marcostrullato/open_niryo_one/README.md

# Open Niryo One

This is the Open Niryo One project. 

The original Niryo One Project is covering very well the structure of the arm and the mechanicanics, but it has some gaps with the electonics. 

Here with ***Open Niryo One*** we are developing what's missing.

Special thanks to the original project team for the great work. 
[https://niryo.com](https://niryo.com/?utm_source=github)
