marcostrullato/open_niryo_one/Electronics/RPi_adapter/pinmap.txt

N	FUNCTION	SIGNAL		PIN@PLS40
1	FAN1		GPIO27		13
2	FAN2		GPIO23		16
3	FAN3		PWM		?
4	BUTTON		GPIO4		7
5	SWERVO1_TX	USART_TXD	8
6	SWERVO1_RX	USART_RXD	10
5	SWERVO2_TX	USART_TXD	?
6	SWERVO2_RX	USART_RXD	?
7	CAN_MOSI	MOSI		19
8	CAN_MISO	MISO		21
9	CAN_CLK		CLK		23
10	CAN_CE		CE		24
11	LED-R		GPIO18		12
12	LED-G		GPIO24		18
13	LED-B		GPIO22		15

14	1A		GPIO2		3
15	1B		GPIO3		5
16	1C		GPIO16		36
17	2A		GPIO26		37
18	2B		GPIO19		35
19	2C		GPIO6		31
20	SW1		GPIO12		32
20	SW2		GPIO13		33
