marcostrullato/open_niryo_one/Electronics/Stepper/ErrorList.txt

1. Change LED to 0603 chip
2. Resister (R3) for LED 330 Ohm
3. Change USB mounting slots
4. Mirror USB pins
5. PCB size: -2mm from each side
