marcostrullato/open_niryo_one/Electronics/RPi_adapter/PCB/RpiAdapterPCB.PcbDoc.htm

Reporting Options

# File in Newer Format

Date | : | 16.02.2020
Time | : | 21:35:11
Filename | : | D:\SOFTWARE\open_niryo_one\Electronics\RPi_adapter\PCB\RpiAdapterPCB.PcbDoc

Version | Warning
Release 14 | CAUTION - The Differential Pairs Routing rule added support for control of the width. Be aware that these widths must be manually entered as Width rules in this version.
Release 15 | CAUTION - Support of separate solder masks for top & bottom of pads added.
Release 15.1 | CAUTION - Support Multi-line PCB Text added.
Release 16.0 | CAUTION - Pad/Via hole size tolerance value added.

This file was generated by a later version of the software
