marcostrullato/open_niryo_one/Electronics/Niryo_rpi3_shield_and_panel_overview.pdf

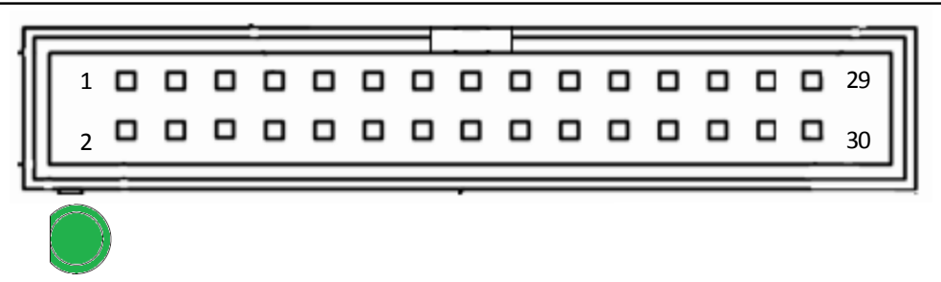
[picture p3: figure]
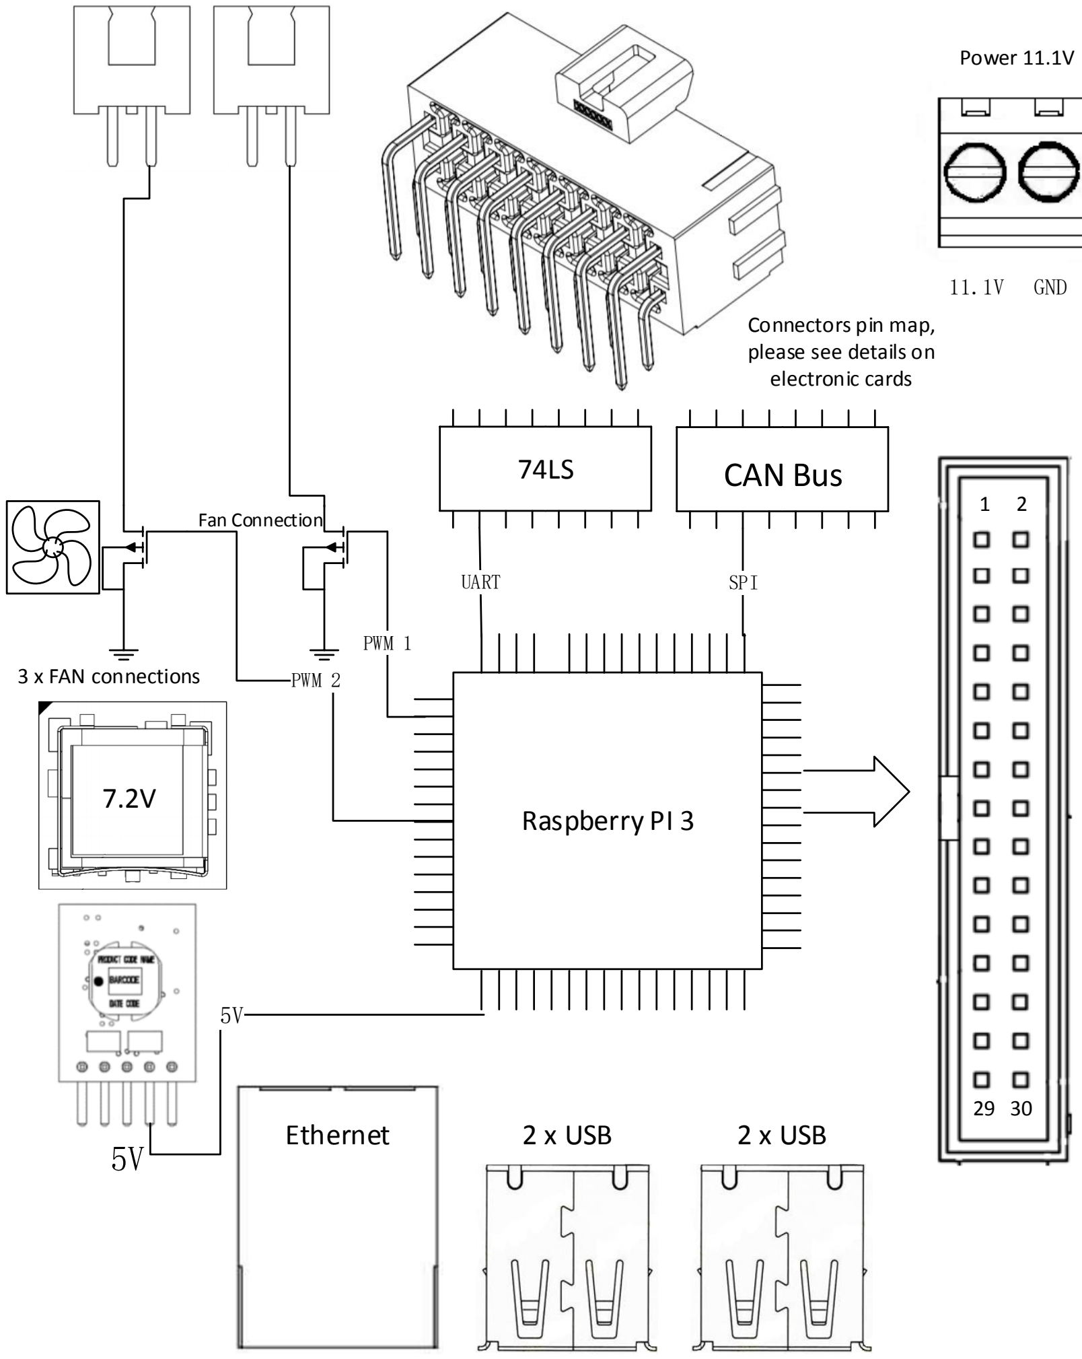
[picture p4: figure]
Raspberry PI 3; CAN Bus ⁷⁴LS; Power 11.1V; 3 x FAN connections; UART; SPI; PWM 2; PWM 1; GND; Fan Connection; Ethernet; 2 x USB; Connectors pin map, please see details on electronic cards

CANH CANL GND 11.1V | GND 7.2V DLX-Data1 | GND 11.1V
CANH CANL GND 11.1V | GND 11.1V

GND 5V 1A(IO2) 1B(IO3) 1C (IO16)

GND 5V 2A(IO26) 2B(IO19) 2C(IO6)
GND 7.2V DLX-Data2

NiryoShield Pin Map

Pin# | Name
01 | 7.2V DC Power
03 | DLX-Data
05 | 11.1V DC Power
07 | 11.1V DC Power
09 | 11.1V DC Power
11 | IO24
13 | GND
15 | GND
17 | GND
19 | GND
21 | 5V DC Power
23 | 5V DC Power
25 | IO2 SDA
27 | IO3 SCL
29 | IO16
Name | Pin#

7.2V DC Power 02

IO18 | 04
11.1V | 06
IO22 | 08
NC | 10
CANL | 12
CANH | 14
NC | 16
NC | 18
NC | 20
NC | 22
NC | 24
IO6 | 26
IO19 | 28
IO26 | 30

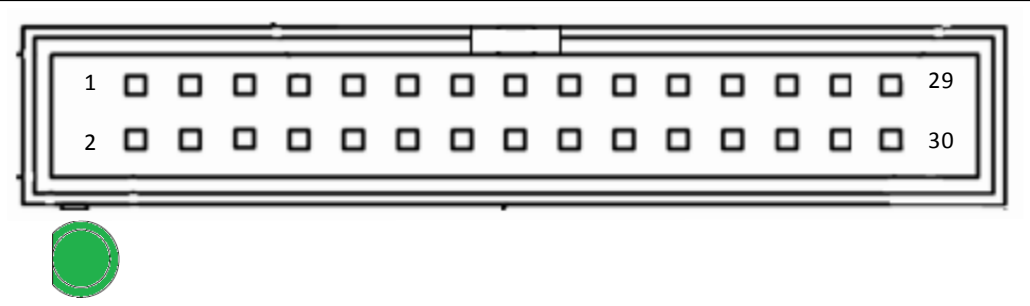
[picture p5: figure]

CANH CANL GND 11.1V GND 7.2V DLX-Data1 | GND 11.1V
CANH CANL GND 11.1V | GND 11.1V

GND 5V 1A(IO2) 1B(IO3) 1C (IO16)

GND 7.2V DLX-Data2 | GND 5V 2A(IO26) 2B(IO19) 2C(IO6)

Niryo Stepper 1

Niryo Stepper 2

XL-320

XL-430

SW1

SW2

GPIO1

GPIO2

## WARNING !

- Niryo Stepper 1 and Niryo Stepper 2 connectors are reserved. Don't use them.
- Only connect Dynamixel XL-320 motors to the XL-320 connector.
- Only connect Dynamixel XL-430 motors to the XL-430 connector.
- DO NOT short-circuit SW1 and SW2 pins.
- Absolute operating voltage of GPIO1 and GPIO2 connectors is 5V. External expander applications must operate at 5V. DO NOT short-circuit 5V and GND pins with any other pins.

! Wrong connection or wrong input voltage could permanently damage the robot or external micro-controller !
