marcostrullato/open_niryo_one/Electronics/Stepper/Components/mcp2515-can-bus-breakout-board-schematics.jpg

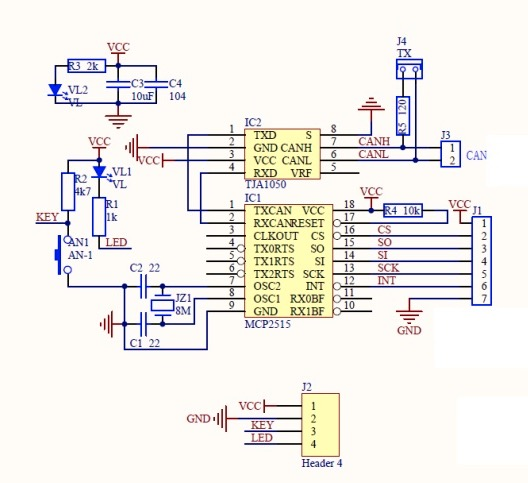
Electronics/Stepper/Components/mcp2515-can-bus-breakout-board-schematics.jpg
