marcostrullato/open_niryo_one/Electronics/Stepper/Render.png

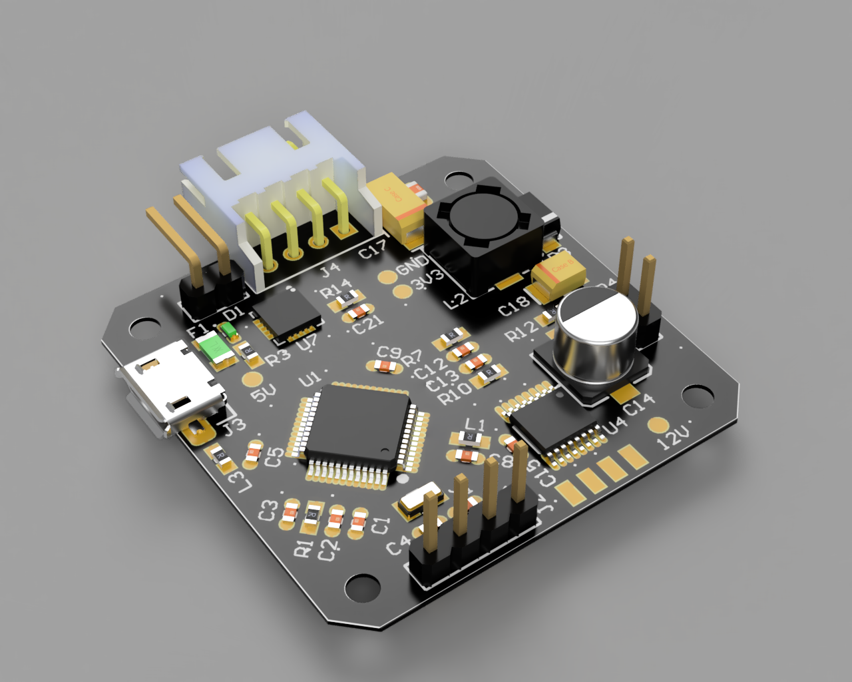
Electronics/Stepper/Render.png
