marcostrullato/open_niryo_one/BOM/Arm BOM.ods

Sheet: 3d_print_parts
What | Quantity
Base | 1
Belt Tensioner | 3
Base Bearing Support | 1
Shoulder | 1
Shoulder Gearing | 1
Belt Tensioner | 1
Round Tube | 4
Arm Bottom | 1
End Cap - Shoulder | 2
Arm Top | 1
Round Tube | 2
Belt Tensioner | 1
Elbow | 1
Foream Bottom | 1
Foream top | 1
Wrist | 1
Hand | 1
Drawer | 1
Air Routing | 3

Sheet: BOM_-_by_step
Step | What | Size | Quantity
Base | Motor | Orange NEMA 17 - 45 N.cm | 1
Base | Fan
Base | Button
Base | Bearing | 8x22x7 | 1
Base | Bearing | 3x10x4 | 3
Base | Brake nut | M3 | 2
Drawer | Screw | M2x5 | 4
Wrist | Screw | M2x5 | 4
Base | Gear | GT2 | 1
Shoulder | Motor | Yellow NEMA 17 - 65 N.cm | 1
Shoulder | Bearing | 3x10x4 | 2
Shoulder | Bearing | 8x22x7 | 2
Shoulder | Thrust Bearing | 8x19x7 | 1
Shoulder | Half Bearing | 90x120 | 1
Shoulder | Brake nut | M3 | 1
Elbow | Brake nut | M3 | 1
Drawer | Brake nut | M3 | 1
Drawer | Screw | M3x10 | 5
Base | Screw | M3x10 | 11
Shoulder | Screw | M3x10 | 10
Elbow | Screw | M3x10 | 10
Drawer | Screw | M3x16 | 2
Shoulder | Aluminium Tube |  | 1
Shoulder | Gear | GT2 | 1
Shoulder | Belt | GT2 | 1
Shoulder | Belt with red tape | GT2 | 1
Shoulder | Torsion spring |  | 1
Elbow | Motor | pink NEMA 17 - 65 N.cm | 1
Elbow | Motor | XL430 | 1
Elbow | Bearing | 3x10x4 | 2
Elbow | Bearing | 8x22x7 | 2
Elbow | Thrust Bearing | 8x19x7 | 1
Elbow | Thrust Bearing | 20x40x14 | 1
Elbow | Aluminium Tube |  | 1
Elbow | Coupling Shaft - Red motor |  | 1
Elbow | Gear | GT2 | 1
Elbow | Belt with green tape | GT2 | 1
Shoulder | Brake nut | M4 | 1
Elbow | Brake nut | M4 | 1
Drawer | Brake nut | M4 | 1
Elbow | Washer | M8 | 1
Base | Screw | M3x16 | 8
Shoulder | Screw | M3x16 | 6
Elbow | Screw | M3x16 | 2
Drawer | Screw | M3x5 | 2
Wrist | Screw | M3x5 | 2
Wrist | Motor | XL-430 | 1
Wrist | Motor | XL-320 | 1
Wrist | Bearing | 5x14x5 | 1
Wrist | Bearing | 6x19x6 | 1
Wrist | Coupling Shaft - Blue motor |  | 1
Wrist | Coupling Shaft - Green motor |  | 1
Wrist | Brake nut | M5 | 2
Wrist | Brake nut | M6 | 2
Wrist | Washer | M5 | 1
Drawer | Screw | M4x40 | 1
Shoulder | Screw | M4x40 | 1
Elbow | Screw | M4x40 | 1
Wrist | Screw | M5x40 | 1
Drawer | Ribbon cable |  | 1
Drawer | Raspi 3 |  | 1
Drawer | Panel |  | 1
Drawer | Shield |  | 1
Drawer | Label |  | 1
Drawer | DC Collector + cable |  | 1
Drawer | Power Switch |  | 1
Shoulder | Brake nut | M8 | 1
Elbow | Brake nut | M8 | 1
Wrist | Screw | M6x50 | 1
Elbow | Screw | M8x40 | 1
Shoulder | Screw | M8x55 | 1
Shoulder | Screw | M8x90 | 1
Elbow | Screw | M8x90 | 1

Sheet: BOM_-_overall
What | Size | Quantity
Bearing | 3x10x4 | 7
Bearing | 5x14x5 | 2
Bearing | 6x19x6 | 1
Bearing | 8x22x7 | 5
Aluminium Tube | 10 cm x 3.5 cm diameter | 2
Belt | GT2
Brake nut | M3 | 5
Brake nut | M4 | 3
Brake nut | M5 | 2
Brake nut | M6 | 2
Brake nut | M8 | 2
Fan | 12V 35x35 mm | 1
Button |  | 1
Gear | GT2, 16 teeth, 5mm hole | 3
Coupling Shaft - Red motor |  | 1
Coupling Shaft - Blue motor |  | 1
Coupling Shaft - Green motor |  | 1
DC Collector + cable | DC-022B | 1
Half Bearing | 90x120 | 1
Power Switch | KCD1 | 1
Screw | M2x5 | 8
Screw | DIN912 M3x10 | 36
Screw | DIN912 M3x16 | 18
Screw | DIN912 M3x5 | 4
Screw | DIN912 M4x40 | 3
Screw | DIN912 M5x40 | 1
Screw | DIN912 M6x50 | 1
Screw | DIN912M8x40 | 1
Screw | DIN912 M8x55 | 1
Screw | DIN912 M8x90 | 2
Washer | DIN9021 M5 | 1
Washer | DIN9021 M8 | 1
Thurst Bearing | 8x19x7 mm | 2
Thurst Bearing | 20x40x14 mm | 1
Belt | GT2 397 mm 6 mm | 1
Belt | GT2 345 mm 6 mm | 1
Belt | GT2 close 110 teeth 220 mm 6 mm
Torsion Spring |  | 1
Motor 45 N.cm | 17HS16-2004D | 1
Motor 65 N.cm | 17HS4218 | 2
Ribbon connector | IDC30 | 2
Ribbon 30 wires | 250 mm | 1
CAN bus connector | CHU-4 | 4

Sheet: BOM_-_Stepper_Shield
Type | Comment | Designator | Footprint | Quantity | Price, $ | Сost,$ | Analog | Comment2 | Availability
C | 0.1uF | C1, C3, C5, C7, C8, C9, C17, C18, C19, C20 | 0603 | 10 | 0,00405 | 0,0405 |  |  | +
C | 1uF | C2 | 0603 | 1 | 0,0045 | 0,0045 |  |  | +
C | 22pF | C4, C6, C21, C22 | 0603 | 4 | 0,0036 | 0,0144 |  |  | +
C | 10uF | C10 | 0603 | 1 | 0,0054 | 0,0054 |  |  | +
CE | 100uF x 35V | C11 | ALUM_CAP_D | 1 | 0,2346 | 0,2346 |  | electrolytic cap | +
C | 0.22uF | C12 | 0603 | 1 | 0,01495 | 0,01495 |  |  | +
C | 1uF*50V | C13 | 0805 | 1 | 0,01495 | 0,01495 |  |  | +
CT | 68uF x 16V | C14 | Tantal - C | 1 | 0,112 | 0,112 |  | Tantal cap | -
CT | 100uF x 10V | C15 | Tantal - B | 1 | 0,148 | 0,148 |  | Tantal cap | -
C | 4.7nF | C16 | 0603 | 1 | 0,0036 | 0,0036 |  |  | +
LED | KP-3216 | D1 | 1632 | 1 | 0 | 0 | not necessary | System LED | +
D | 1N4148WC | D2, D7 | SOD323 | 2 | 0,0088 | 0,0176 | 1N4148 | Reverse voltage protection | +
D | 10MQ040 | D3 | DO214-AC | 1 | 0,292 | 0,292 | 10MQ060 | Voltage Regulator diod | +
D | CG0603MLC-05E | D4, D5 | CG0603MLC-05E | 2 | 0,05 | 0,1 | SM6T27CA | USB ESD protection | -
D | US-1G | D6 | DO-214AB | 1 | 0,398 | 0,398 |  | Reverse voltage protection | +
F | 1206L050 | F1 | 1206 | 1 | 0,0636 | 0,0636 | MF-NSMF050-2 | Fuse 0,5 A | -
F | 1206L200 | F2 | 1206 | 1 | 0,035 | 0,035 | MF-NSMF200-2 | Fuse 2A | -
J | PLS-2 | JP1 | PLS-2 | 1 | 0,08 | 0,08 | not necessary | Fan connector | +
J | PLS-5 | J2 | PLS-5 | 1 | 0,09 | 0,09 |  | Boot connector | +
J | CUI UJ2-MIBH2-4-SMT-TR | J3 | UJ2-MIBH2-4-SMT | 1 | 0,1 | 0,1 |  | USB | -
J | CWF-4R | J4 | CWF-4R | 1 | 0,09 | 0,09 |  | power+CAN | +
J | PLS-2R | JP2 | PLS-2R | 1 | 0,08 | 0,08 |  | Terminator | +
L | BLM18PG601SH1 | L1, L3 | 0603 | 2 | 0,08 | 0,16 |  |  | +
L | CDRH74NP-101MC-B | L2 | CDRH74 | 1 | 0,1185 | 0,1185 |  | Voltage Regulator | +
Q | IRLML6402 | Q1 | SOT23 | 1 | 0,0415 | 0,0415 |  | Fan transistor coil | +
R | 10K | R1, R2, R11 | 0603 | 3 | 0,0062 | 0,0186 |  |  | +
R | 62R | R3 | 0603 | 1 | 0,0062 | 0,0062 | not necessary | LED resistor
R | 0R | R4 | 0R 0603 | 1 | 0,0062 | 0,0062 |  | CW/CCW selector | +
R | 4K7 | R5, R6 | 0603 | 2 | 0,0062 | 0,0124 |  |  | +
R | 0.15RF | R7, R8 | 1206 | 2 | 0,00995 | 0,0199 |  | Stepper LESS | -
R | 5K6F | R9 | 0603 | 1 | 0,0062 | 0,0062 |  | 1% tolerance | +
R | 3K32F | R10 | 0603 | 1 | 0,0062 | 0,0062 |  | 1% tolerance | +
R | 120R | R12 | 1206 | 1 | 0,004466667 | 0,004466667 |  | Terminator | +
U | ATSAMD21G18A-AUT | U1 | LQFP48 | 1 | 6 | 6 |  | Atmel processor
U | TC1047 | U2 | SOT23 | 1 | 0,18 | 0,18 |  | Temperature Sensor | -
U | AS5600 | U3 | SOIC8 | 1 | 1,84 | 1,84 |  | program magnetic rotary position sensor | -
U | A4954 | U4 | TSSOP-16 | 1 | 0,958 | 0,958 |  | DMOS PWM Motor Driver | -
U | LM2594M-ADJ | U5 | SOIC8 | 1 | 0,346 | 0,346 |  | Step-Down Voltage Regulator | +
U | SN65HVD230D | U6 | SOIC8 | 1 | 0,386 | 0,386 |  | CAN Bus Transceivers | -
U | MCP2515 | U7 | QFN20 | 1 | 0,89 | 0,89 |  | Stand-Alone CAN Controller With SPI | -
Y | NX3215SA-32.768K-STD-MUA-8 | Y1 | NX3215SA | 1 | 0,458 | 0,458 |  | Frequency resonator | -
Y | KX-K 16 MHZ | Y2 | 5032 | 1 | 0,095 | 0,095 |  | Frequency resonator | -
 | PCB |  |  | 1 | 1 | 1 |  |  | -
 |  |  |  |  |  | 14,49226667 |  |  | 12,1255
