marcostrullato/open_niryo_one/Electronics/RPi_adapter/OUT/R1/RPI_Hat_BOM.xlsx

Comment | Description | Designator | Footprint | Quantity
22pF |  | C1, C2 | 0603 | 2
0.1uF |  | C3, C4, C5, C6, C7 | 0603 | 5
25ZLQ470MEFC8X16 | 470uF x 25V | C8, C11, C14 | 8x16 | 3
3.3nF |  | C9, C15 | 0603 | 2
TANT 220uF 10V |  | C10, C16 | Tantal - D | 2
1nF |  | C12 | 0603 | 1
TANT 100uF 16V B3528 |  | C13 | Tantal - B | 1
SM6T30CA | ESD protection | D1 | DO-214AA | 1
10MQ040NTRPBF | Rectifier diode | D2, D3, D4, D5 | DO214-AC | 4
FH-100 | Fuse holder 5x20 mm | F1 | KLS5-266 | 2
5-146280-2 | Connector | J1 | PLS-2 | 1
XH2.54MM 4pins |  | J2 | CWF-4 | 1
XH2MM 3pins | Conector | J3 | DS1066-03 | 1
XH2.54MM 3pins | Conector | J4 | CWF-3 | 1
M20-7832046 |  | J5 | PBD40 | 1
70246-3001 |  | J6 | BH-30 | 1
5-146280-4 | PLS-4 | J7 | PLS-4 | 1
XH2.54MM 2pins | Connector | J8, J9, J10, J11 | CWF-2 | 4
MCV 1,5/ 2-G-3,81 |  | J12 | CON_2_5.08 | 1
CDRH74NP-680MC-B |  | L1, L2, L3 | CDRH74 | 3
IRLML2402TRPBF | n-chanal MOSFET | Q1, Q2, Q3, Q4, Q5, Q9 | SOT23 | 6
IRLML6402TRPBF | p-chanal MOSFET | Q6, Q7, Q8 | SOT23 | 3
10K |  | R1, R3, R4, R5, R6, R7, R8, R9, R10, R11, R12, R13, R14, R15, R16, R17, R18, R19 | 0603 | 18
120R |  | R2 | 1206 | 1
1K 1% |  | R20 | 0603 | 1
3K 1% |  | R21 | 0603 | 1
1.5K 1% |  | R22 | 0603 | 1
12K 1% |  | R23 | 0603 | 1
6.8K 1% |  | R24 | 0603 | 1
33K 1% |  | R25 | 0603 | 1
MCP2515T-I/ML |  | U1 | QFN20 | 1
SN65HVD230D |  | U2 | SOIC8 | 1
CD74HC126M96 |  | U3 | SOIC14 | 1
CD74HC04M |  | U4 | SOIC14 | 1
LM2596T-ADJ/NOPB |  | U5, U6, U7 | TO-220-5 | 3
NX5032GA-16.000M-STD-CSU-2 | 16 MHz cristal | Y1 | 5032 | 1
