marcostrullato/open_niryo_one/Electronics/RPi_adapter/OUT/R2/BOM.xlsx

Comment | Description | Designator | Footprint | Quantity
22pF |  | C1, C2 | CHIP_C_0603 | 2
0.1uF |  | C3, C4, C5, C6, C7 | CHIP_C_0603 | 5
470uF x 25V |  | C8, C11, C14 | ALCAP_8x16 | 3
3.3nF |  | C9, C15 | CHIP_C_0603 | 2
220uF x 10V |  | C10, C16 | Tantal - D | 2
1nF |  | C12 | CHIP_C_0603 | 1
100uF x 16V |  | C13 | Tantal - B | 1
SM6T30CA | ESD protection | D1 | DO-214AA | 1
10MQ040 | Rectifier diode | D2 | DO214-AC | 1
10MQ040(60) | Rectifier diode | D3, D4, D5 | DO214-AC | 3
FH-100 |  | F1 | FH-100 | 1
PLS-2 | Connector | J1 | PLS-2 | 1
CWF-4 |  | J2 | CWF-4 | 1
CWF-3(R) | Conector | J3 | DS1066-03 | 1
CWF-3(R) | Conector | J4 | CWF-3 | 1
PBD40 |  | J5 | PBD40 | 1
BH-30 |  | J6 | BH-30 | 1
PLS-4 | PLS-4 | J7 | PLS-4 | 1
CWF-2 | Connector | J8, J9, J10, J11 | CWF-2 | 4
MCV 1,5/ 2-G-3,81 |  | J12 | CON_2_5.08 | 1
CDRH74NP-680MC-B |  | L1, L2, L3 | CDRH74 | 3
IRLML6402 | p-chanal MOSFET | Q1, Q2, Q3, Q4, Q5, Q6 | SOT23 | 6
IRLML2402 | n-chanal MOSFET | Q7, Q8, Q9 | SOT23 | 3
10K |  | R1, R3, R4, R5, R6, R7, R8, R9, R10, R11, R12, R13, R14, R15, R16, R17, R18, R19 | CHIP_R_0603 | 18
120R |  | R2 | CHIP_R_1206 | 1
1K |  | R20 | CHIP_R_0603 | 1
3K |  | R21 | CHIP_R_0603 | 1
1K5 |  | R22 | CHIP_R_0603 | 1
12K |  | R23 | CHIP_R_0603 | 1
6K8 |  | R24 | CHIP_R_0603 | 1
33K |  | R25 | CHIP_R_0603 | 1
MCP2515 |  | U1 | QFN20 | 1
SN65HVD230D |  | U2 | SOIC8 | 1
74HC126 |  | U3 | SOIC14 | 1
74HC04 |  | U4 | SOIC14 | 1
LM2596-ADJ |  | U5, U6, U7 | TO-220-5 | 3
KX-K 16 MHZ |  | Y1 | CHIP_CRYSTAL_5032 | 1
