marcostrullato/open_niryo_one/Electronics/Stepper/OUT/R2/BOM.xlsx

Comment | Description | Designator | Footprint | Quantity
0.1uF |  | C1, C3, C5, C8, C9, C10, C12, C13, C20, C21, C22, C23 | 0603 | 12
1uF |  | C2 | 0603 | 1
22pF |  | C4, C6, C24, C25 | 0603 | 4
10uF x 6V3 |  | C11 | 0603 | 1
100uF x 35V | EEV107M035A9HAA | C14 | ALUM_CAP_D | 1
0.22uF |  | C15 | 0603 | 1
1uF |  | C16 | CHIP_C_0805 | 1
68uF x 16V | C6032 | C17 | TANTAL - C | 1
100uF x 10V | B3528 | C18 | Tantal - B | 1
4.7nF |  | C19 | 0603 | 1
APT1608QBC/D |  | D1, D4 | 0603 | 2
1N4148WC-7-F |  | D2 | SOD323 | 1
10MQ040NTRPBF | Rectifier diode | D3 | DO214-AC | 1
US-1G |  | D5 | DO214-AC | 1
1206L050YR | Fuse | F1 | 1206Lxxx | 1
1206L200PR | Fuse | F2 | 1206Lxxx | 1
5-146280-2 | PLS-2 | J1 | PLS-2 | 1
5-146280-4 | PLS-4 | J2 | PLS-4 | 1
TE 1981584-1 | Micro USB connector | J3 | MicroUSB-mc-258 | 1
XH2.54MM 4pins right | CWF-4 | J4 | CWF-4R | 1
L-KLS1-207-1-02-R | PLS-2R | JP1 | PLS-2R | 1
BLM18PG471SN1D |  | L1, L3 | 0603 | 2
CDRH74NP-101MC | Ferrite drum core construction | L2 | CDRH74 | 1
IRLML2402 | n-chanal MOSFET | Q1 | SOT23 | 1
10K |  | R1, R2, R14 | 0603 | 3
1K |  | R3, R12 | 0603 | 2
0R |  | R4 | 0603 | 1
4K7 |  | R5, R6 | 0603 | 2
0R |  | R7, R10 | 0603 | 2
0.15R 1% | Resistor | R8, R9 | 1206 | 2
5.6K 1% |  | R11 | 0603 | 1
3.32K 1% |  | R13 | 0603 | 1
120R |  | R15 | 1206 | 1
ATSAMD21G18-AUT |  | U1 | LQFP48 | 1
TC1047AVNBTR | Temperature Sensor | U2 | SOT23 | 1
AS5600-ASOM | program magnetic rotary position sensor | U3 | SOIC8 | 1
A4954ELPTR-T | DMOS PWM Motor Driver | U4 | TSSOP-16P | 1
LM2594M-ADJ/TR |  | U5 | SOIC8 | 1
SN65HVD230D |  | U6 | SOIC8 | 1
MCP2515T-I |  | U7 | QFN20 | 1
NX3215SA-32.768K-STD-MUA-8 | 32,768 KHz cristal | Y1 | NX3215SA | 1
NX5032GA-16.000M-STD-CSU-2 | 16 MHz cristal | Y2 | 5032 | 1
