marcostrullato/open_niryo_one/Electronics/RPi_adapter/Components/Nyrio_Adapter.png

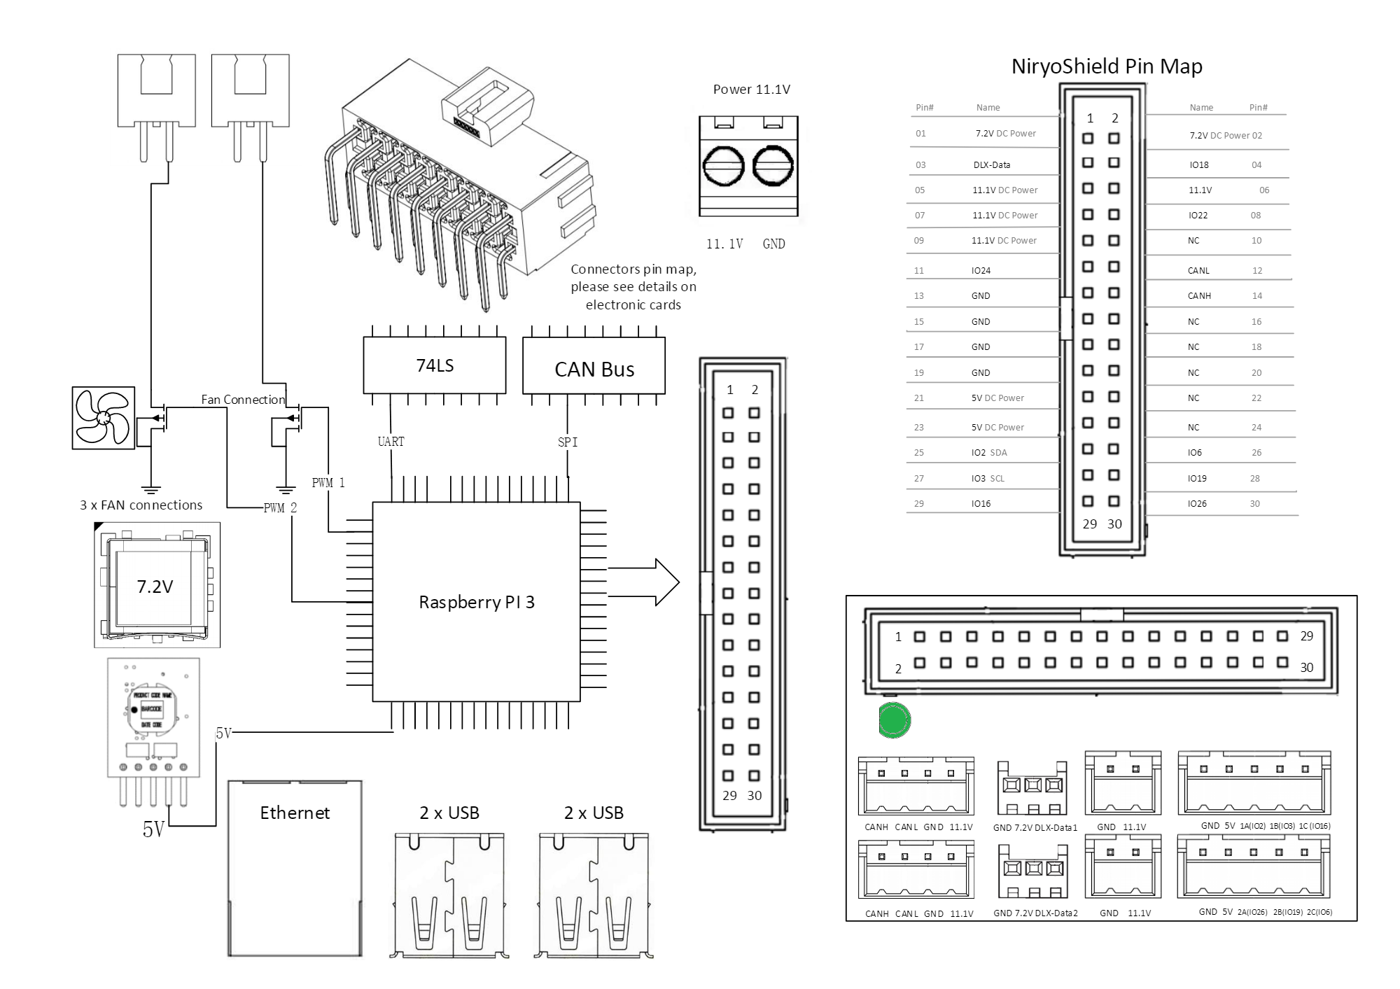
Electronics/RPi_adapter/Components/Nyrio_Adapter.png
