marcostrullato/open_niryo_one/STL/7-Tools/Gripper2/G2_MainSupport.STL

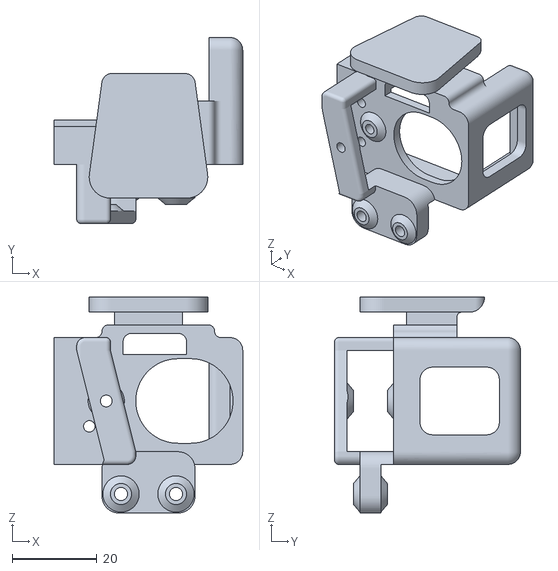
[picture p9: CAD file, 2019-08-29]
STL/7-Tools/Gripper2/G2_MainSupport.STL
44.6 x 44.0 x 51.1
