marcostrullato/open_niryo_one/STL/8-Other/AssemblyTool2.STL

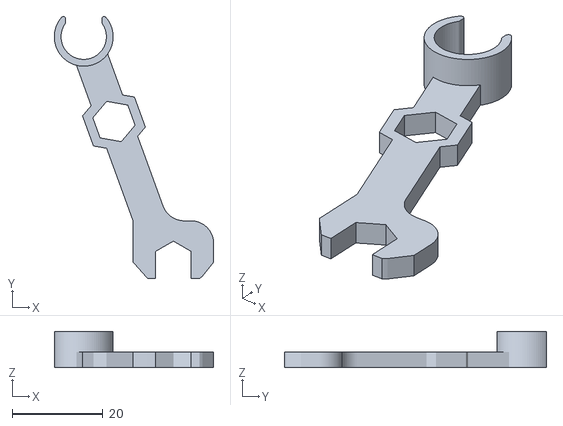
[picture p10: CAD file, 2019-08-29]
STL/8-Other/AssemblyTool2.STL
35.2 x 57.8 x 8.00
