marcostrullato/open_niryo_one/STL/8-Other/AssemblyTool1.STL

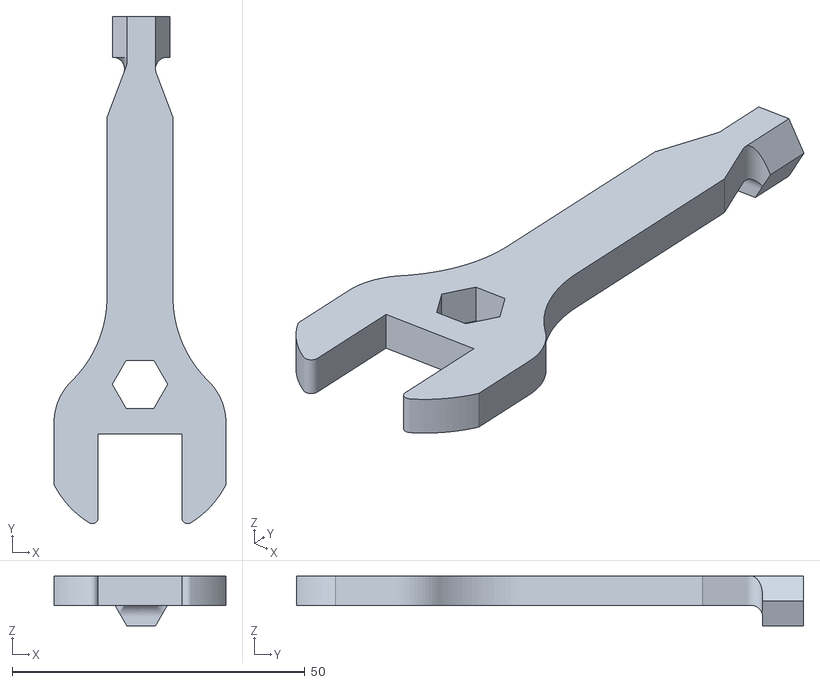
[picture p12: CAD file, 2019-08-29]
STL/8-Other/AssemblyTool1.STL
29.4 x 86.7 x 8.50
