marcostrullato/open_niryo_one/STL/7-Tools/Gripper1/G1_MainSupport.STL

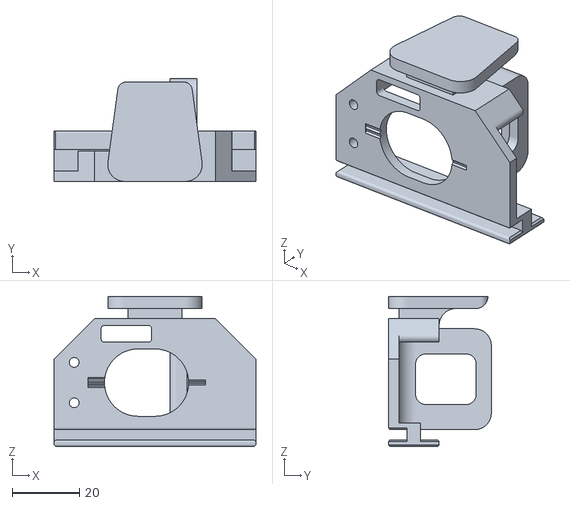
[picture p13: CAD file, 2019-08-29]
STL/7-Tools/Gripper1/G1_MainSupport.STL
60.0 x 30.5 x 44.6
