marcostrullato/open_niryo_one/Electronics/Panel/3D/PCB_shape.stp

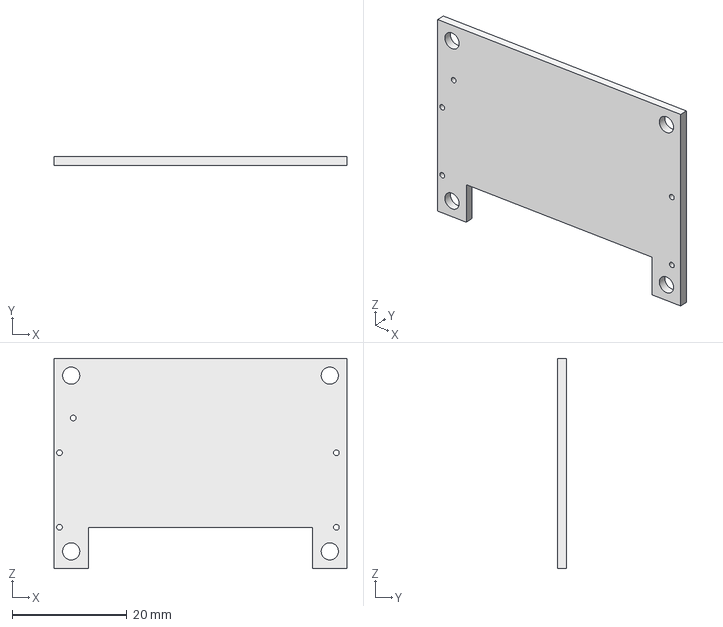
[picture p14: CAD file, 2022-10-08]
Electronics/Panel/3D/PCB_shape.stp
51.1 x 1.50 x 36.7 mm
