marcostrullato/open_niryo_one/Electronics/RPi_adapter/3D/INPUT_SIZE/PCB_shape.stp

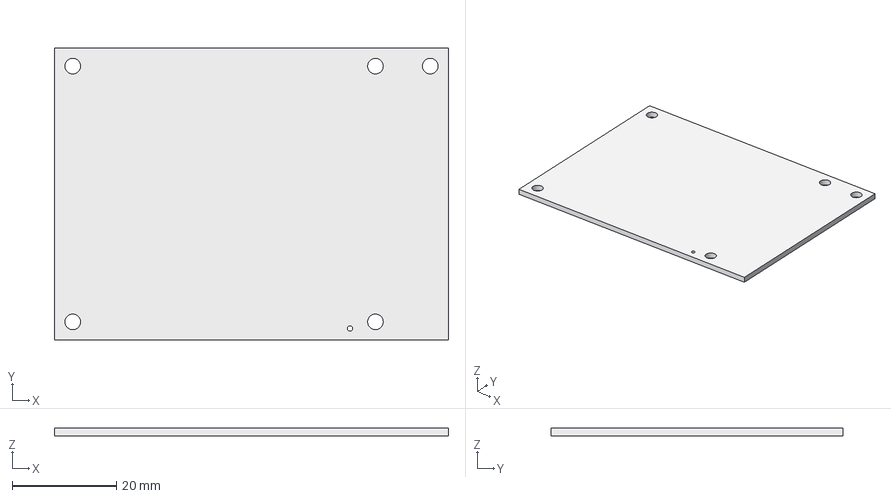
[picture p15: CAD file, 2022-10-08]
Electronics/RPi_adapter/3D/INPUT_SIZE/PCB_shape.stp
75.5 x 56.0 x 1.50 mm
