marcostrullato/open_niryo_one/Electronics/Stepper/3D/FAN/30mm Fan.step

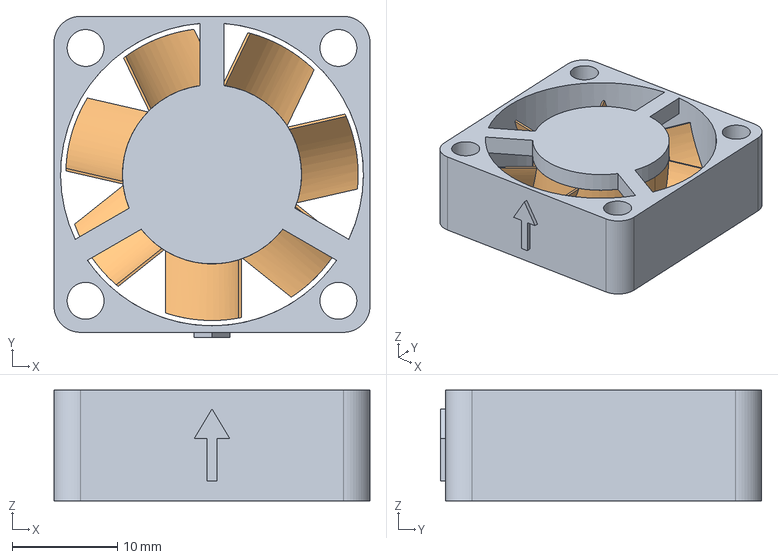
[picture p16: CAD file, 2022-10-08]
Electronics/Stepper/3D/FAN/30mm Fan.step
30.0 x 30.5 x 10.5 mm
