marcostrullato/open_niryo_one/Electronics/Stepper/3D/NEMA17/NEMA17 - Motor de passo.stp

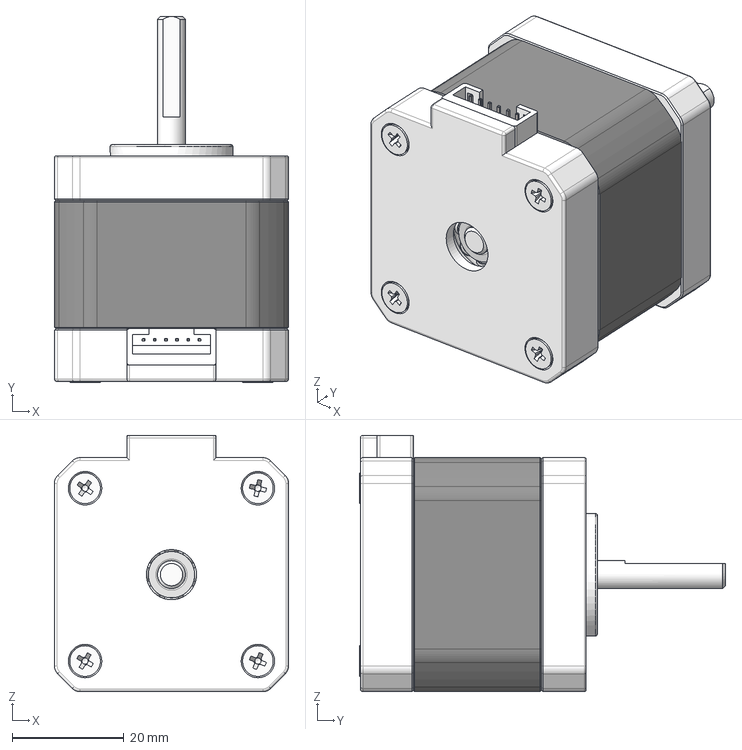
[picture p17: CAD file, 2022-10-08]
Electronics/Stepper/3D/NEMA17/NEMA17 - Motor de passo.stp
42.0 x 65.7 x 46.0 mm
