marcostrullato/open_niryo_one/Electronics/Stepper/3D/PCBmaket.stp

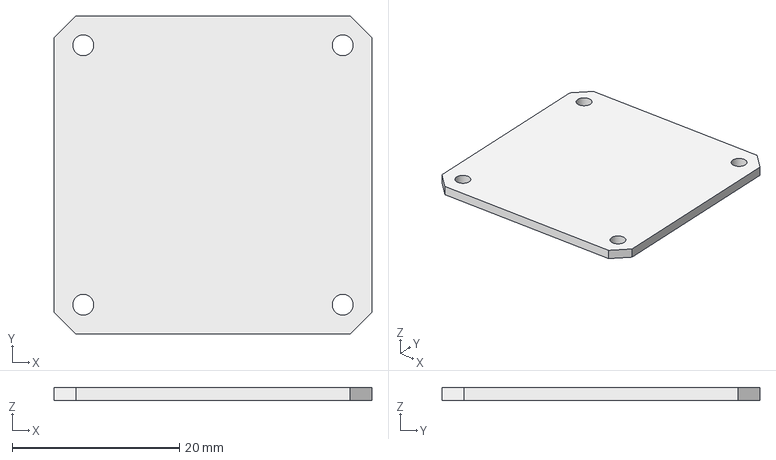
[picture p18: CAD file, 2022-10-08]
Electronics/Stepper/3D/PCBmaket.stp
38.0 x 38.0 x 1.50 mm
