marcostrullato/open_niryo_one/Electronics/Wiring/3D/CHU3.step

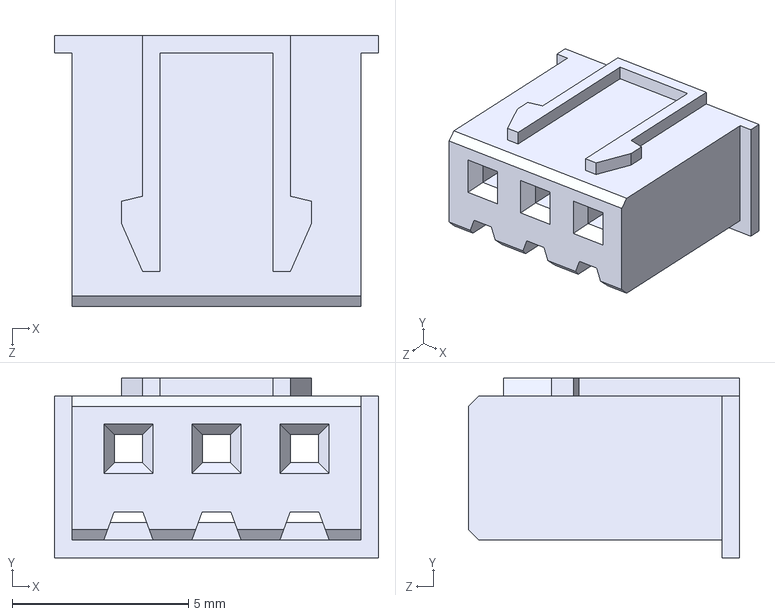
[picture p19: CAD file, 2022-10-08]
Electronics/Wiring/3D/CHU3.step
9.20 x 5.10 x 7.70 mm
