marcostrullato/open_niryo_one/Mechanic parts/STEP/Spring for Open Niryo One.stp

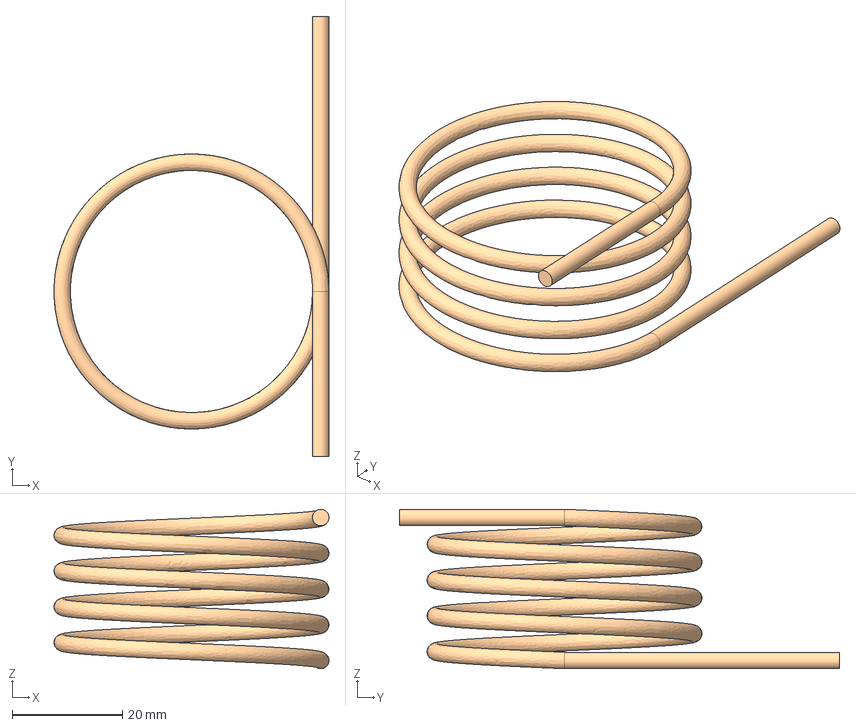
[picture p20: CAD file, 2022-10-08]
Mechanic parts/STEP/Spring for Open Niryo One.stp
50.0 x 80.0 x 29.0 mm
