marcostrullato/open_niryo_one/Mechanic parts/STL/Stepper spacer.stl

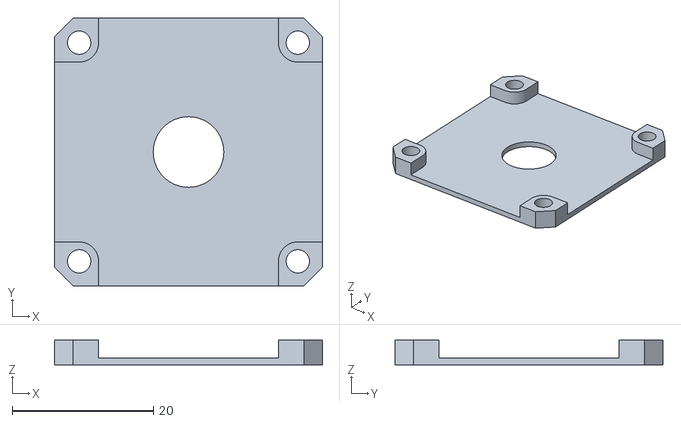
[picture p21: CAD file, 2022-10-08]
Mechanic parts/STL/Stepper spacer.stl
38.0 x 38.0 x 3.50
