marcostrullato/open_niryo_one/STL/0-Base/AirRouting.STL

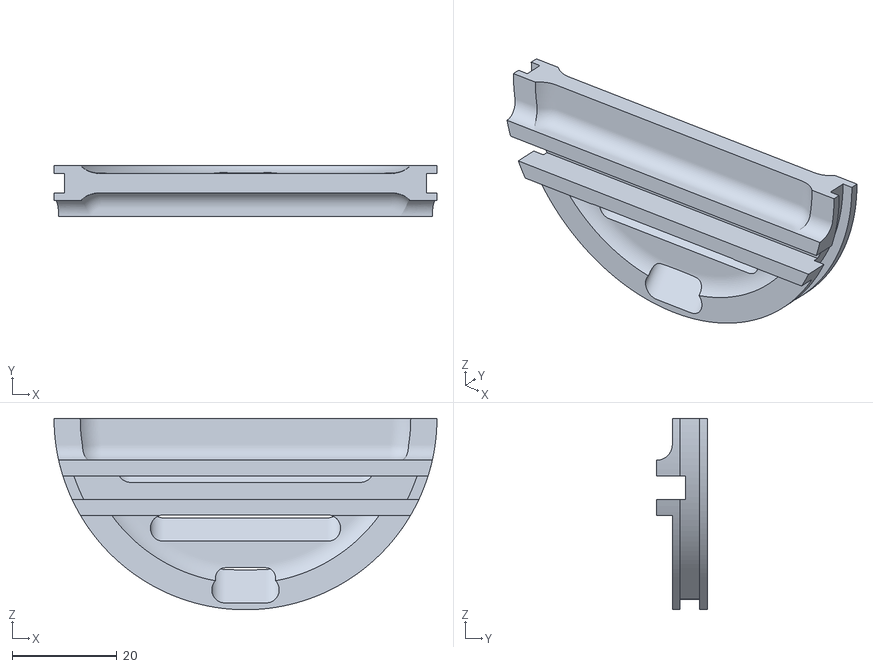
[picture p22: CAD file, 2019-08-29]
STL/0-Base/AirRouting.STL
73.0 x 9.70 x 36.5
