marcostrullato/open_niryo_one/STL/1-Shoulder/RoundTube.STL

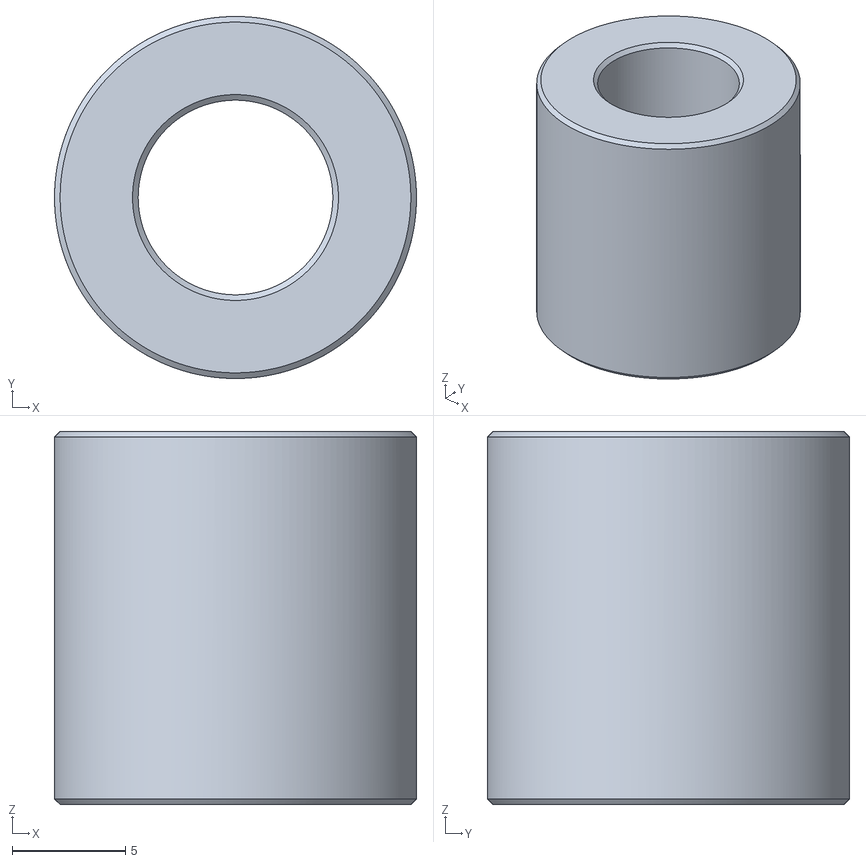
[picture p23: CAD file, 2019-08-29]
STL/1-Shoulder/RoundTube.STL
16.0 x 16.0 x 16.5
