marcostrullato/open_niryo_one/STL/2-Arm/EndCapArm.STL

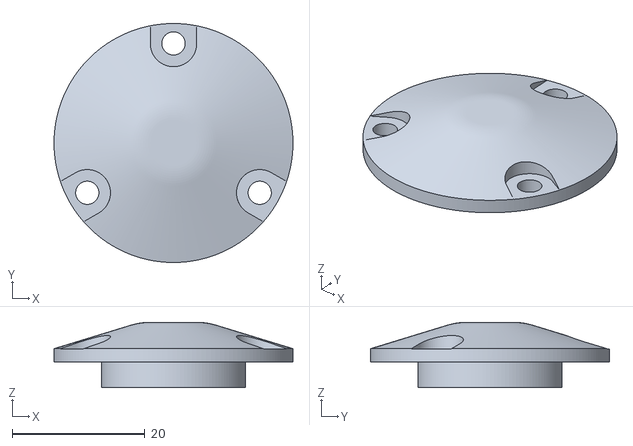
[picture p24: CAD file, 2019-08-29]
STL/2-Arm/EndCapArm.STL
36.0 x 36.0 x 9.85
