marcostrullato/open_niryo_one/STL/4-ForeArm/ForeArmBottom.STL

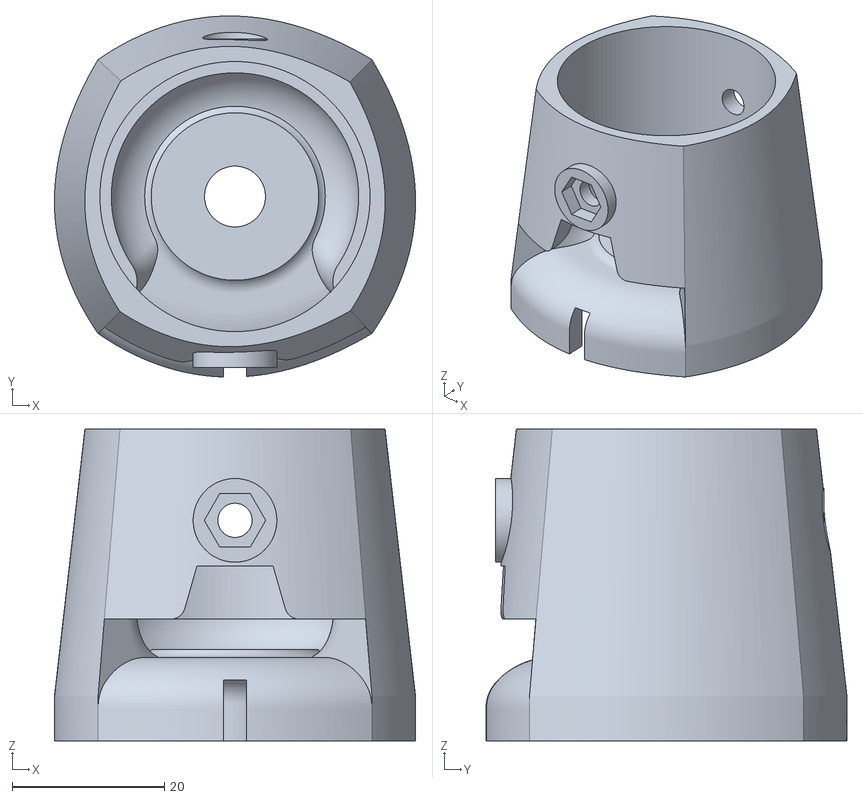
[picture p25: CAD file, 2019-08-29]
STL/4-ForeArm/ForeArmBottom.STL
47.5 x 47.4 x 41.0
