marcostrullato/open_niryo_one/STL/5-Wrist/Wrist.STL

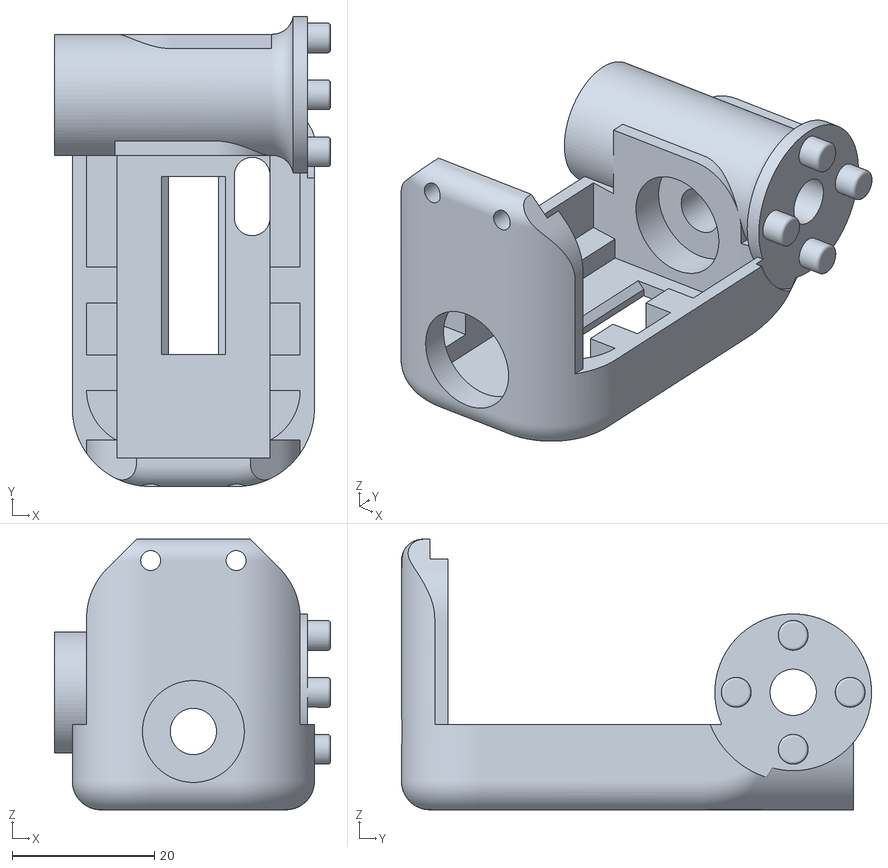
[picture p26: CAD file, 2019-08-29]
STL/5-Wrist/Wrist.STL
38.8 x 66.0 x 38.0
