marcostrullato/open_niryo_one/STL/6-Hand/Hand.STL

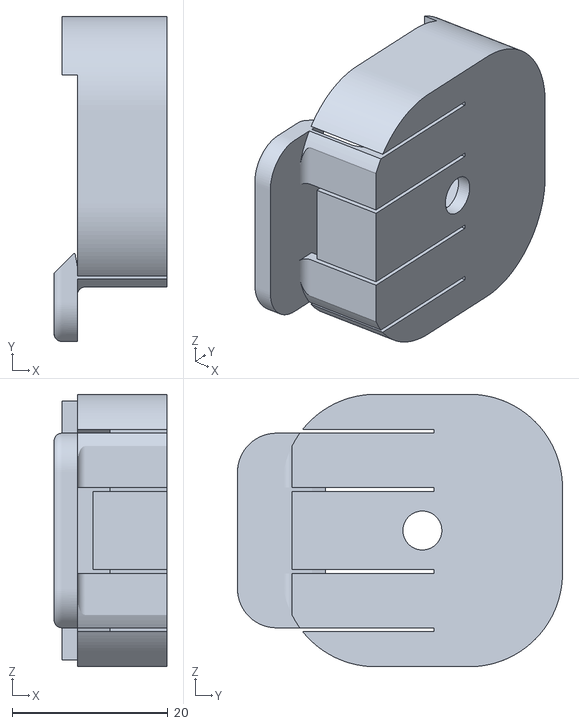
[picture p27: CAD file, 2019-08-29]
STL/6-Hand/Hand.STL
14.5 x 41.8 x 35.0
