marcostrullato/open_niryo_one/STL/7-Tools/Gripper1/G1_ClampRight.STL

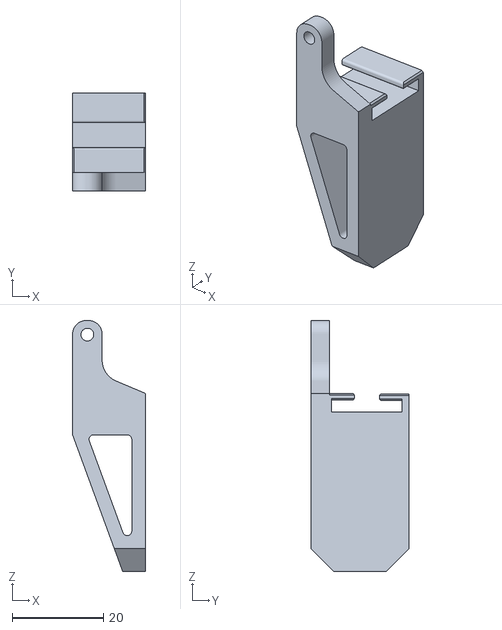
[picture p28: CAD file, 2019-08-29]
STL/7-Tools/Gripper1/G1_ClampRight.STL
16.0 x 21.5 x 55.1
