marcostrullato/open_niryo_one/STL/7-Tools/Gripper3/G3_Rod.STL

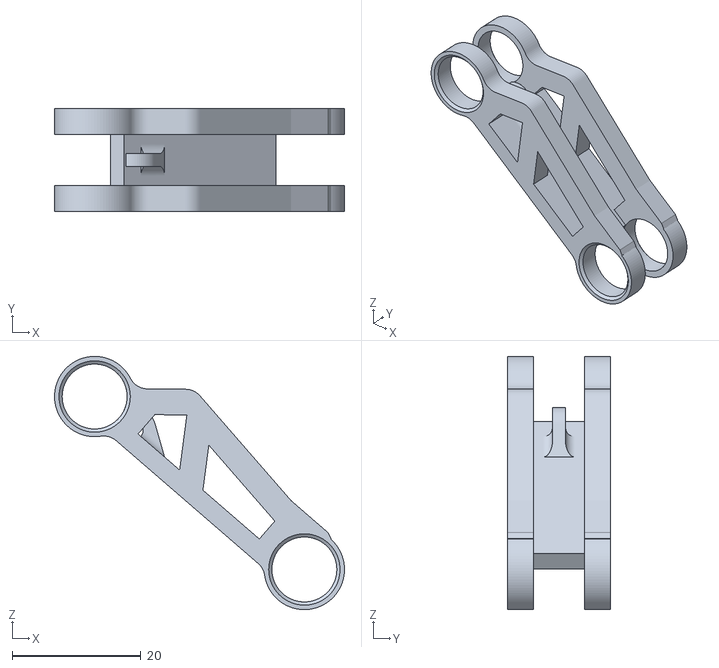
[picture p29: CAD file, 2019-08-29]
STL/7-Tools/Gripper3/G3_Rod.STL
45.1 x 16.0 x 39.4
