marcostrullato/open_niryo_one/STL/Tube/Niryo_One_Aluminum_Tube.stl

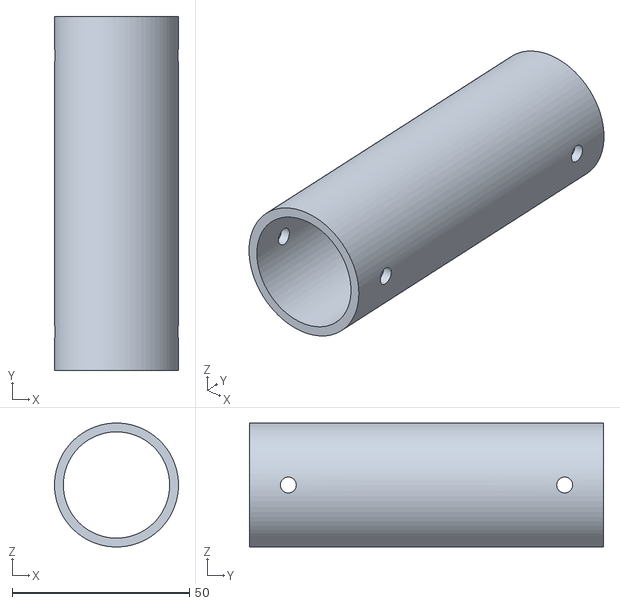
[picture p30: CAD file, 2022-10-08]
STL/Tube/Niryo_One_Aluminum_Tube.stl
35.0 x 100.0 x 35.0
