marcostrullato/open_niryo_one/Electronics/Wiring/3D/CHU2.step

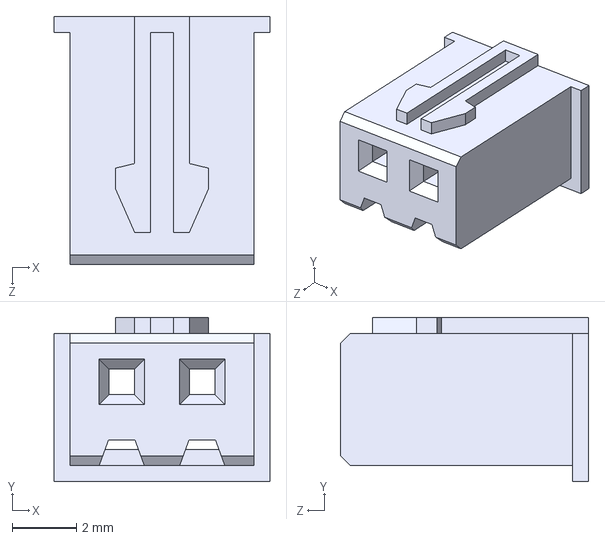
[picture p31: CAD file, 2022-10-08]
Electronics/Wiring/3D/CHU2.step
6.70 x 5.10 x 7.70 mm
