marcostrullato/open_niryo_one/Mechanic parts/STEP/Coupling Shaft Green Motor.stp

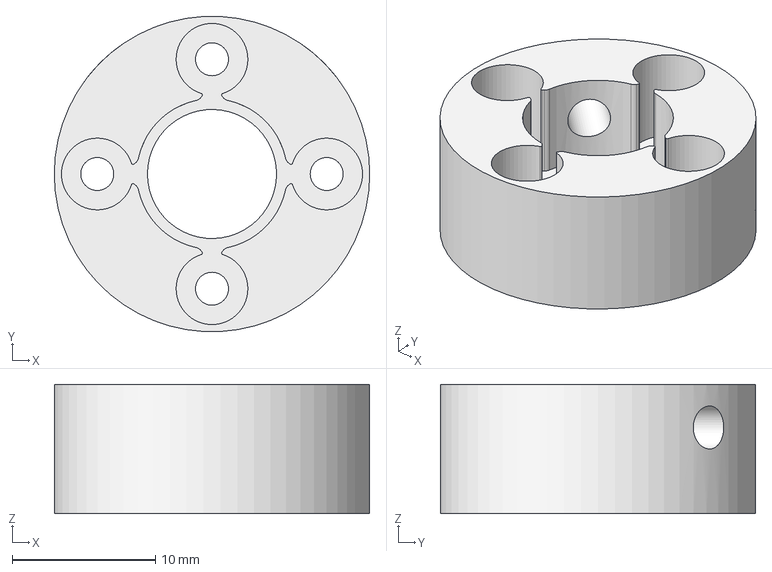
[picture p32: CAD file, 2022-10-08]
Mechanic parts/STEP/Coupling Shaft Green Motor.stp
22.0 x 22.0 x 9.00 mm
