marcostrullato/open_niryo_one/STL/0-Base/BaseBearingSupport.STL

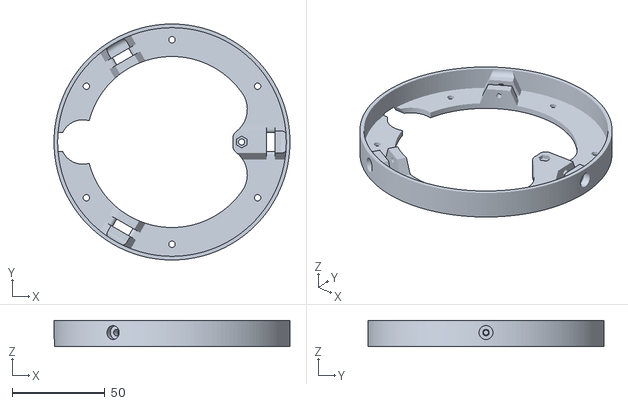
[picture p33: CAD file, 2019-08-29]
STL/0-Base/BaseBearingSupport.STL
127.0 x 127.0 x 14.0
