marcostrullato/open_niryo_one/STL/1-Shoulder/EndCapShoulder.STL

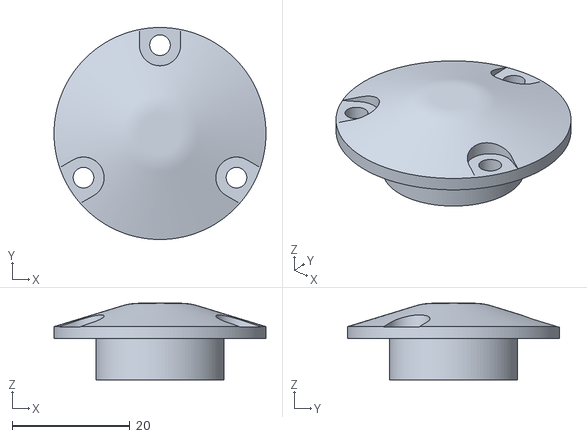
[picture p34: CAD file, 2019-08-29]
STL/1-Shoulder/EndCapShoulder.STL
36.0 x 36.0 x 13.0
