marcostrullato/open_niryo_one/STL/4-ForeArm/ForeArmTop.STL

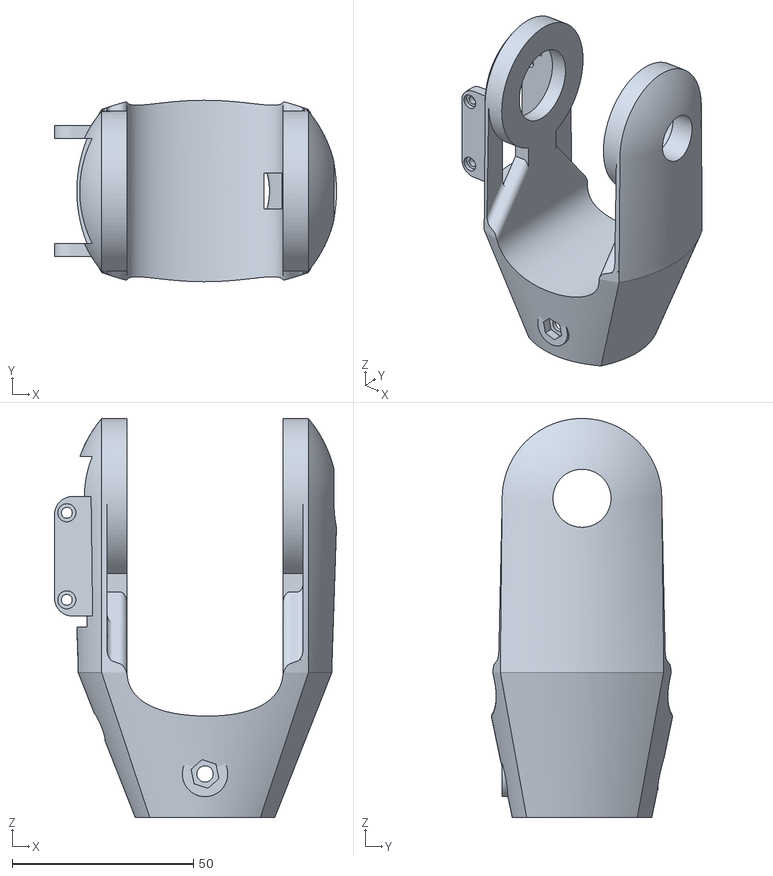
[picture p35: CAD file, 2019-08-29]
STL/4-ForeArm/ForeArmTop.STL
77.7 x 50.0 x 110.0
