marcostrullato/open_niryo_one/STL/7-Tools/Gripper1/G1_ServoHead.STL

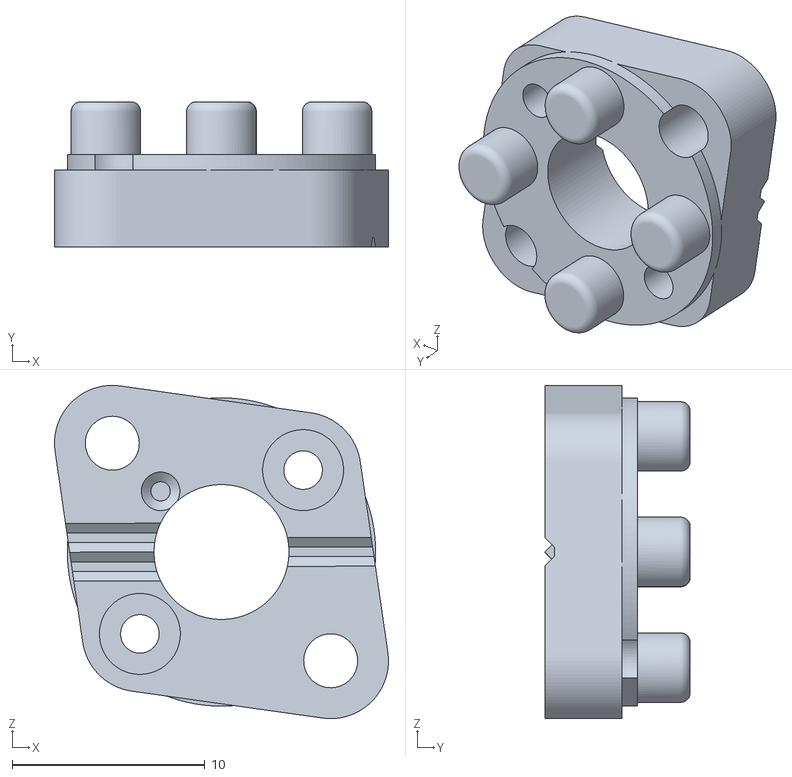
[picture p36: CAD file, 2019-08-29]
STL/7-Tools/Gripper1/G1_ServoHead.STL
17.3 x 7.55 x 17.3
