marcostrullato/open_niryo_one/STL/7-Tools/Gripper2/G2_GearRight.STL

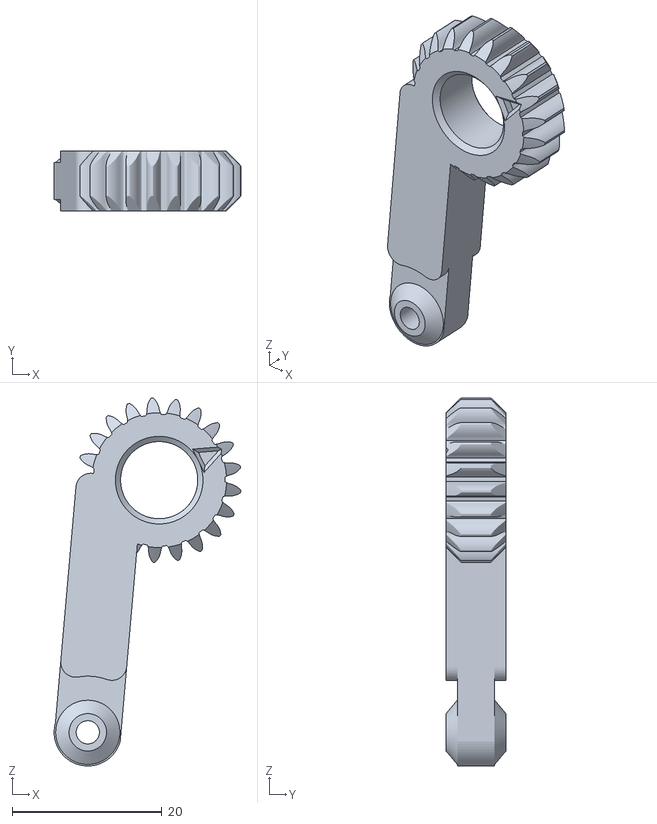
[picture p37: CAD file, 2019-08-29]
STL/7-Tools/Gripper2/G2_GearRight.STL
24.9 x 8.00 x 49.1
