marcostrullato/open_niryo_one/Electronics/Wiring/3D/CHU4.step

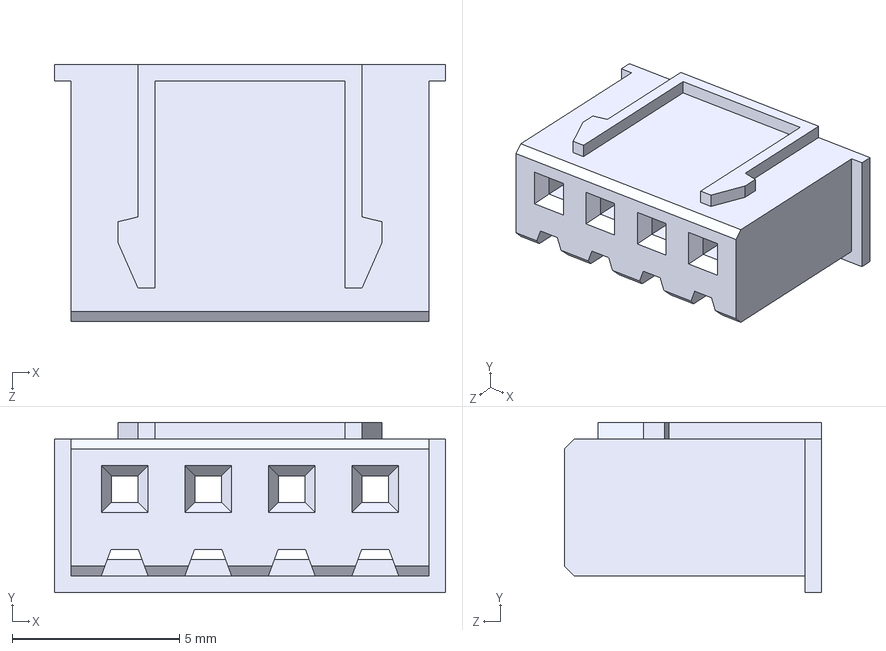
[picture p38: CAD file, 2022-10-08]
Electronics/Wiring/3D/CHU4.step
11.7 x 5.10 x 7.70 mm
