marcostrullato/open_niryo_one/Mechanic parts/STEP/Steal for Gripper1.stp

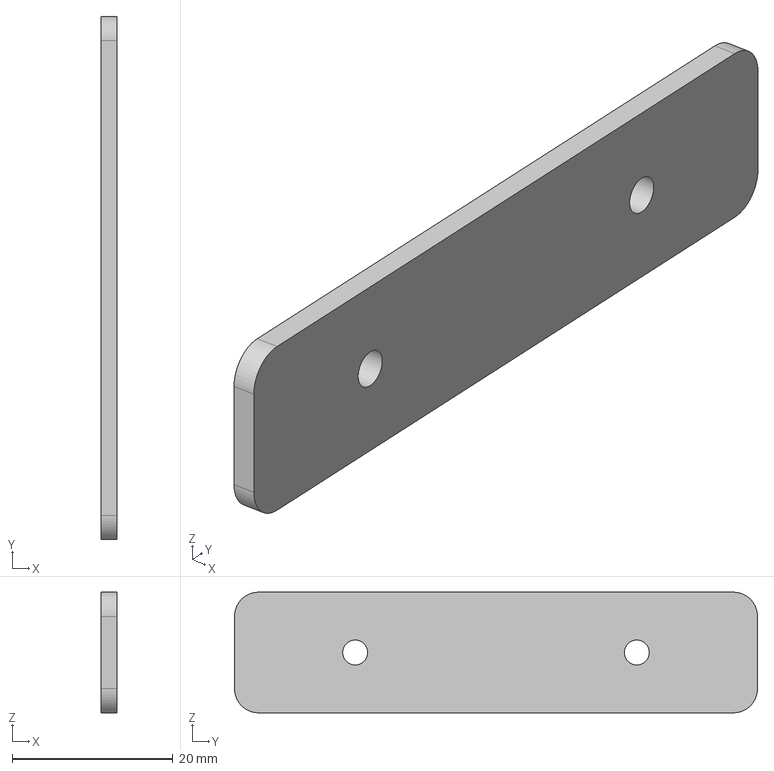
[picture p39: CAD file, 2022-10-08]
Mechanic parts/STEP/Steal for Gripper1.stp
2.00 x 65.0 x 15.0 mm
