marcostrullato/open_niryo_one/STL/0-Base/Base.STL

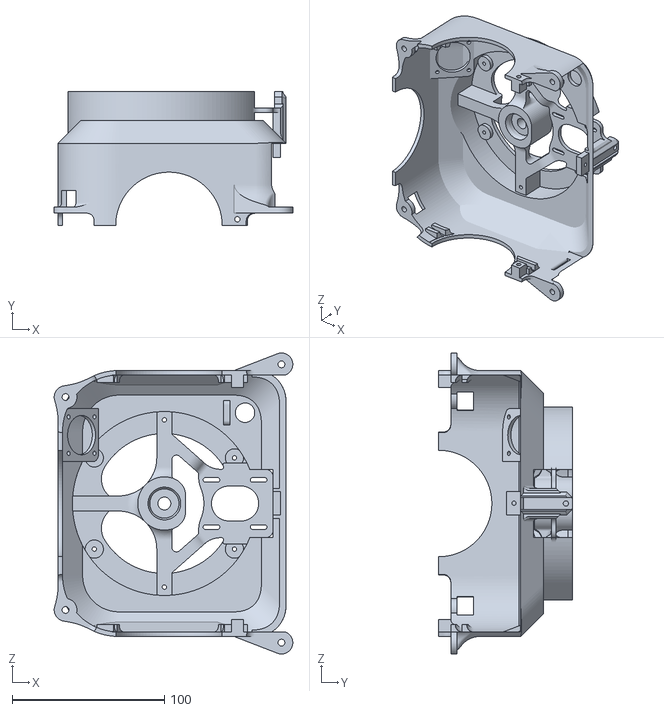
[picture p40: CAD file, 2019-08-29]
STL/0-Base/Base.STL
157.0 x 88.0 x 198.0
