marcostrullato/open_niryo_one/STL/7-Tools/Gripper1/G1_Rod.STL

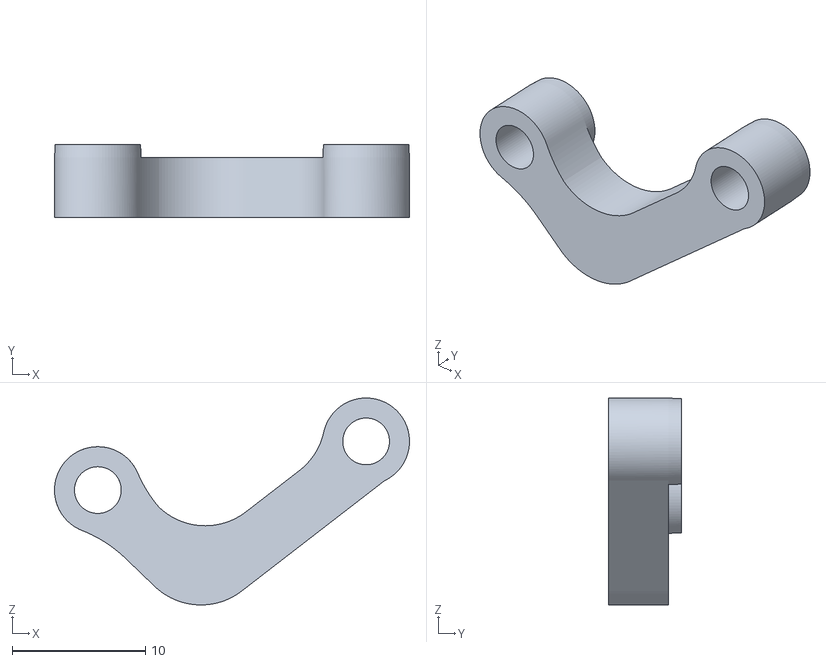
[picture p41: CAD file, 2019-08-29]
STL/7-Tools/Gripper1/G1_Rod.STL
26.6 x 5.50 x 15.5
