marcostrullato/open_niryo_one/STL/7-Tools/Gripper2/G2_Clamp.STL

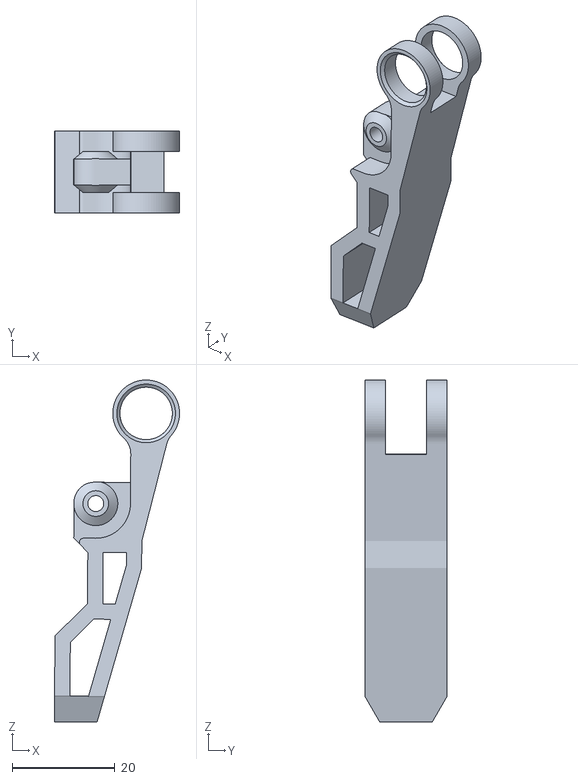
[picture p42: CAD file, 2019-08-29]
STL/7-Tools/Gripper2/G2_Clamp.STL
24.3 x 16.0 x 66.5
