marcostrullato/open_niryo_one/STL/7-Tools/Gripper3/G3_Link1.STL

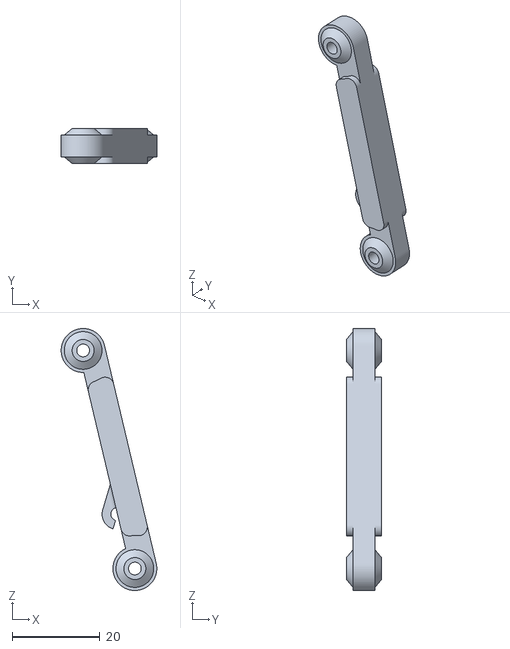
[picture p43: CAD file, 2019-08-29]
STL/7-Tools/Gripper3/G3_Link1.STL
21.8 x 8.00 x 59.6
