marcostrullato/open_niryo_one/STL/8-Other/Foot.STL

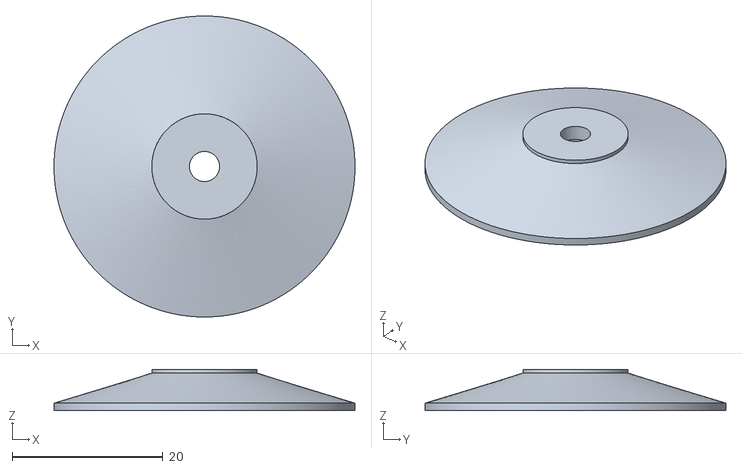
[picture p44: CAD file, 2019-08-29]
STL/8-Other/Foot.STL
40.0 x 40.0 x 5.50
