marcostrullato/open_niryo_one/Mechanic parts/STEP/Coupling Shaft Blue Motor.stp

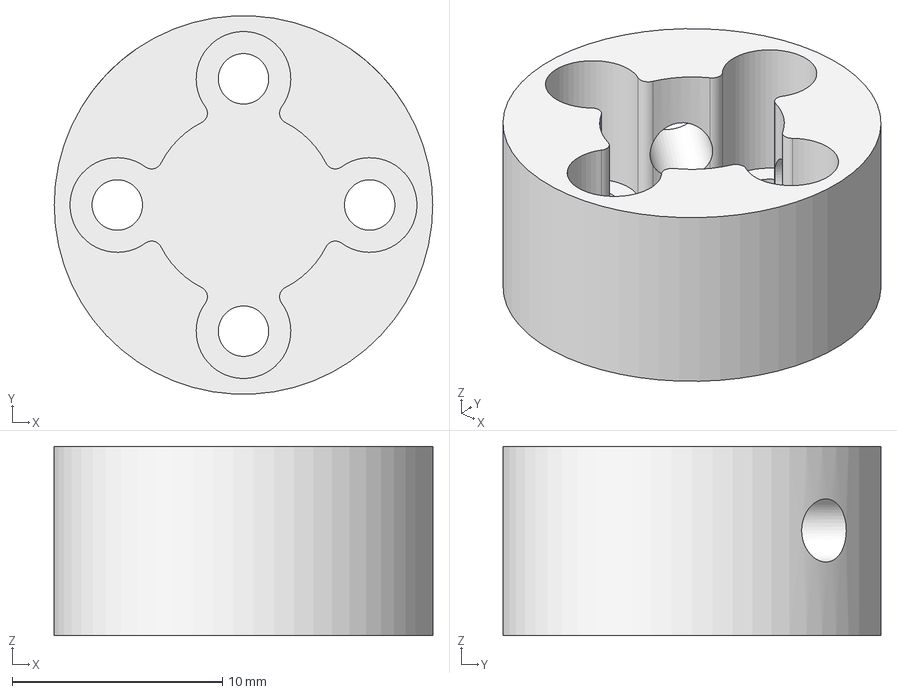
[picture p45: CAD file, 2022-10-08]
Mechanic parts/STEP/Coupling Shaft Blue Motor.stp
18.0 x 18.0 x 9.00 mm
