marcostrullato/open_niryo_one/STL/7-Tools/Gripper2/G2_Rod.STL

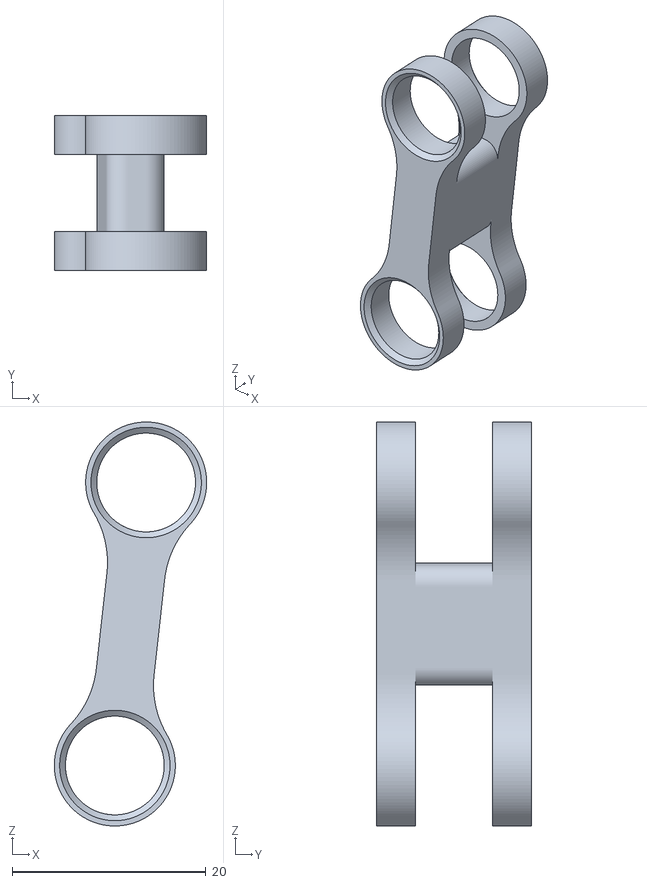
[picture p46: CAD file, 2019-08-29]
STL/7-Tools/Gripper2/G2_Rod.STL
15.7 x 16.0 x 41.7
