marcostrullato/open_niryo_one/STL/7-Tools/Gripper3/G3_GearLeft.STL

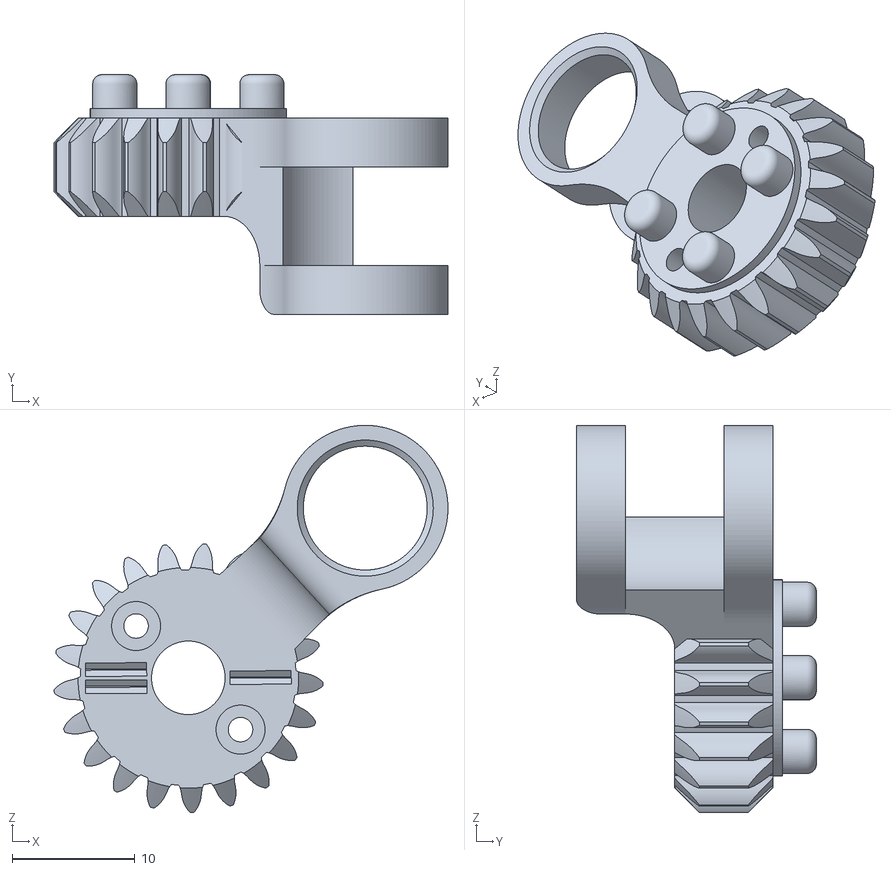
[picture p47: CAD file, 2019-08-29]
STL/7-Tools/Gripper3/G3_GearLeft.STL
32.1 x 19.6 x 31.6
