marcostrullato/open_niryo_one/Mechanic parts/STEP/Coupling Shaft Red Motor.stp

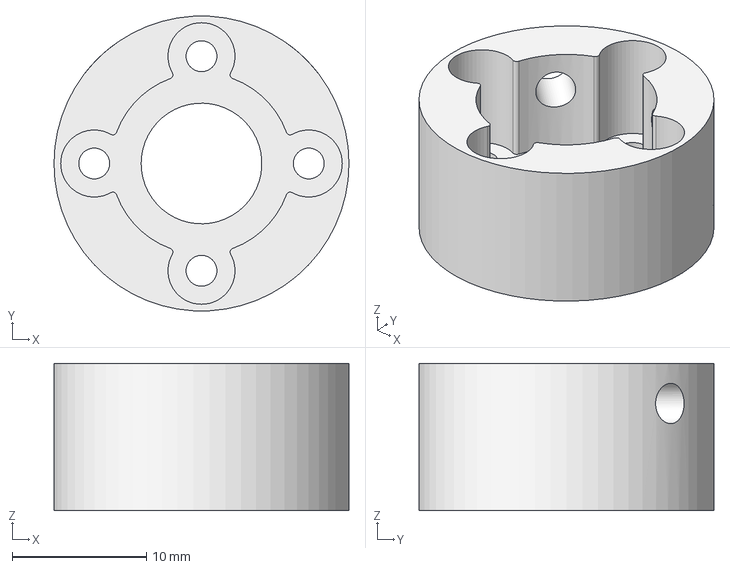
[picture p48: CAD file, 2022-10-08]
Mechanic parts/STEP/Coupling Shaft Red Motor.stp
22.0 x 22.0 x 11.0 mm
