marcostrullato/open_niryo_one/STL/7-Tools/Gripper2/G2_GearLeft.STL

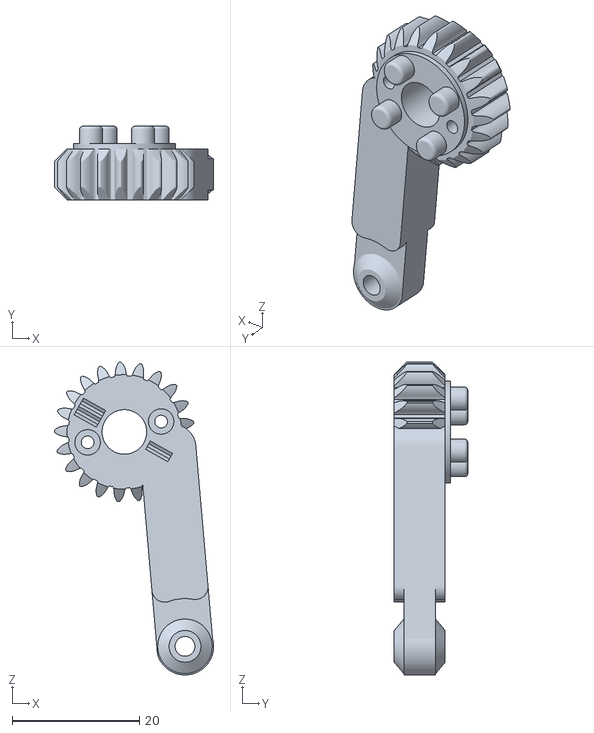
[picture p49: CAD file, 2019-08-29]
STL/7-Tools/Gripper2/G2_GearLeft.STL
25.0 x 11.5 x 49.2
