marcostrullato/open_niryo_one/STL/7-Tools/Gripper3/G3_GearRight.STL

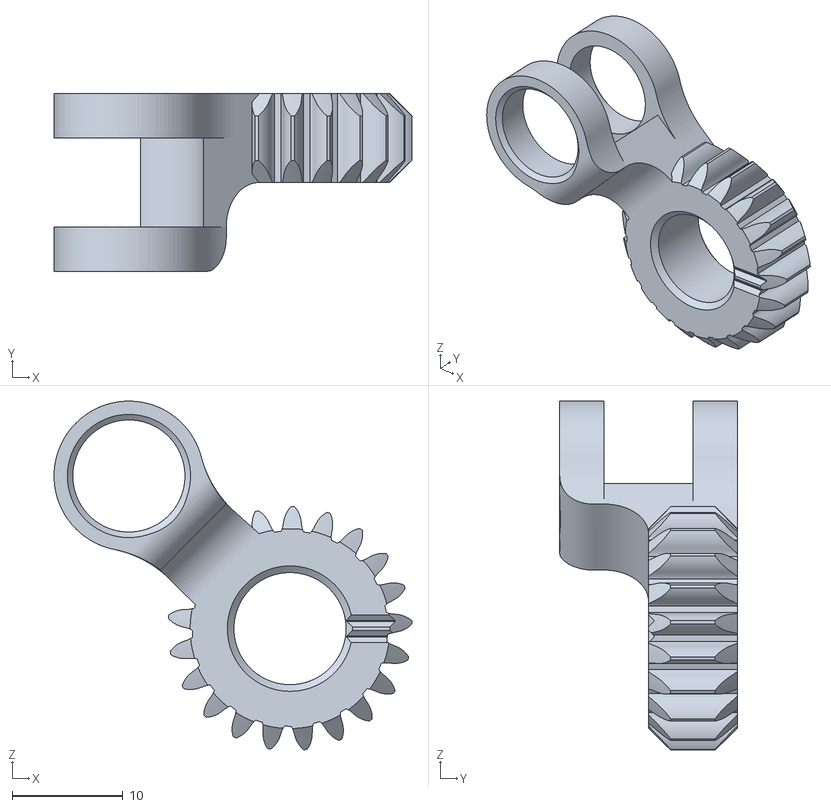
[picture p50: CAD file, 2019-08-29]
STL/7-Tools/Gripper3/G3_GearRight.STL
32.3 x 16.0 x 31.4
