marcostrullato/open_niryo_one/Mechanic parts/STEP/Aluminium Tube.stp

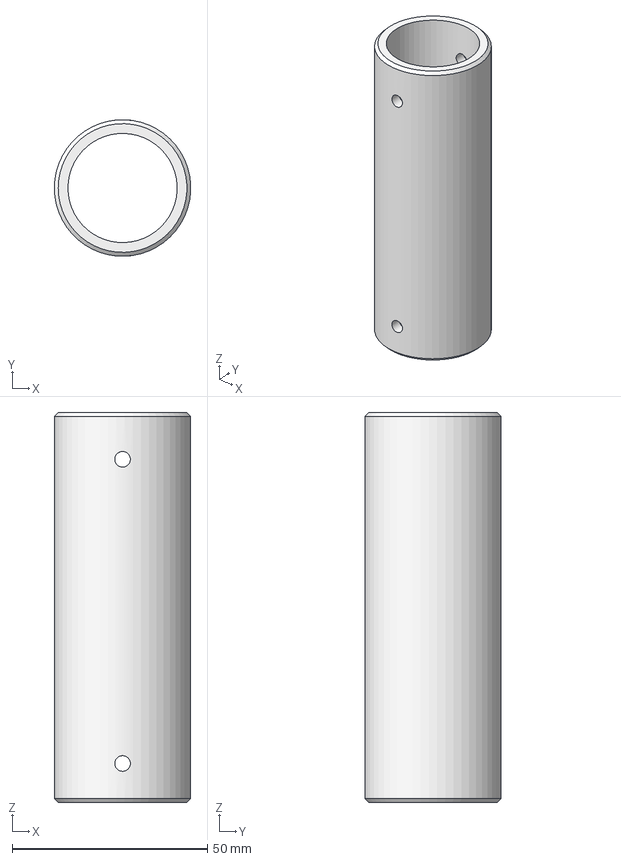
[picture p51: CAD file, 2022-10-08]
Mechanic parts/STEP/Aluminium Tube.stp
35.0 x 35.0 x 100.0 mm
