marcostrullato/open_niryo_one/STL/7-Tools/Gripper3/G3_Link2.STL

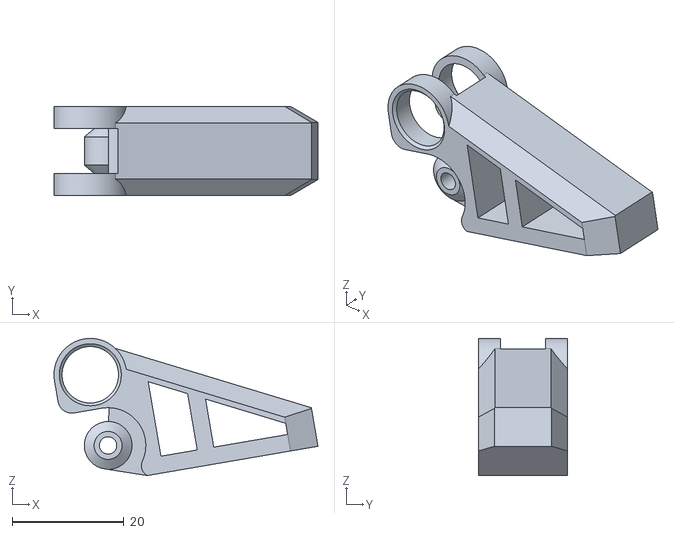
[picture p52: CAD file, 2019-08-29]
STL/7-Tools/Gripper3/G3_Link2.STL
47.2 x 16.0 x 24.5
