marcostrullato/open_niryo_one/Mechanic parts/STEP/Stepper fan cover.stp

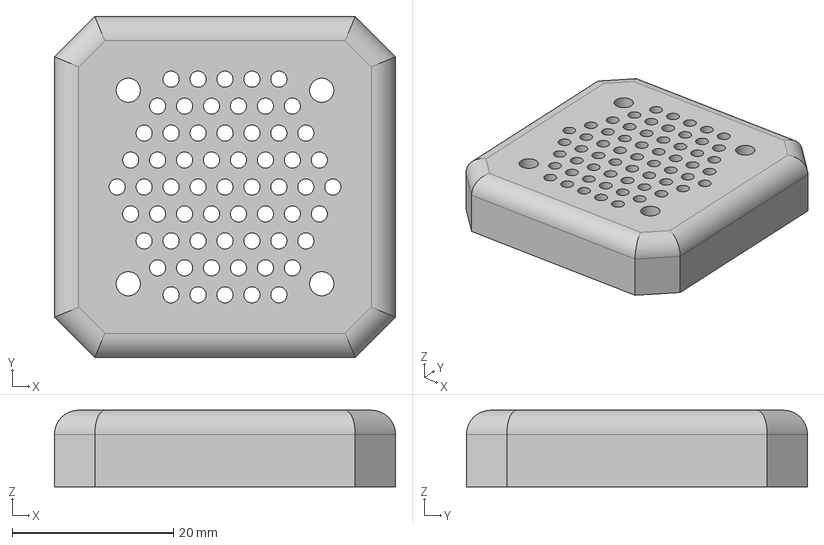
[picture p53: CAD file, 2022-10-08]
Mechanic parts/STEP/Stepper fan cover.stp
42.3 x 42.3 x 9.50 mm
