marcostrullato/open_niryo_one/Mechanic parts/STEP/Stepper cover.stp

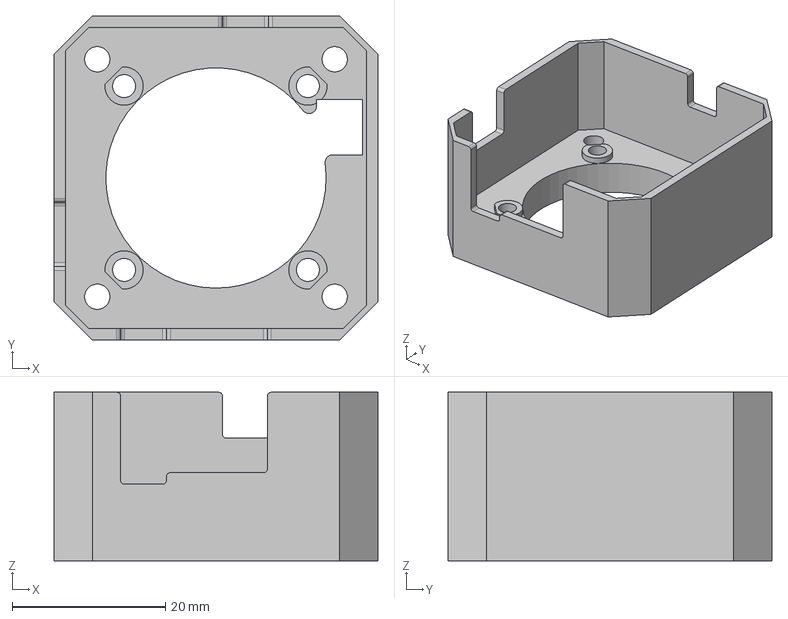
[picture p54: CAD file, 2022-10-08]
Mechanic parts/STEP/Stepper cover.stp
42.3 x 42.3 x 22.0 mm
