marcostrullato/open_niryo_one/(list of files, cad)

Other CAD files:
STL/7-Tools/Gripper1/G1_ClampLeft.STL
Electronics/Engines/Wrist/XL-320.dwg
Electronics/Engines/Wrist/XL-320.igs
Mechanic parts/STL/Coupling Shaft Blue Motor.stl
Mechanic parts/STL/Coupling Shaft Green Motor.stl
Mechanic parts/STL/Coupling Shaft Red Motor.stl
Mechanic parts/STL/Stepper cover.stl
