marcostrullato/open_niryo_one/(threads)

Thread 1 (2019-07-23):

Develop the new stepper shield

marcostrullato, 2019-07-23:
As a Open Niryo One user I would like to be able to control stepper motors with a stepper shield, so that I can control the arm movements.

MikeMihailov, 2019-07-26:
There is some ledPin in config.h. But I have never seen any uses of it. Will we place a some led on PCB?

marcostrullato, 2019-07-26:
Hi Mike, I would say so, just to stay aligned to the main project and to
avoid changes on the code.

Il giorno ven 26 lug 2019 alle ore 13:16 Mike Mihailov <
notifications@github.com> ha scritto:

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

--
Marco Strullato
cell: +393288462393
skype: marco.strullato

Thread 2 (2019-07-23):

Develop the new Raspberry PI shield

marcostrullato, 2019-07-23:
As a Open Niryo One user I would like to be able to control all stepper motors with a raspberry pi shield, so that I can control the arm movements.

Thread 3 (2019-07-26):

Bill of Materials check

MikeMihailov, 2019-07-26:
You need to check BOM_niryoStepperController. Is all components ok to buy?

marcostrullato, 2019-08-26:
Hi Mike, I merged the BOM into one. Please check it out, it's under the folder BOM. Thanks!

marcostrullato, 2019-08-26:
Closed

Closed 2019-08-26.

Thread 8 (2019-09-16):

Shoulder - Add spring details

marcostrullato, 2019-09-16:
Spring details are completely missing. Please add them.

marcostrullato, 2019-12-04:
spring details added

marcostrullato, 2019-12-04:
spring details added

Closed 2019-12-04.

Thread 9 (2019-09-16):

Shafts

marcostrullato, 2019-09-16:
Coupling shafts info are missing. Add them.

Thread 10 (2019-11-03):

Power mangment

MikeMihailov, 2019-11-03:
<h2>Introduction:</h2>

There are 3 servo motors in Niryo one: 2 [XL430 ](http://emanual.robotis.com/docs/en/dxl/x/xl430-w250/)and 1 [XL320](http://emanual.robotis.com/docs/en/dxl/x/xl320/) by DYNAMIXEL. XL430 needs 6.5V to 12V as source voltage (11.1V is recommended - it is the voltage of 3S LiPo battery). XL320 needs 6V to 8.4V as source voltage (7.4V is recommended - it is the voltage of 2S LiPo battery). And it is necessary to have the source of 5v power for Raspberry pi. The main input source of power is 12v.

Of course 11.1V and 7.4V aren’t very common voltage in schematechnic. There may be temptation to use 12V instead 11.1V. But it is the border voltage and it can cause servo damage. Niryo One declares 11.1V for XL430. [Team of ZHAW School of Engineering](https://blog.zhaw.ch/icclab/niryo-arm-motor-troubleshooting/) have got the information that it isn’t true.

<h2>Power calculation:</h2>

- XL430: 11.1V * 1.3A * 2 = 28.86W (30W) => 2.5A@12V
- XL320: 7.4V * 1.1A = 8.14W(9W) => 0.75A@12V
- Raspberry: 5V * 2.5A =12.5W(13W) => 1A@12V

Full current of 12V power supply = 4.25A (without steppers).

<h2>Voltage source selection:</h2>

In my opinion it is necessary to use step-down voltage regulators in order to have good efficiency. The scheme is more difficult than LDO, but the temperature of components will be lower. The most popular regulator with 3A output current is LM2596-ADJ (IMHO, of course). This component is in TO220-5 case. Besides, it is necessary to have big input capacitor and coil. 470uF x 50V capacitor is recommended (see [datasheet](http://www.ti.com/lit/ds/symlink/lm2596.pdf)). This type of capacitor is not popular in SMD case. 50V may be too much. In my opinion, Х2 reserve is enough (about 24V). I think we can use 3 LM2596 for all kinds of voltage. For 7.4v we can use some other component, but universalization is more important. </br>
The problem of this idea is size. I have made a sketch and the result is bad. I think to change from SMD to THT case of LM2596.

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
