marcostrullato/open_niryo_one/Electronics/Engines/Elbow/dc11_a01_xl430_ref.pdf

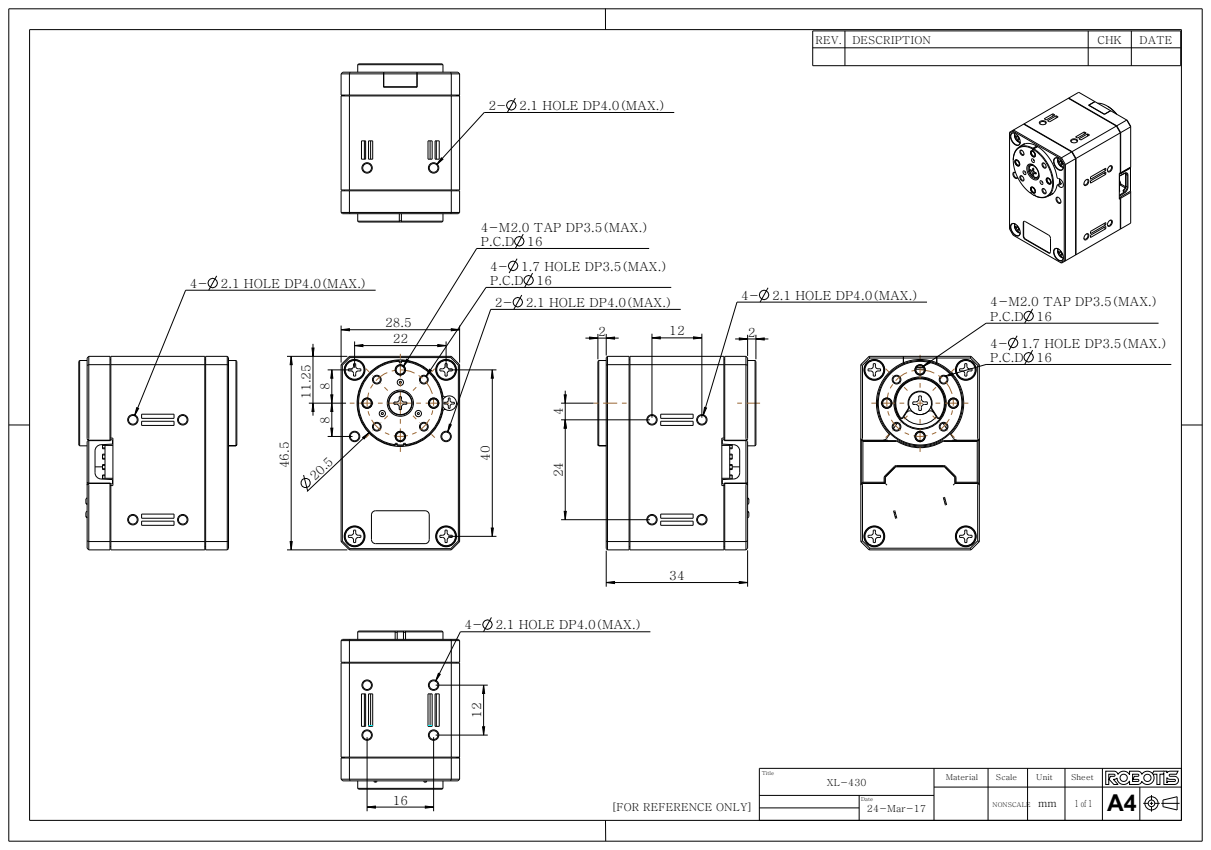
[picture p55: page 1]
Title; Scale; Date; Unit; Sheet; NONSCALE; Material; 2- 2.1 HOLE DP4.0(MAX.); 4- 2.1 HOLE DP4.0(MAX.); 1 of 1 24-Mar-17; REV.; DESCRIPTION; CHK; DATE; 4-M2.0 TAP DP3.5(MAX.) P.C.D 16; 4- 1.7 HOLE DP3.5(MAX.) P.C.D 16

[FOR REFERENCE ONLY]
