marcostrullato/open_niryo_one/Electronics/Engines/Wrist/XL-320.pdf

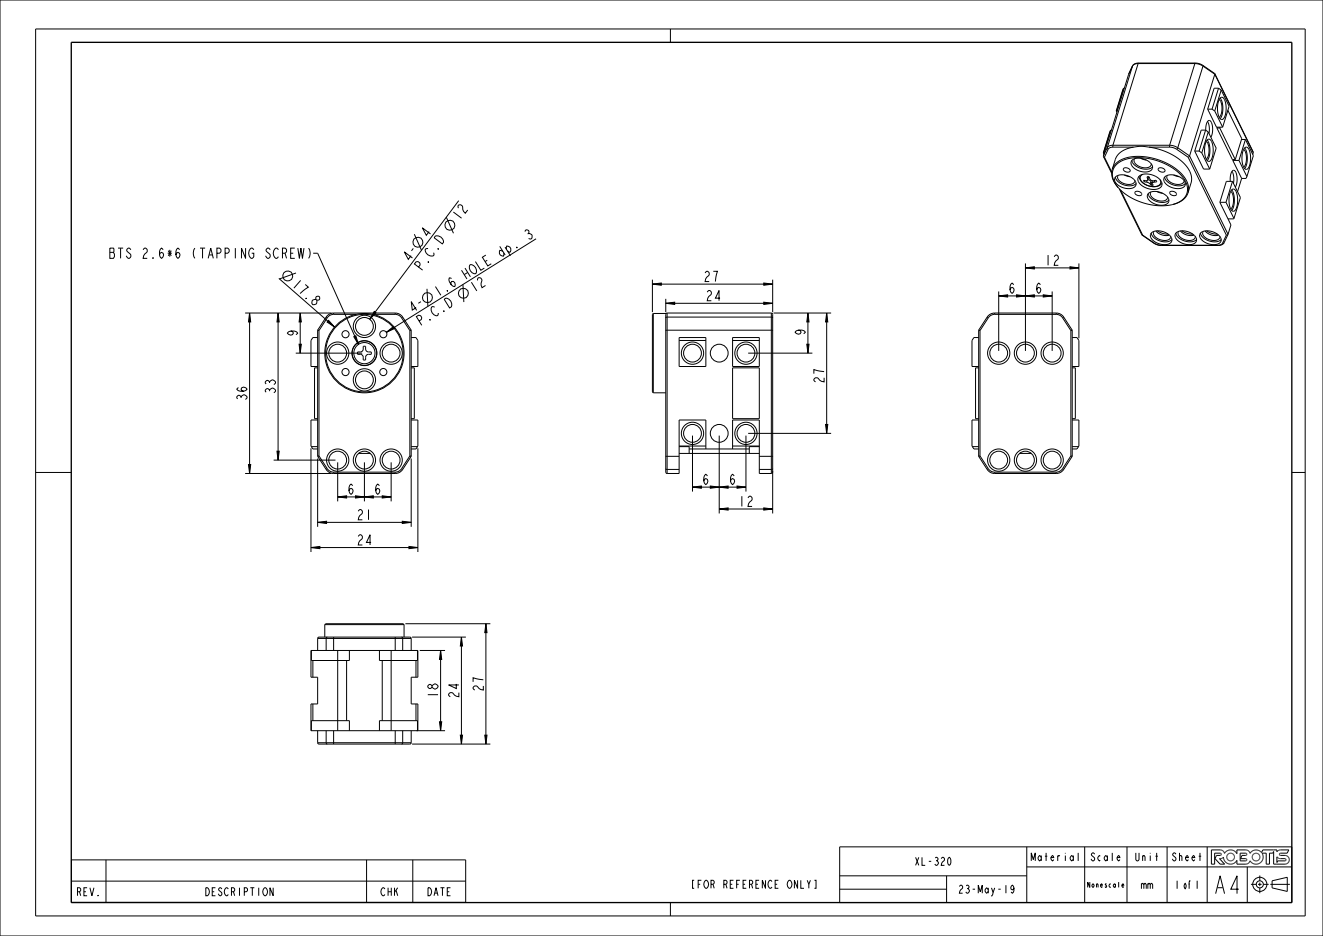
[picture p56: page 1]
4- 1.6 HOLE dp. 3; 23-May-19; Nonescale; Material; Scale; Unit; Sheet; REV.; DESCRIPTION; CHK; DATE

BTS 2.6*6 (TAPPING SCREW)

[FOR REFERENCE ONLY]
