marcostrullato/open_niryo_one/Electronics/Stepper/OUT/R2/Stepper PCB shematic.pdf

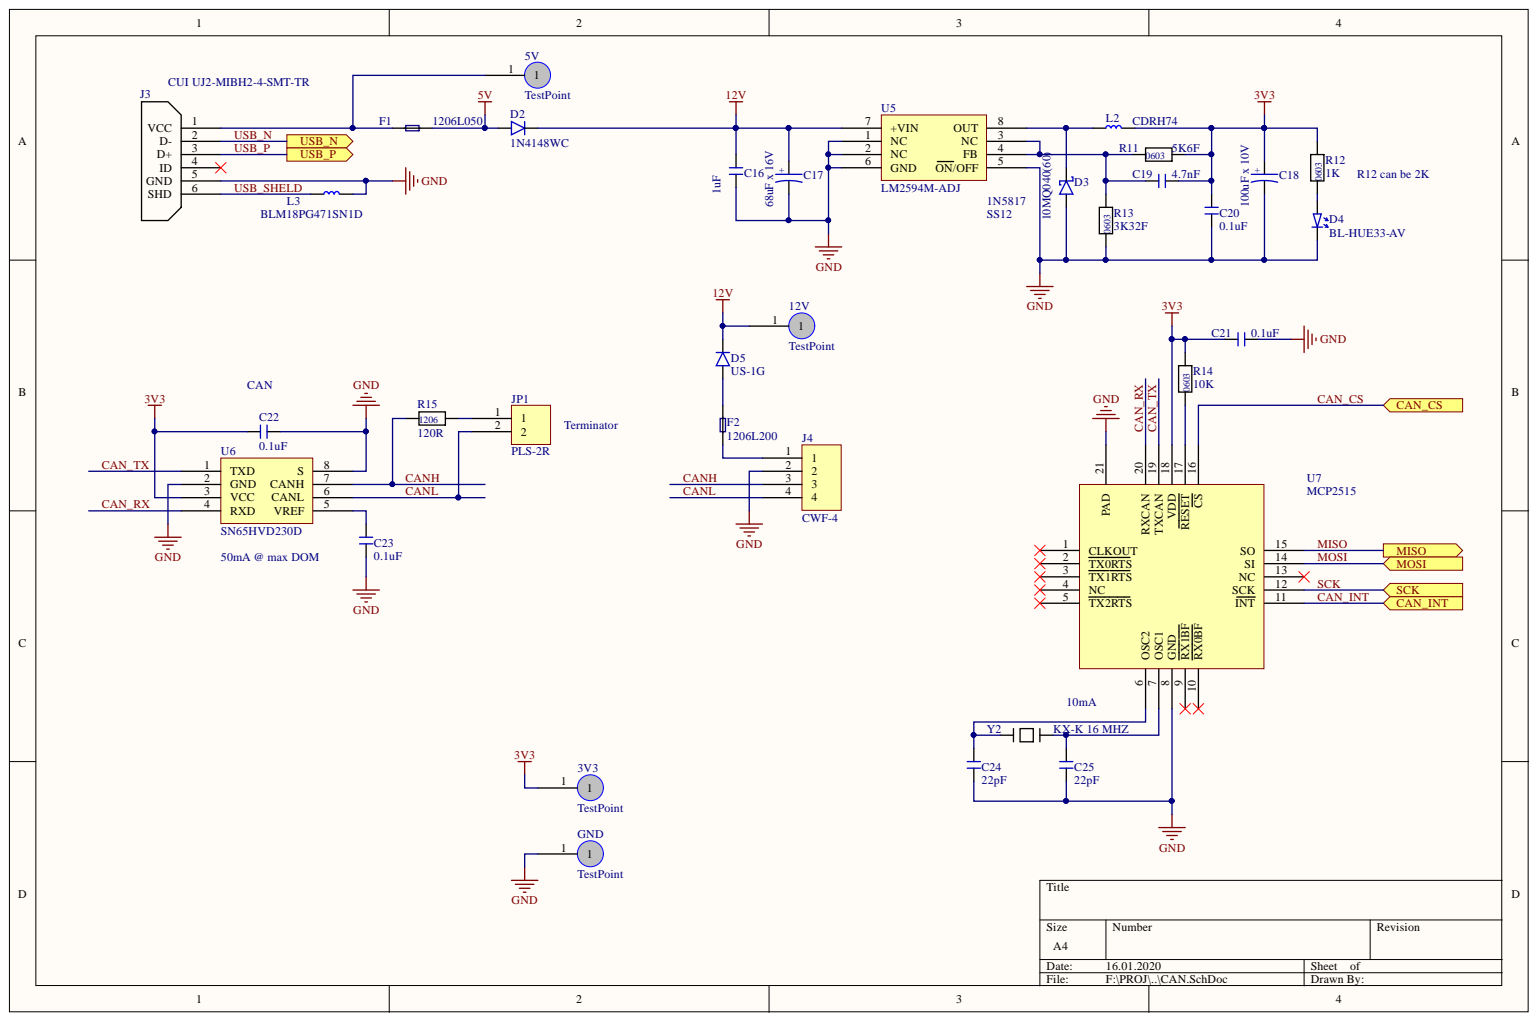
[picture p61: page 1]

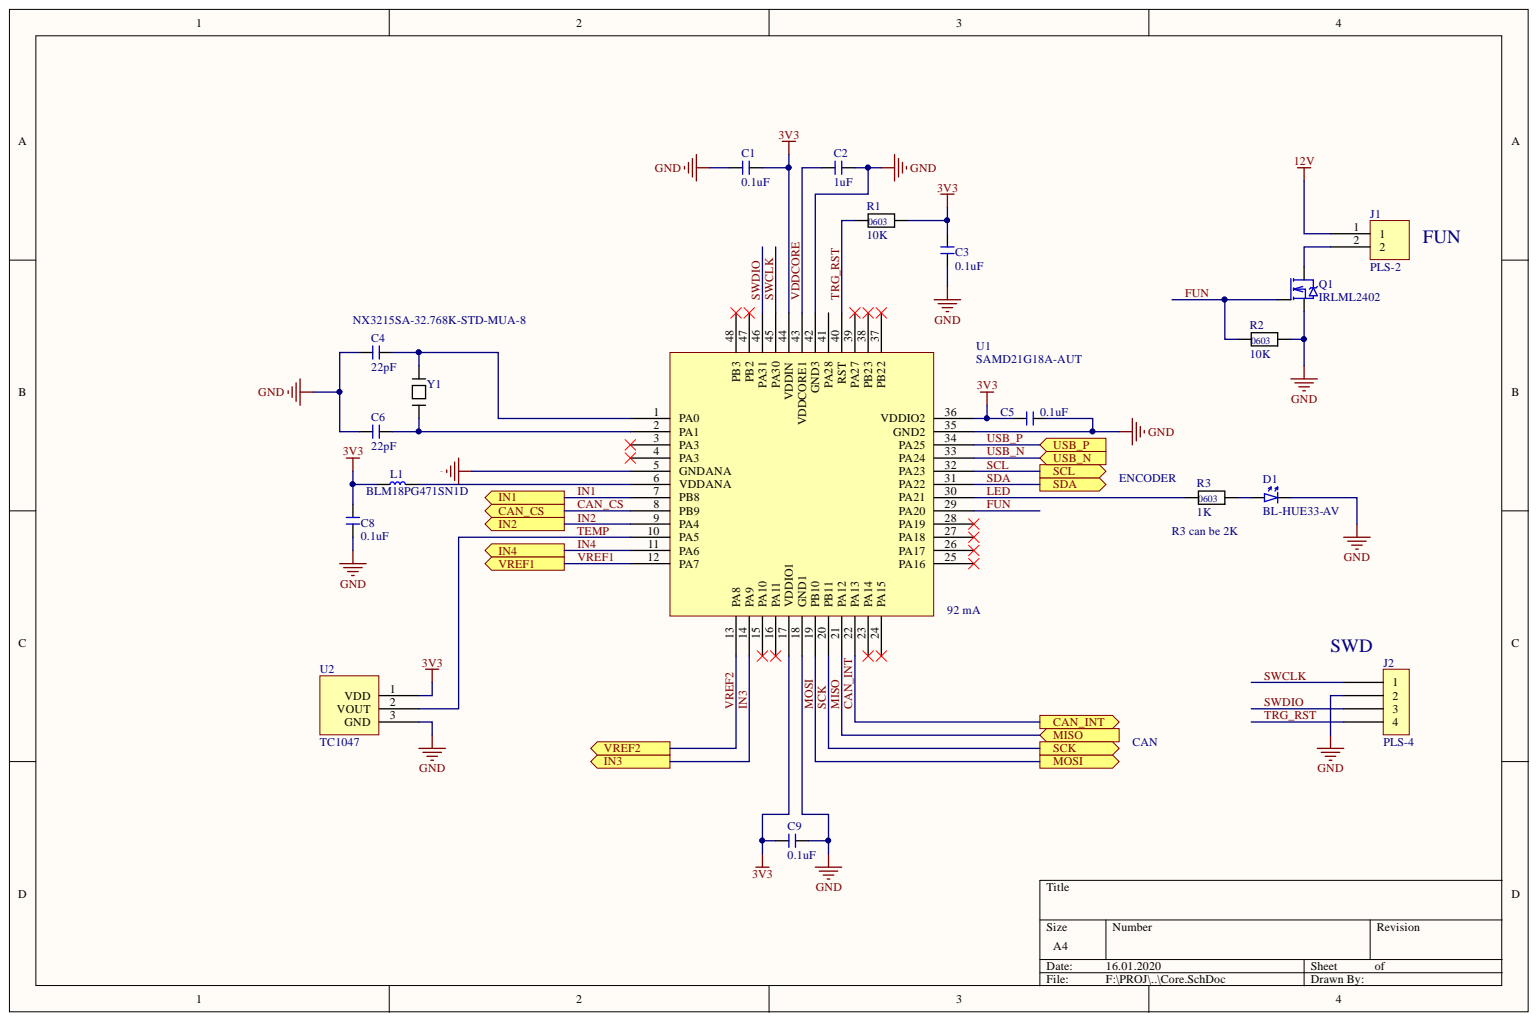
[picture p62: page 2]

IN4 IN4 VREF1 VREF1 3V3 | PA6 11 PA7 12

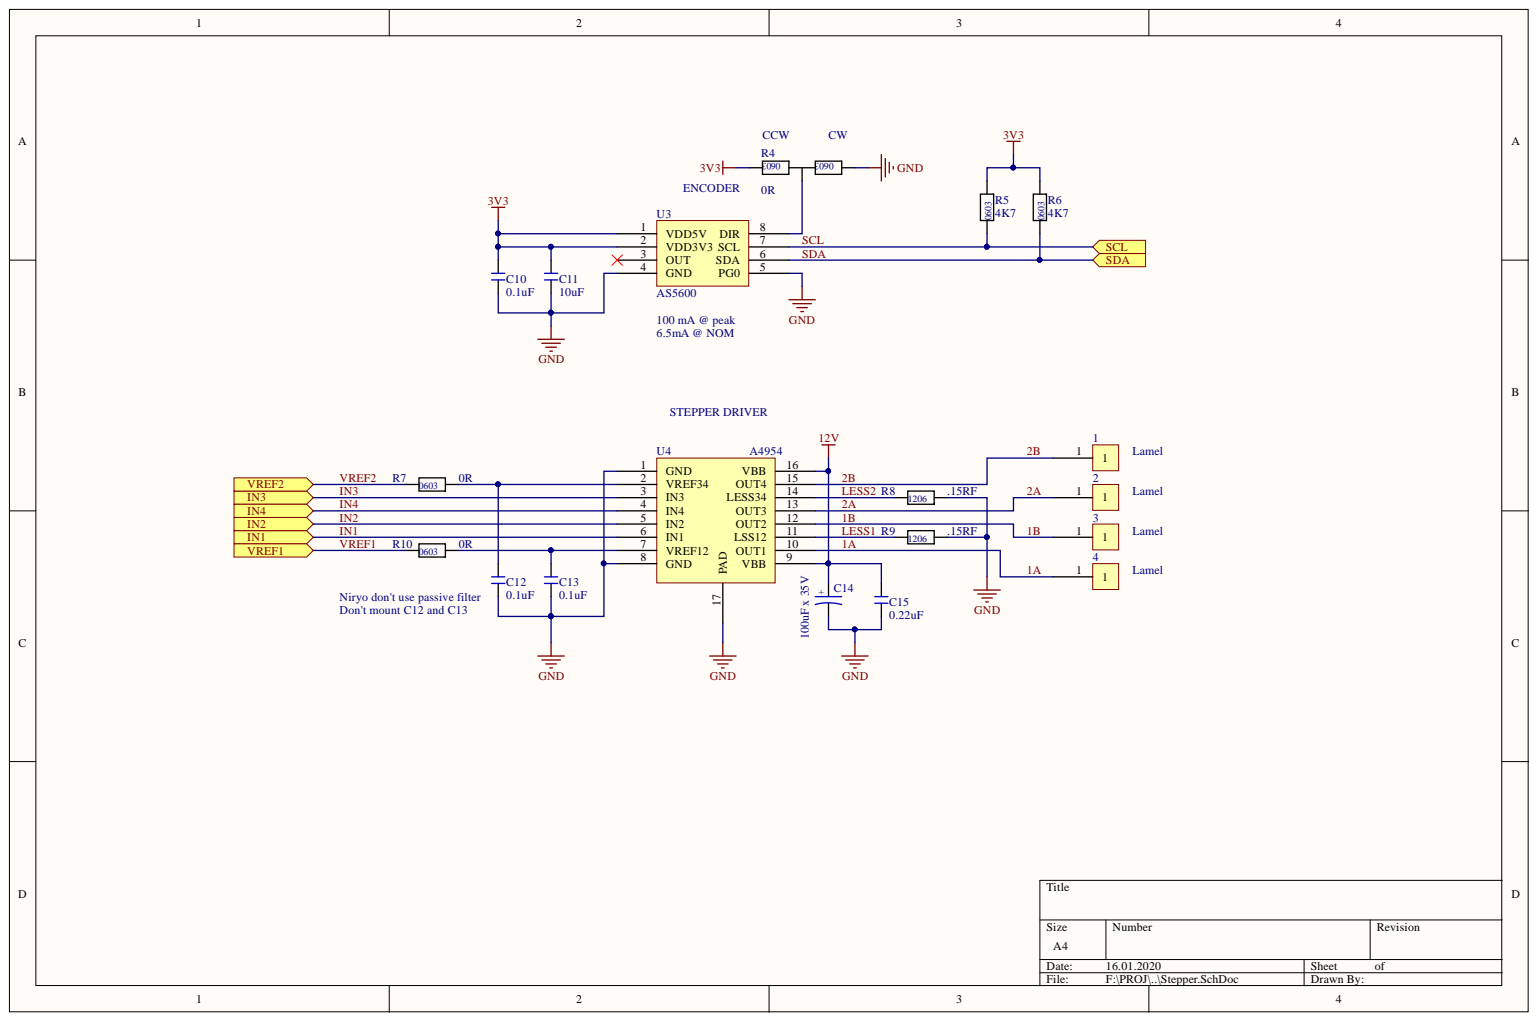
[picture p63: page 3]

VDD3V3 2 | | SCL
OUT 3 | | SDA

VREF34 2

Niryo don't use passive filter
Don't mount C12 and C13
