marcostrullato/open_niryo_one/Mechanic parts/BLUEPRINT/Steal for Gripper1.pdf

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

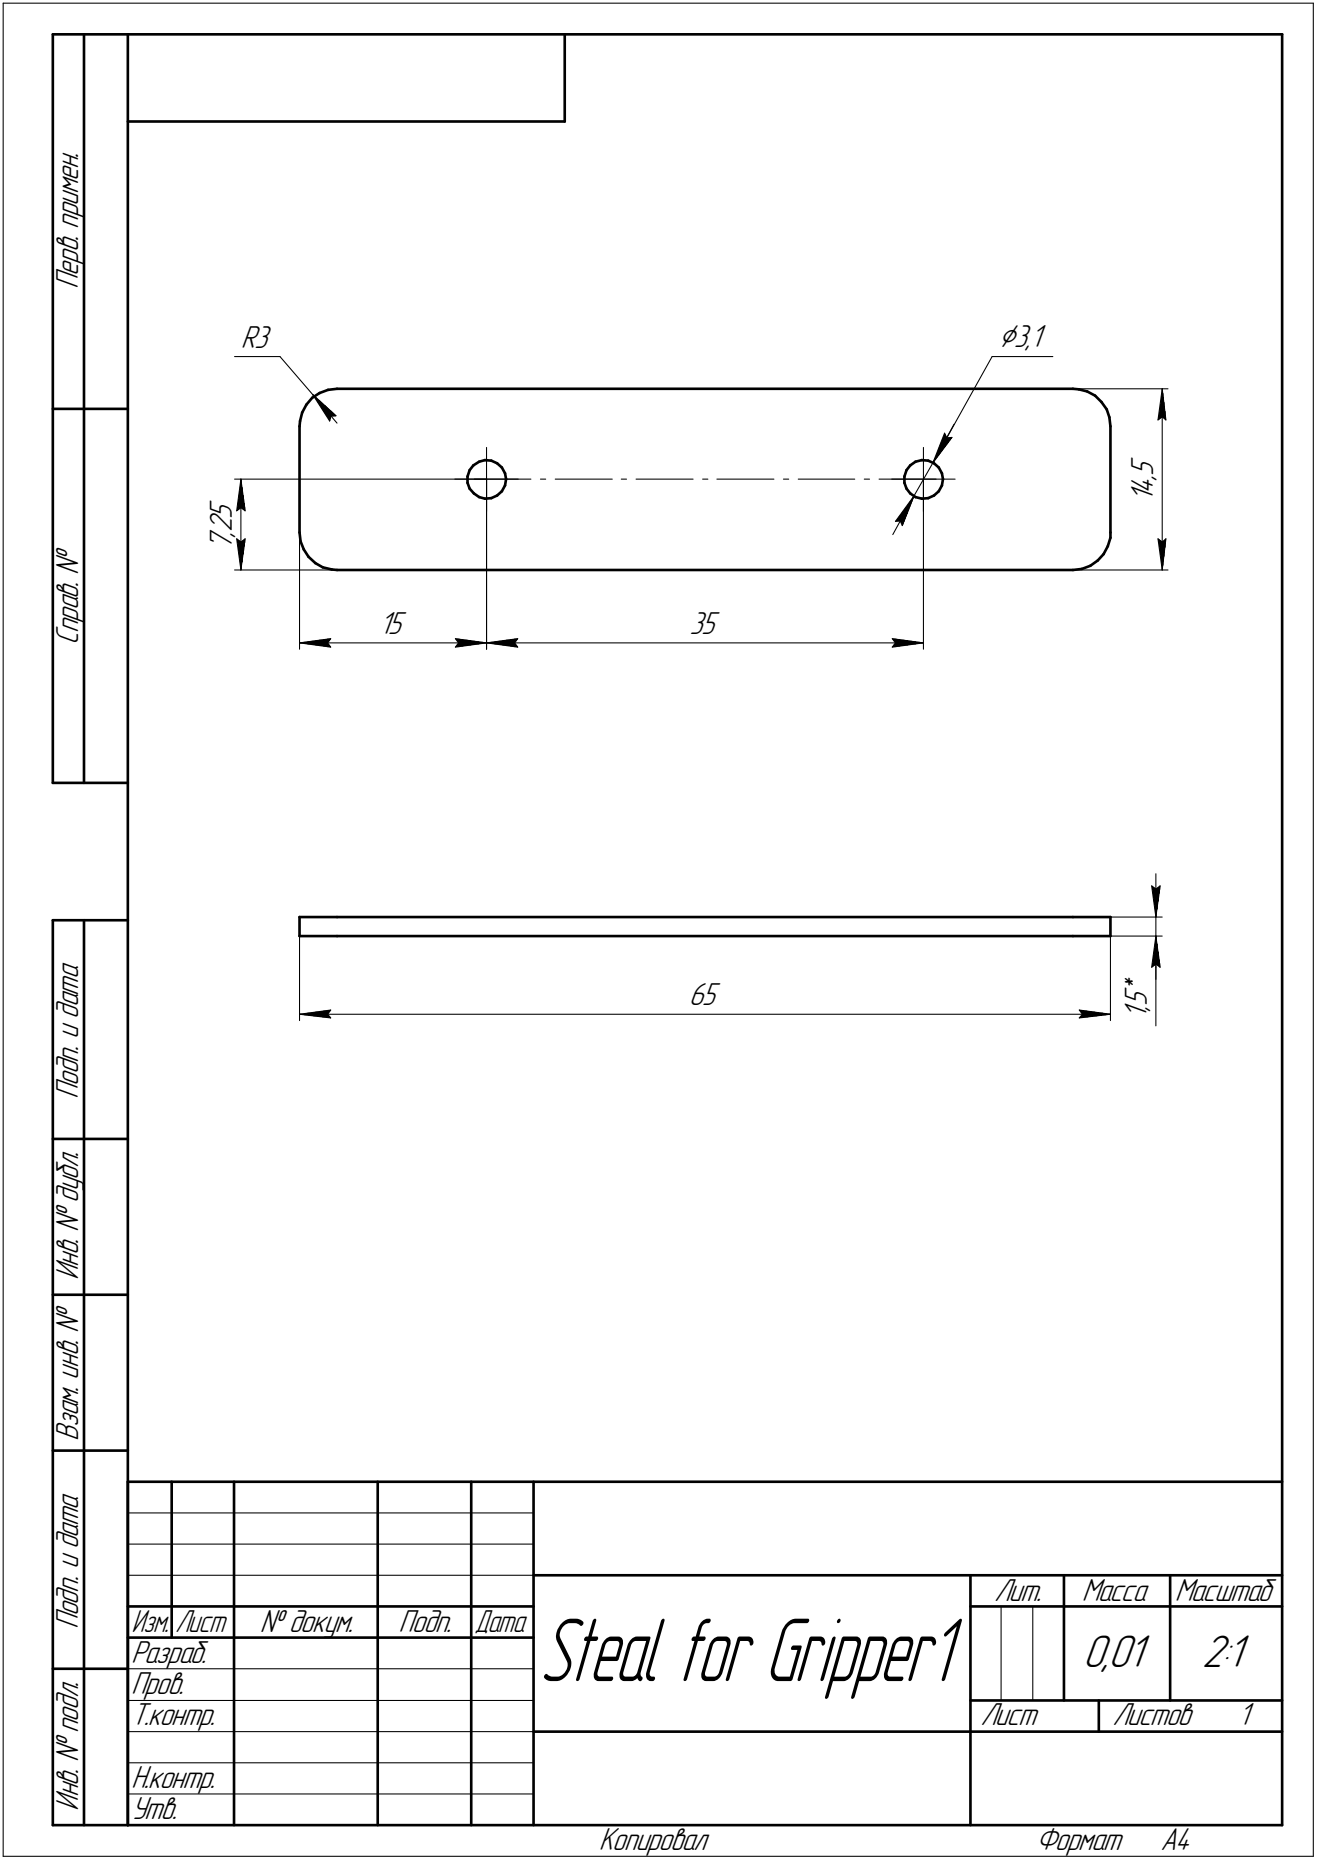
[picture p66: page 1]
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
