marcostrullato/open_niryo_one/Electronics/Stepper/PCB/niryoStepperController.pdf

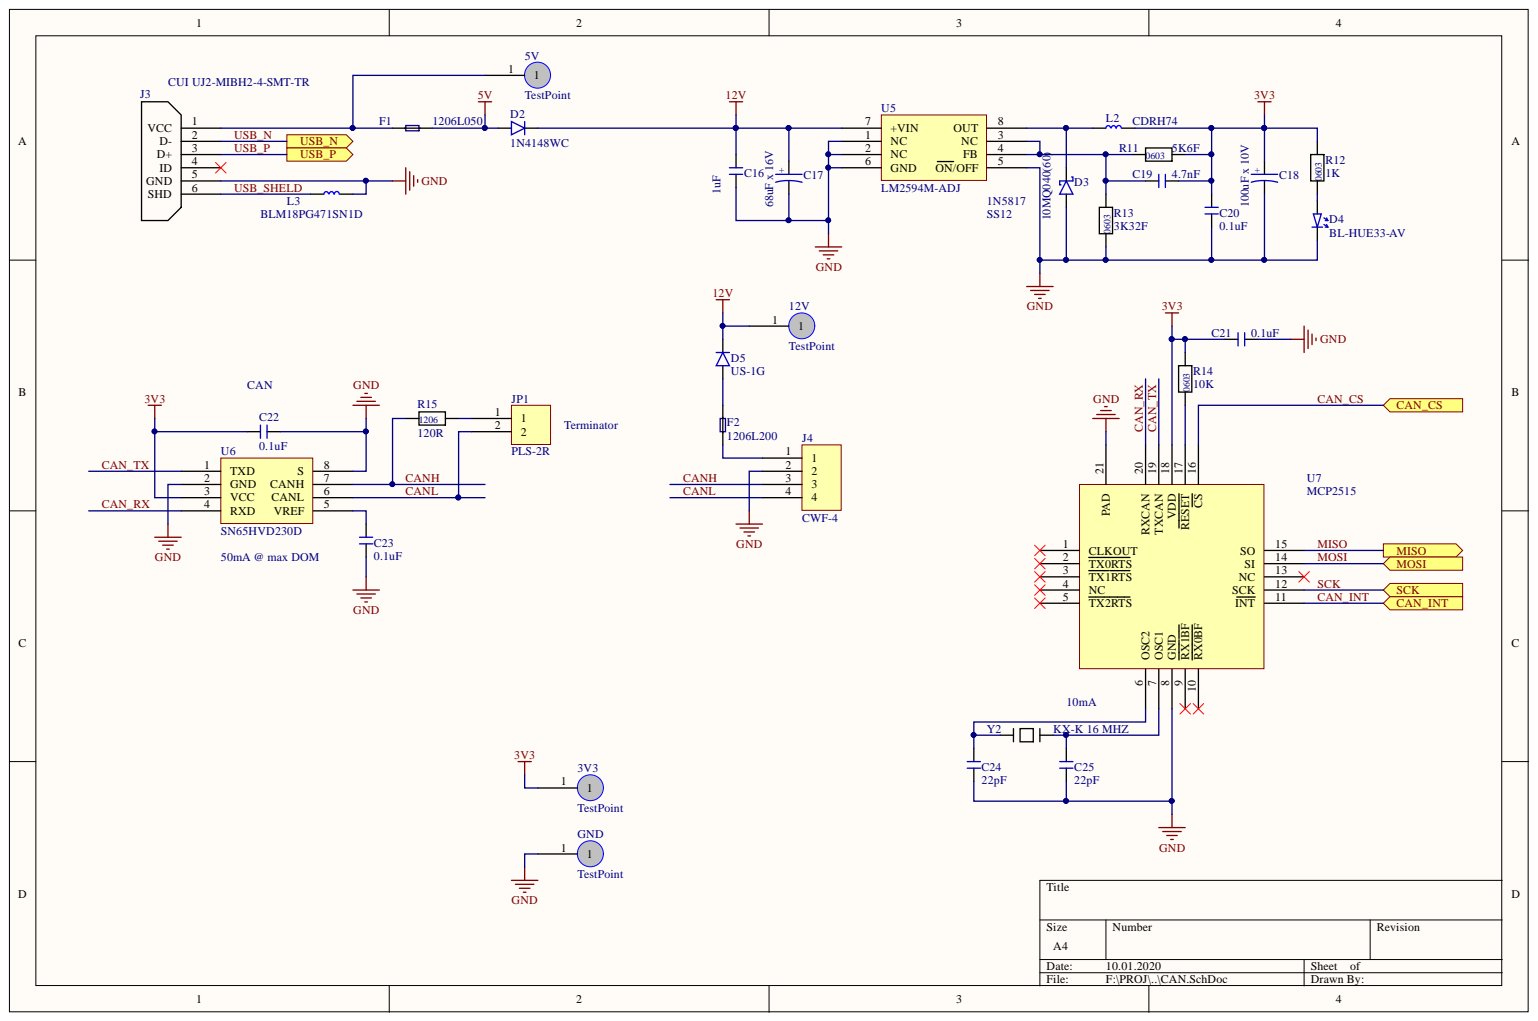
[picture p67: page 1]

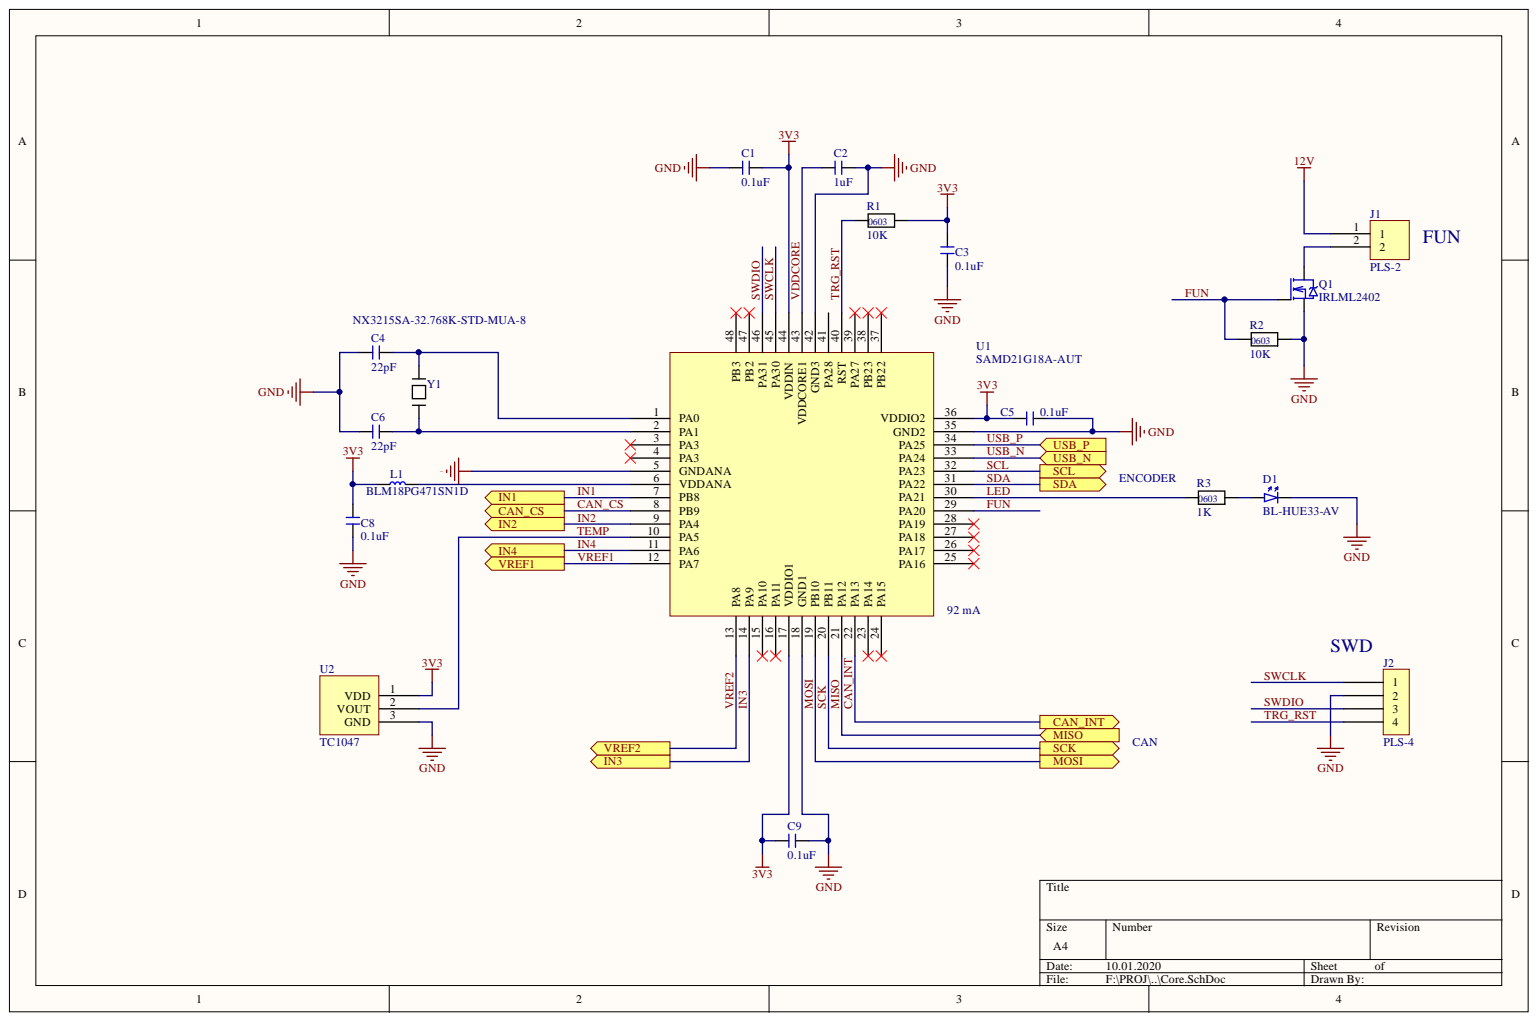
[picture p68: page 2]

IN4 IN4 VREF1 VREF1 3V3 | PA6 11 PA7 12

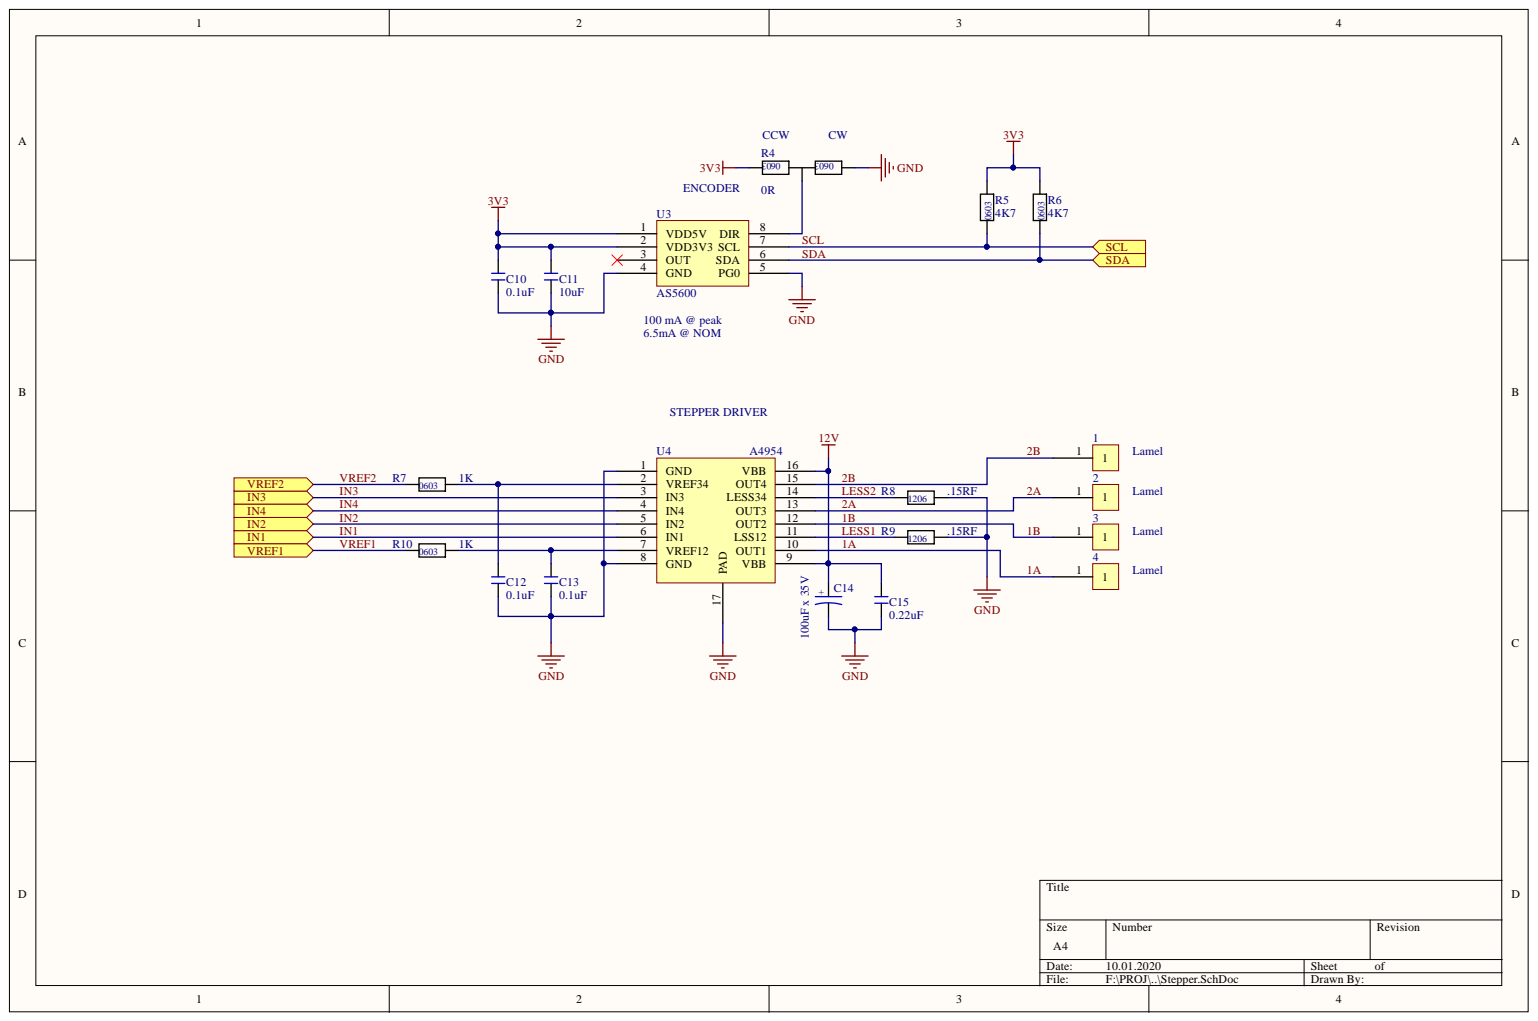
[picture p69: page 3]

VDD3V3 2 | | SCL
OUT 3 | | SDA

VREF34 2
