marcostrullato/open_niryo_one/Electronics/Wiring/DRAW/Wiring harness.pdf

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

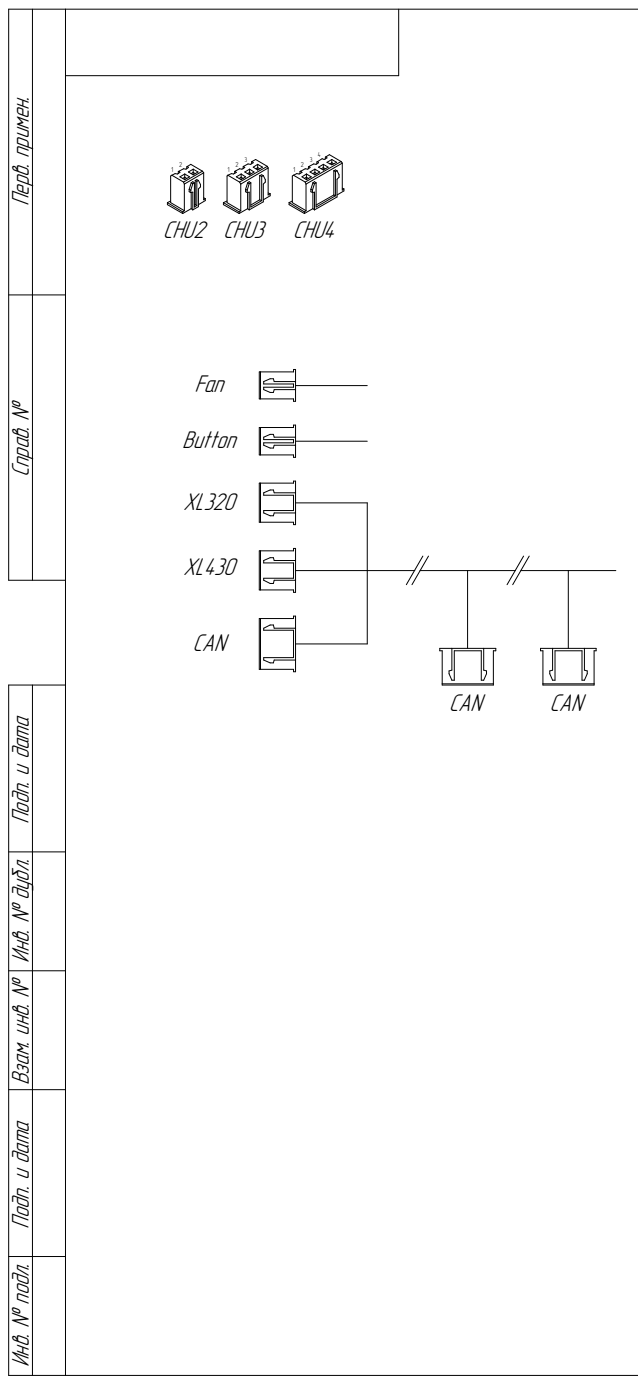
[picture p70: page 1]
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
