marcostrullato/open_niryo_one/Electronics/Panel/OUT/R1/schematic.pdf

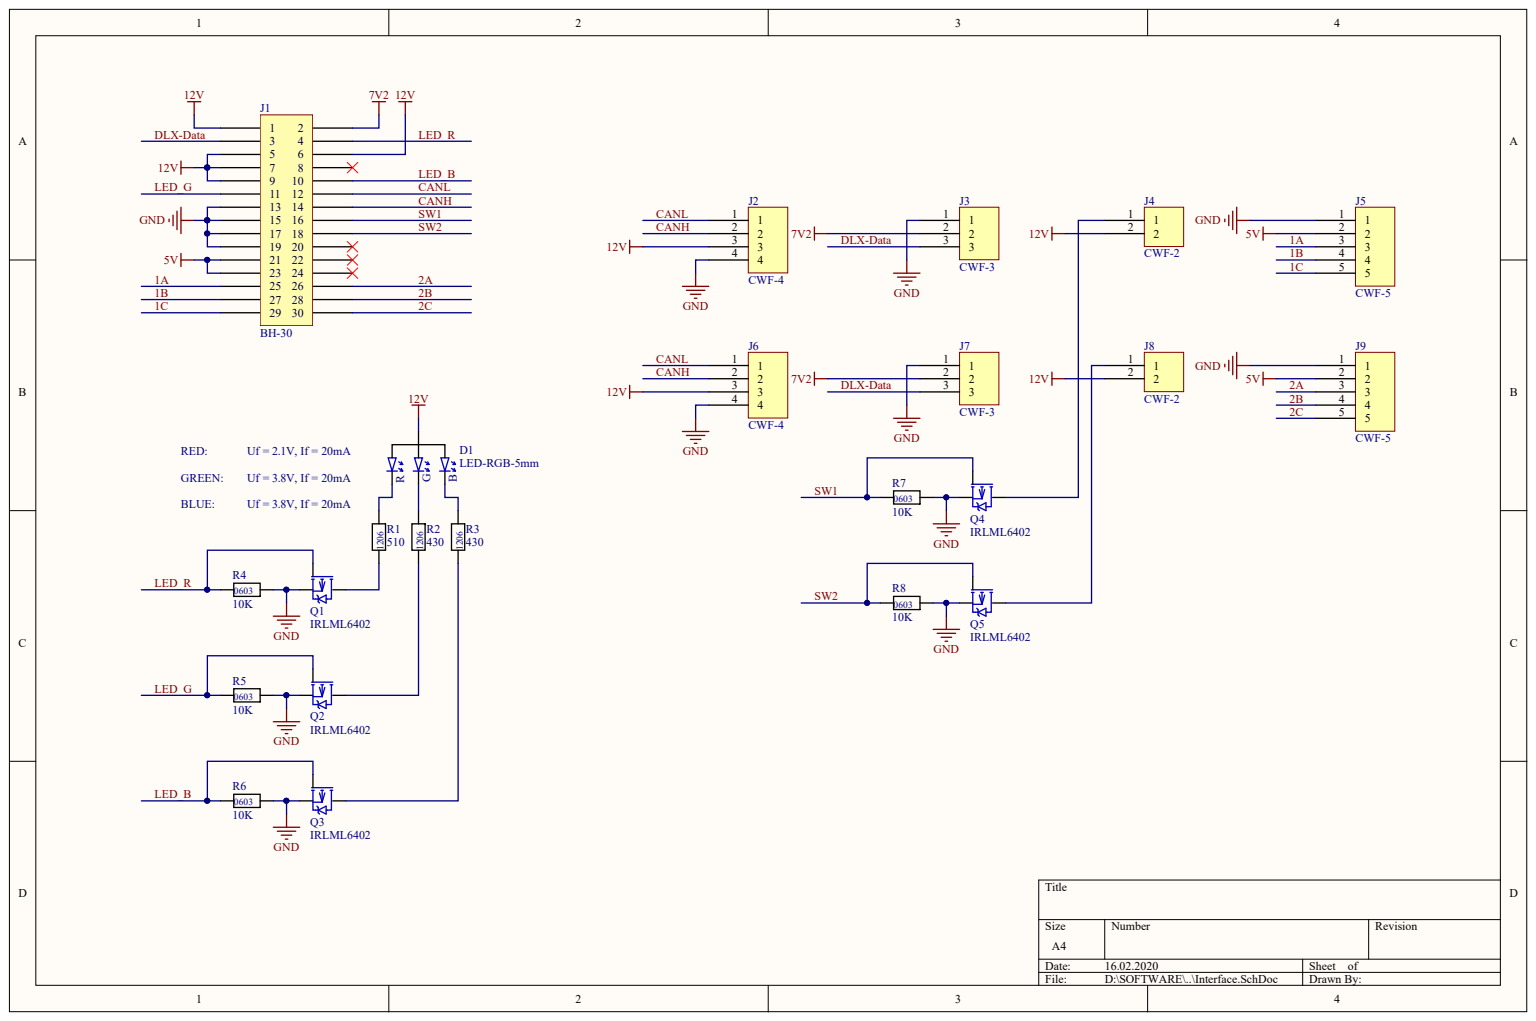
[picture p71: page 1]
