marcostrullato/open_niryo_one/Electronics/RPi_adapter/OUT/R1/schematic.pdf

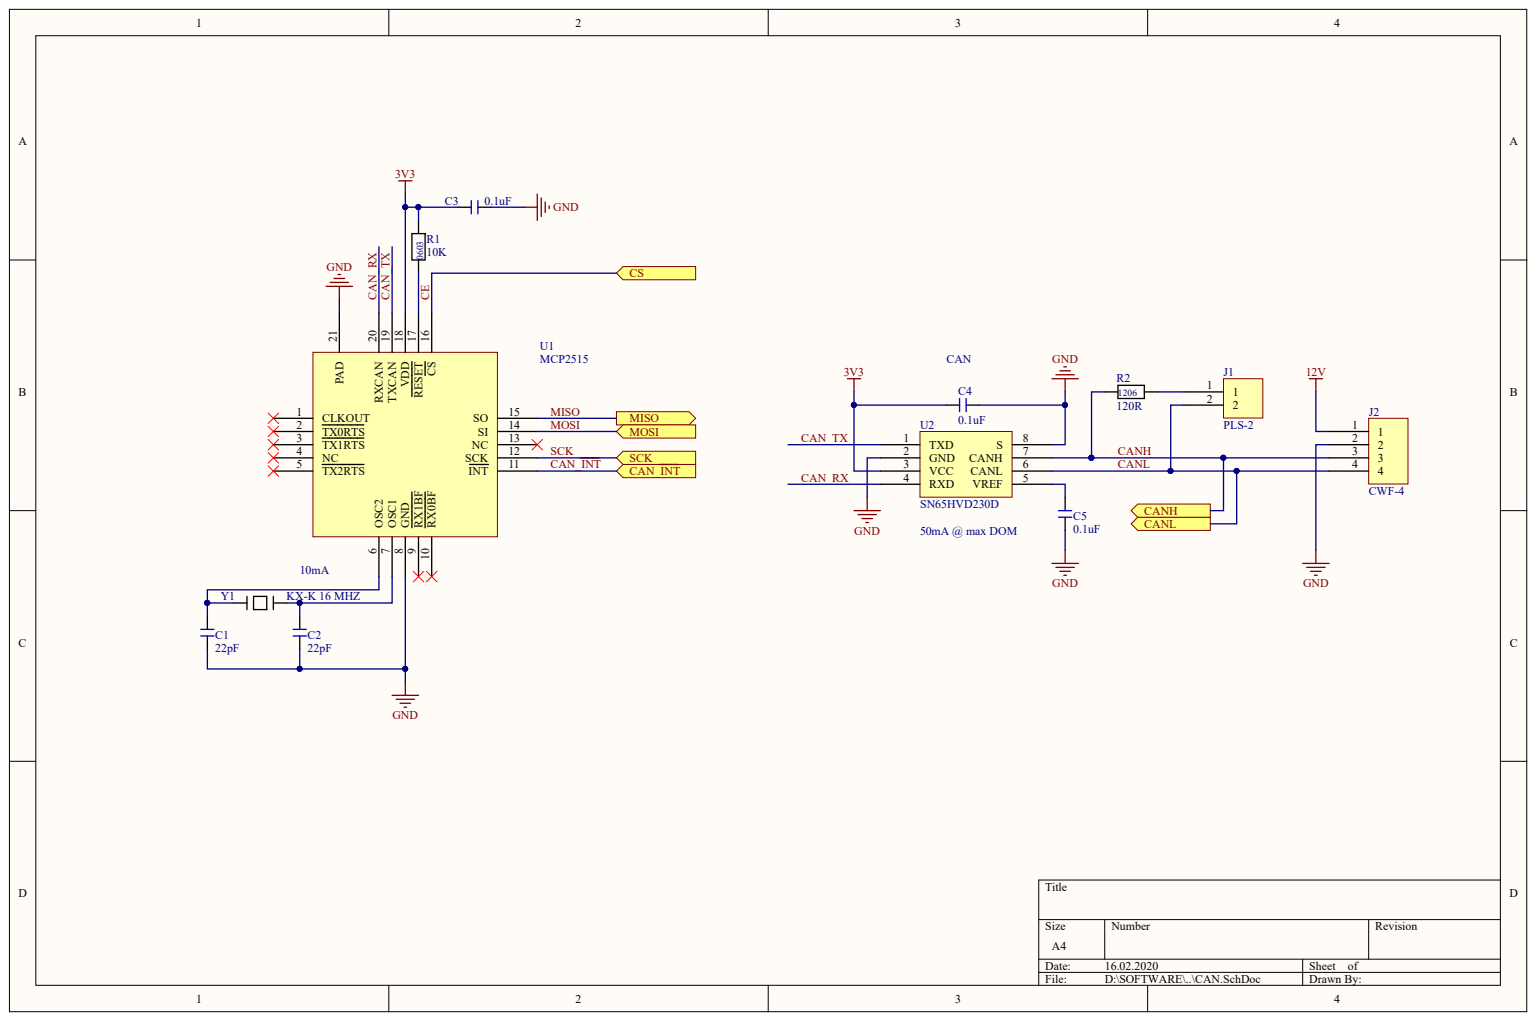
[picture p72: page 1]

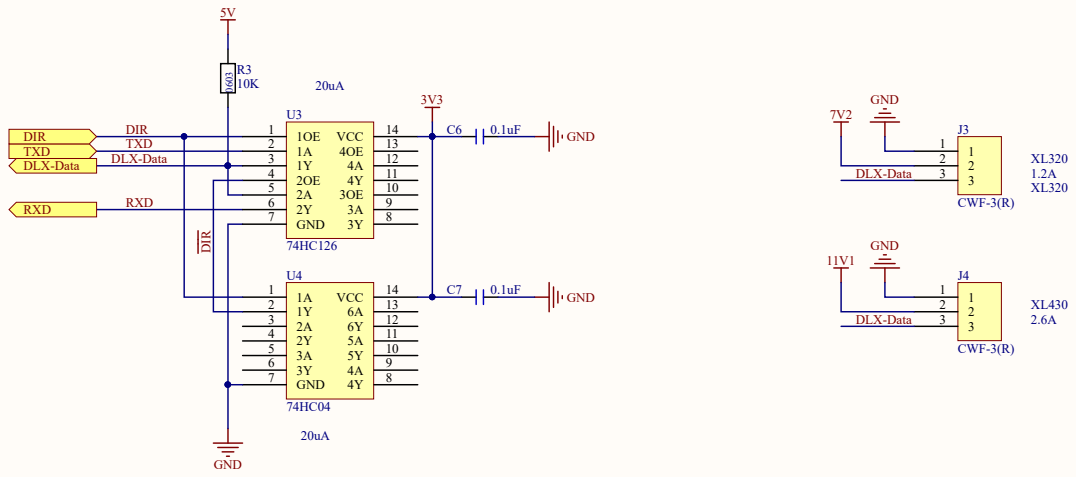
[picture p73: page 2]

DIR
TXD
DLX-Data

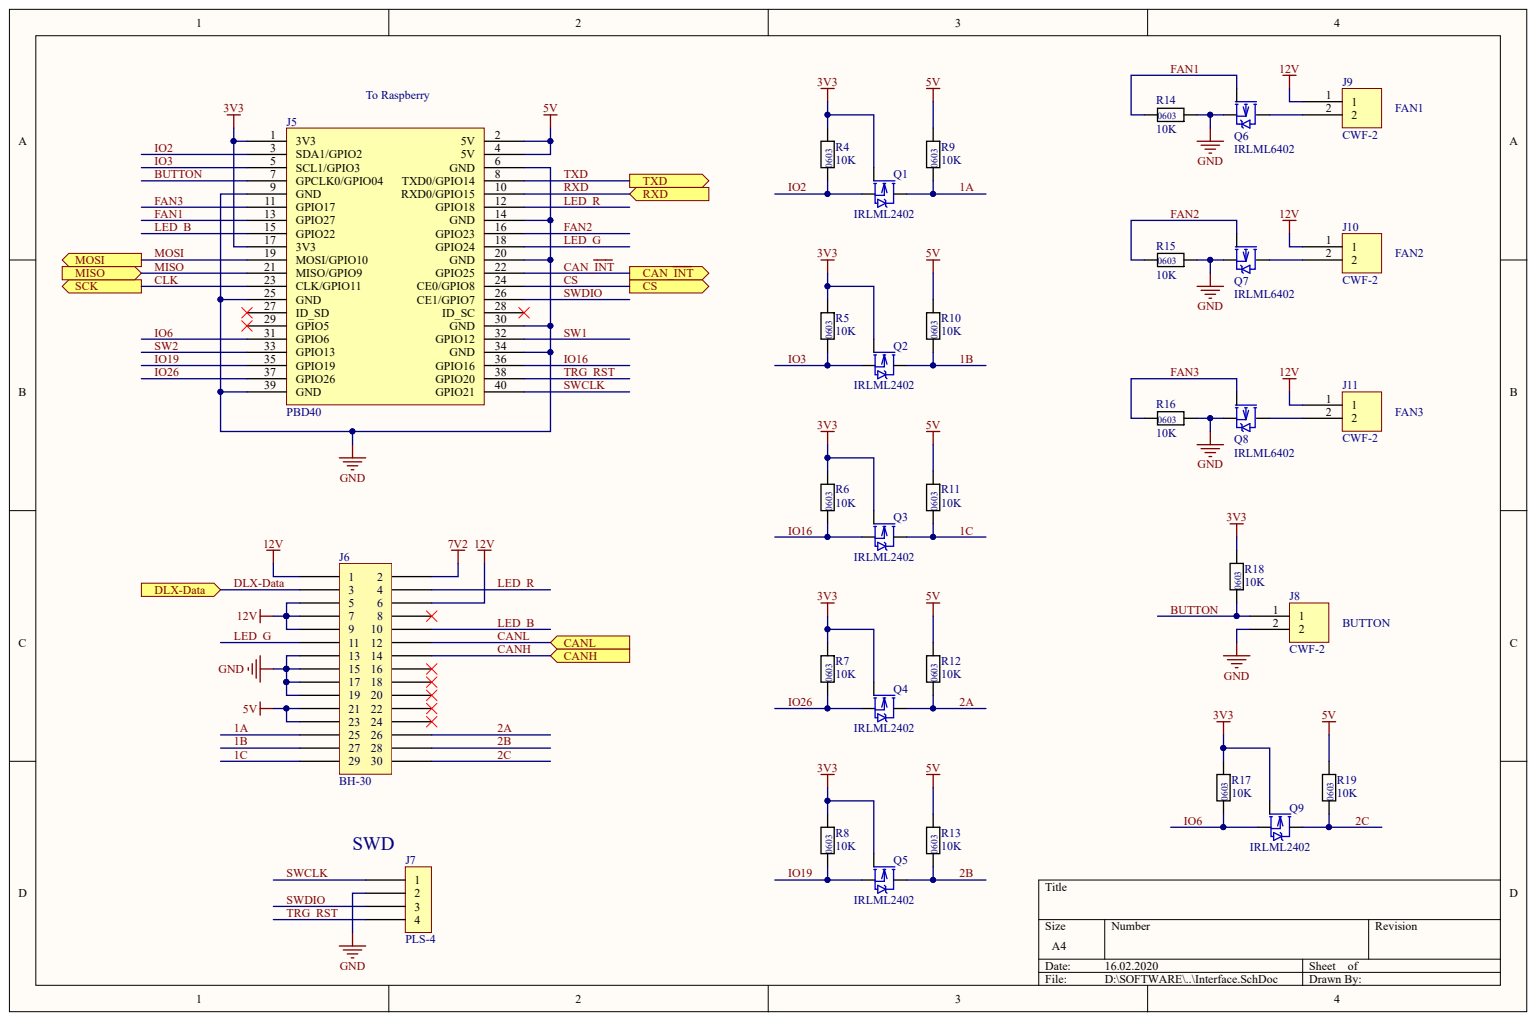
[picture p74: page 3]

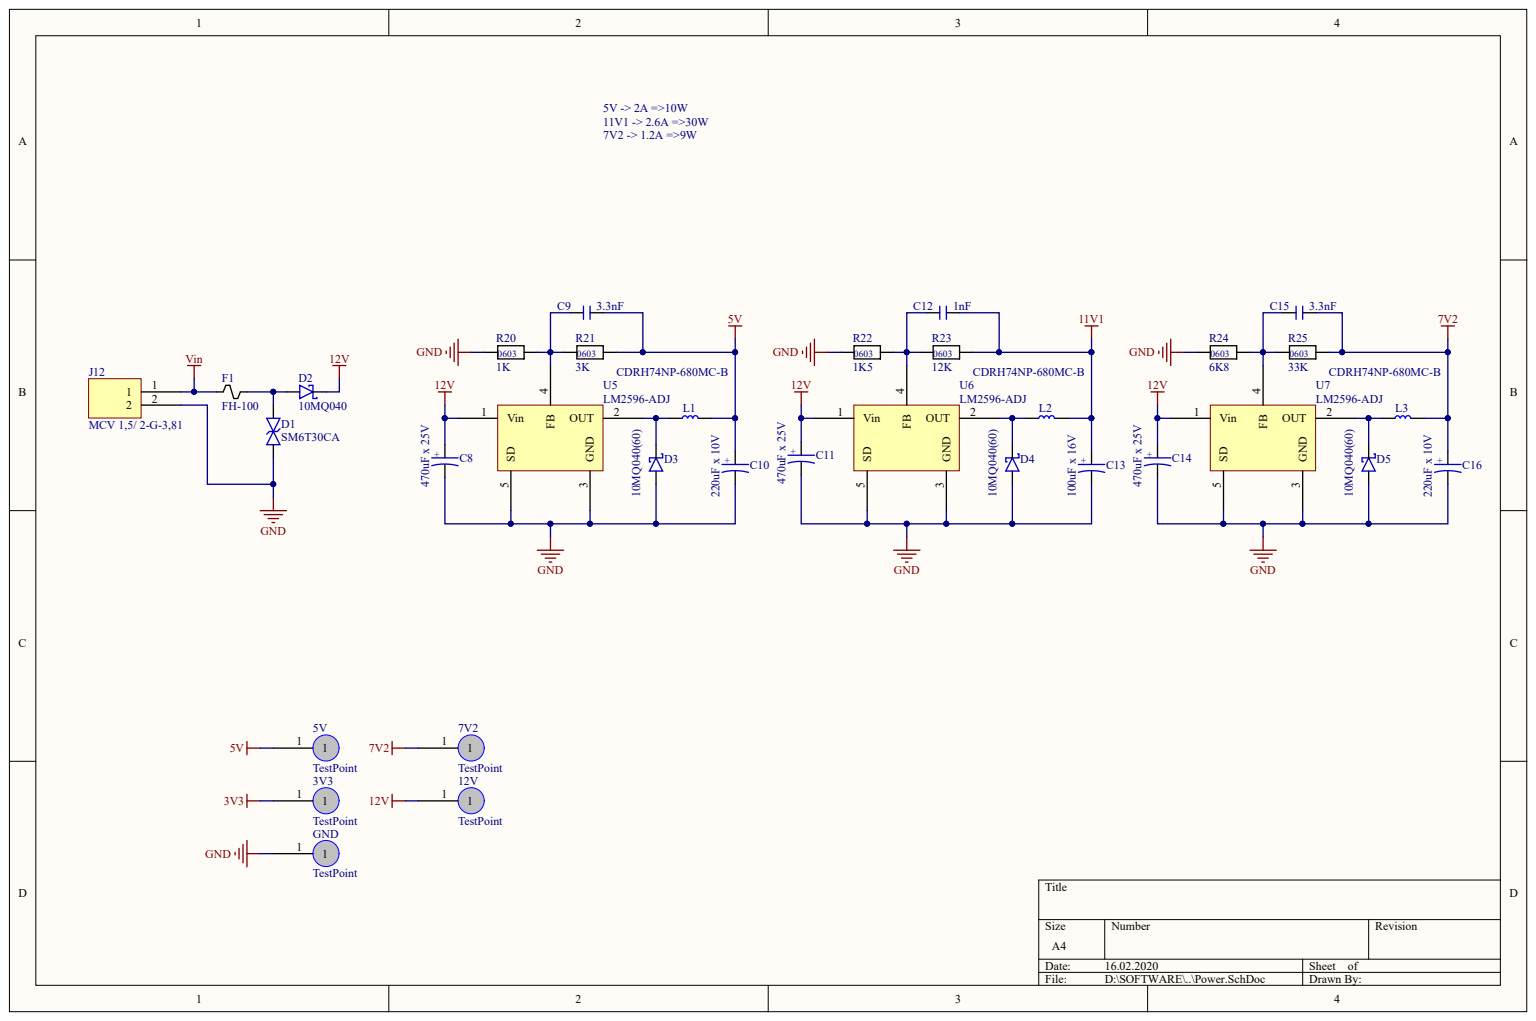
[picture p75: page 4]
