marcostrullato/open_niryo_one/Electronics/RPi_adapter/OUT/R2/schematic.pdf

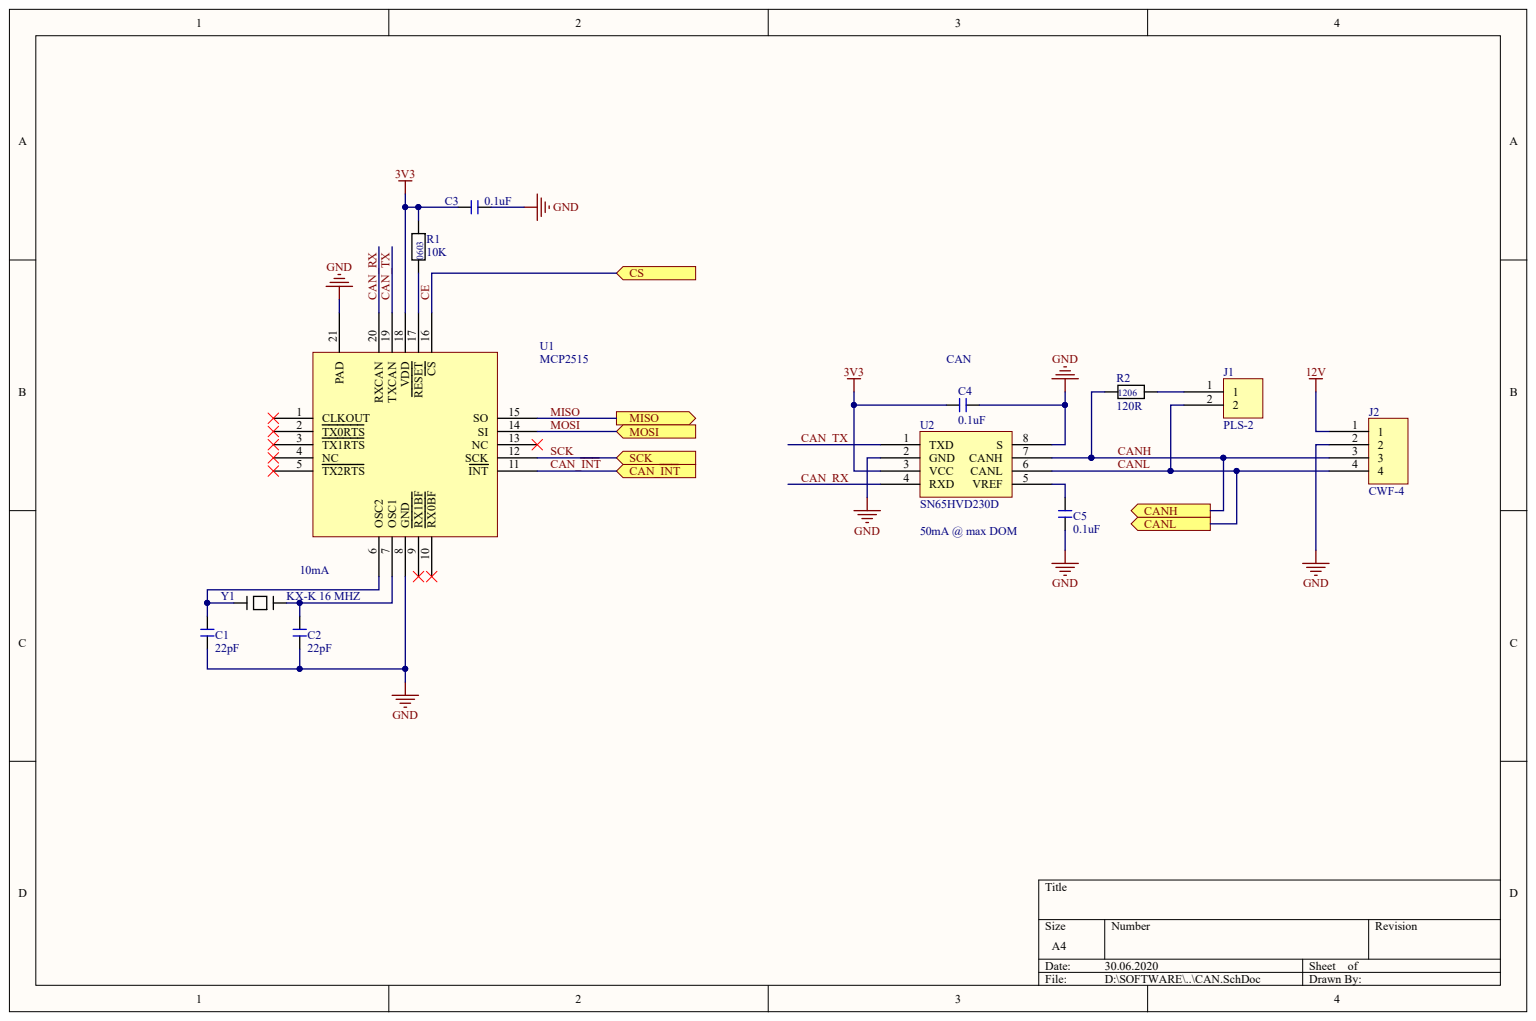
[picture p76: page 1]


DIR
TXD
DLX-Data

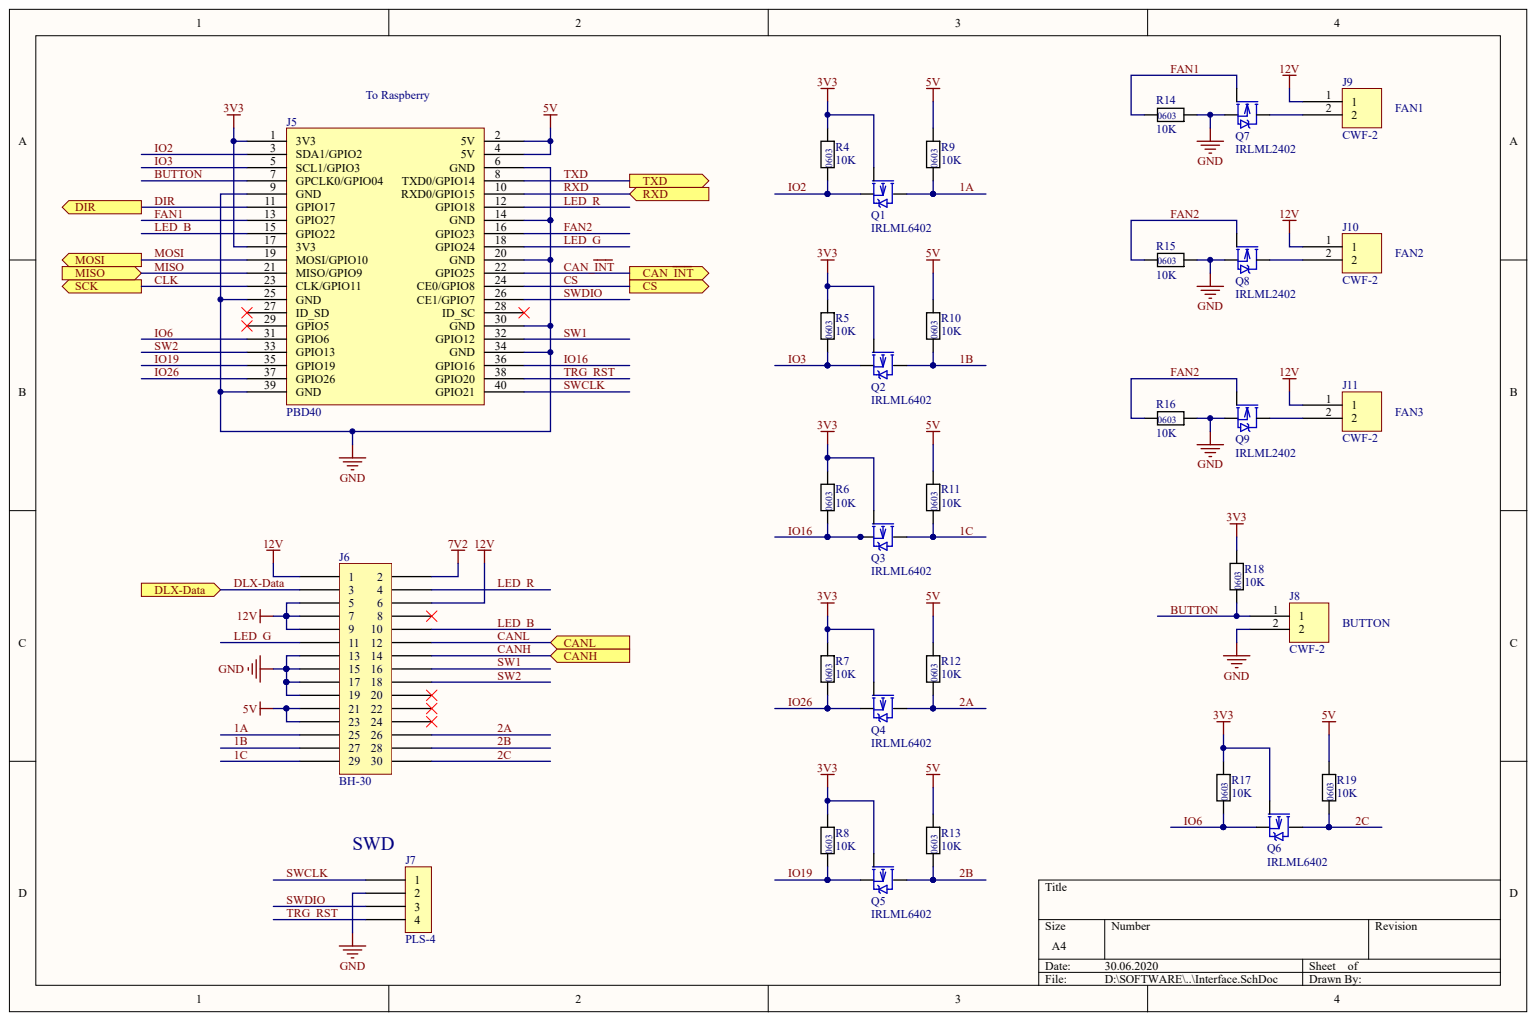
[picture p77: page 3]

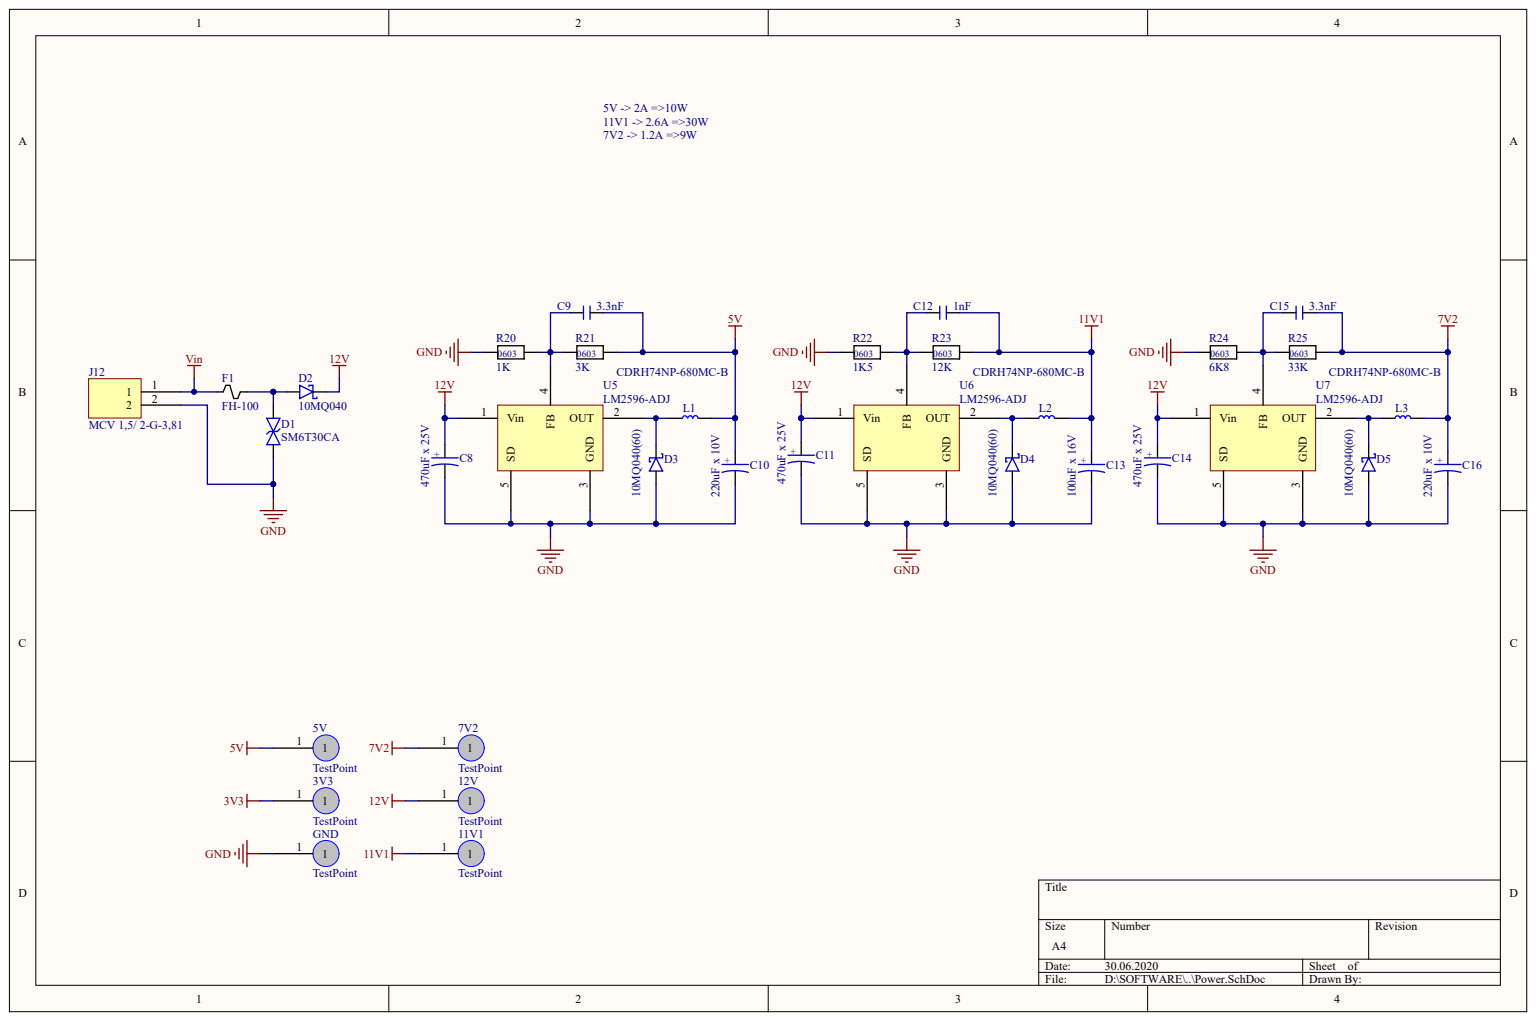
[picture p78: page 4]
