marcostrullato/open_niryo_one/Electronics/Stepper/OUT/R1/Stepper PCB shematic.pdf

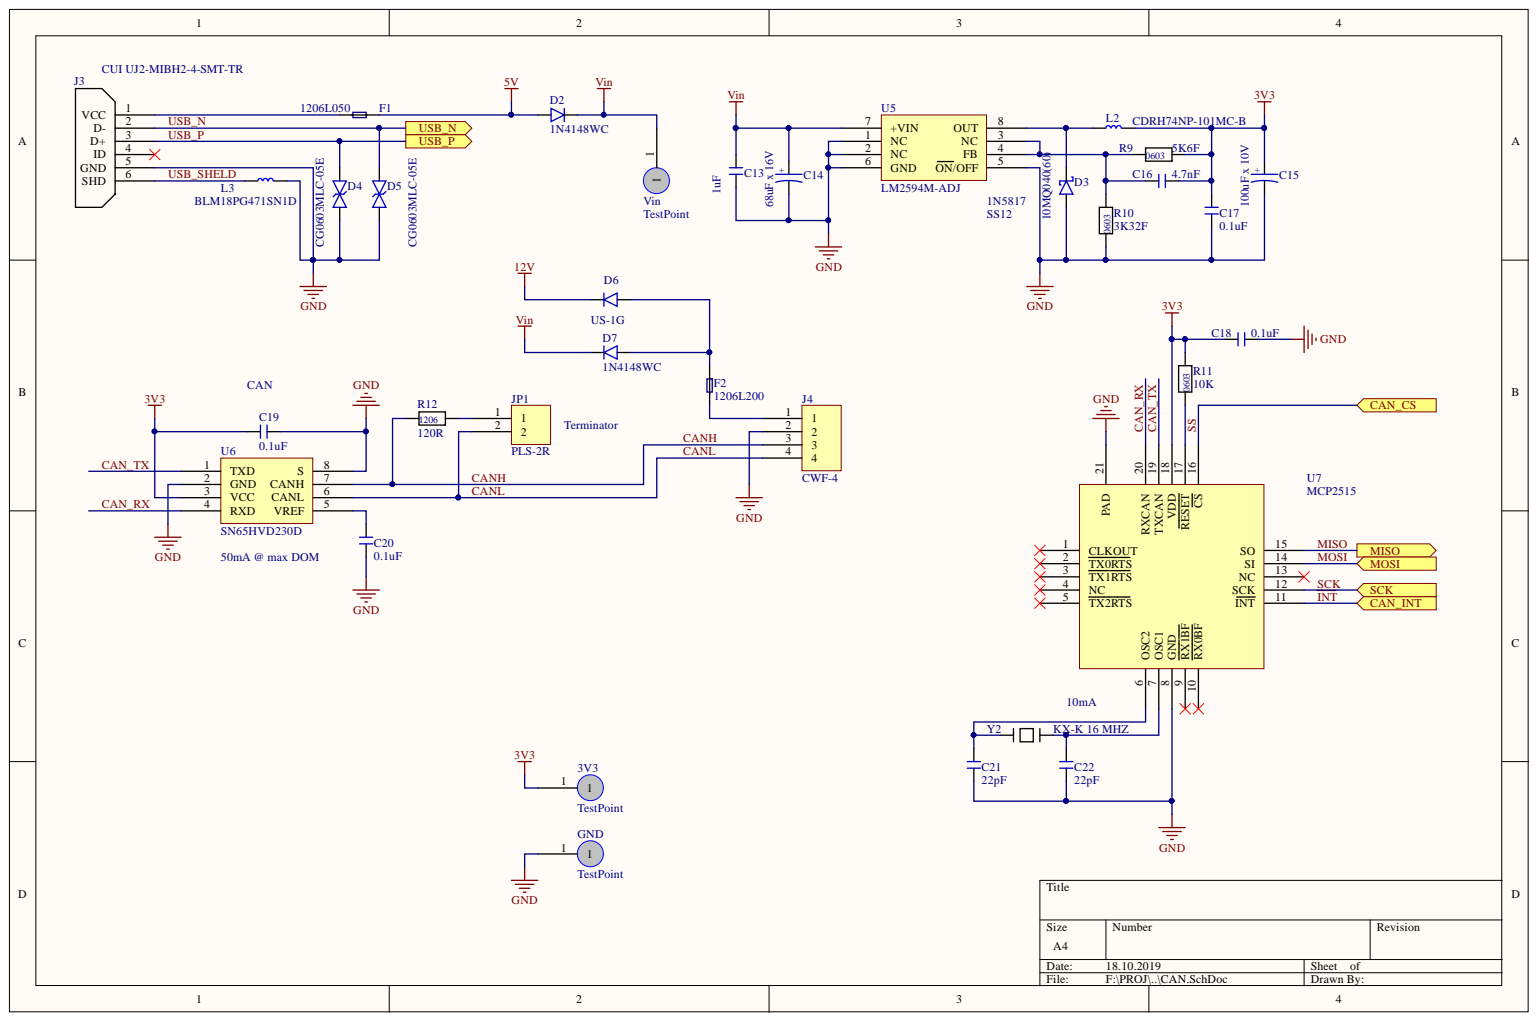
[picture p79: page 1]

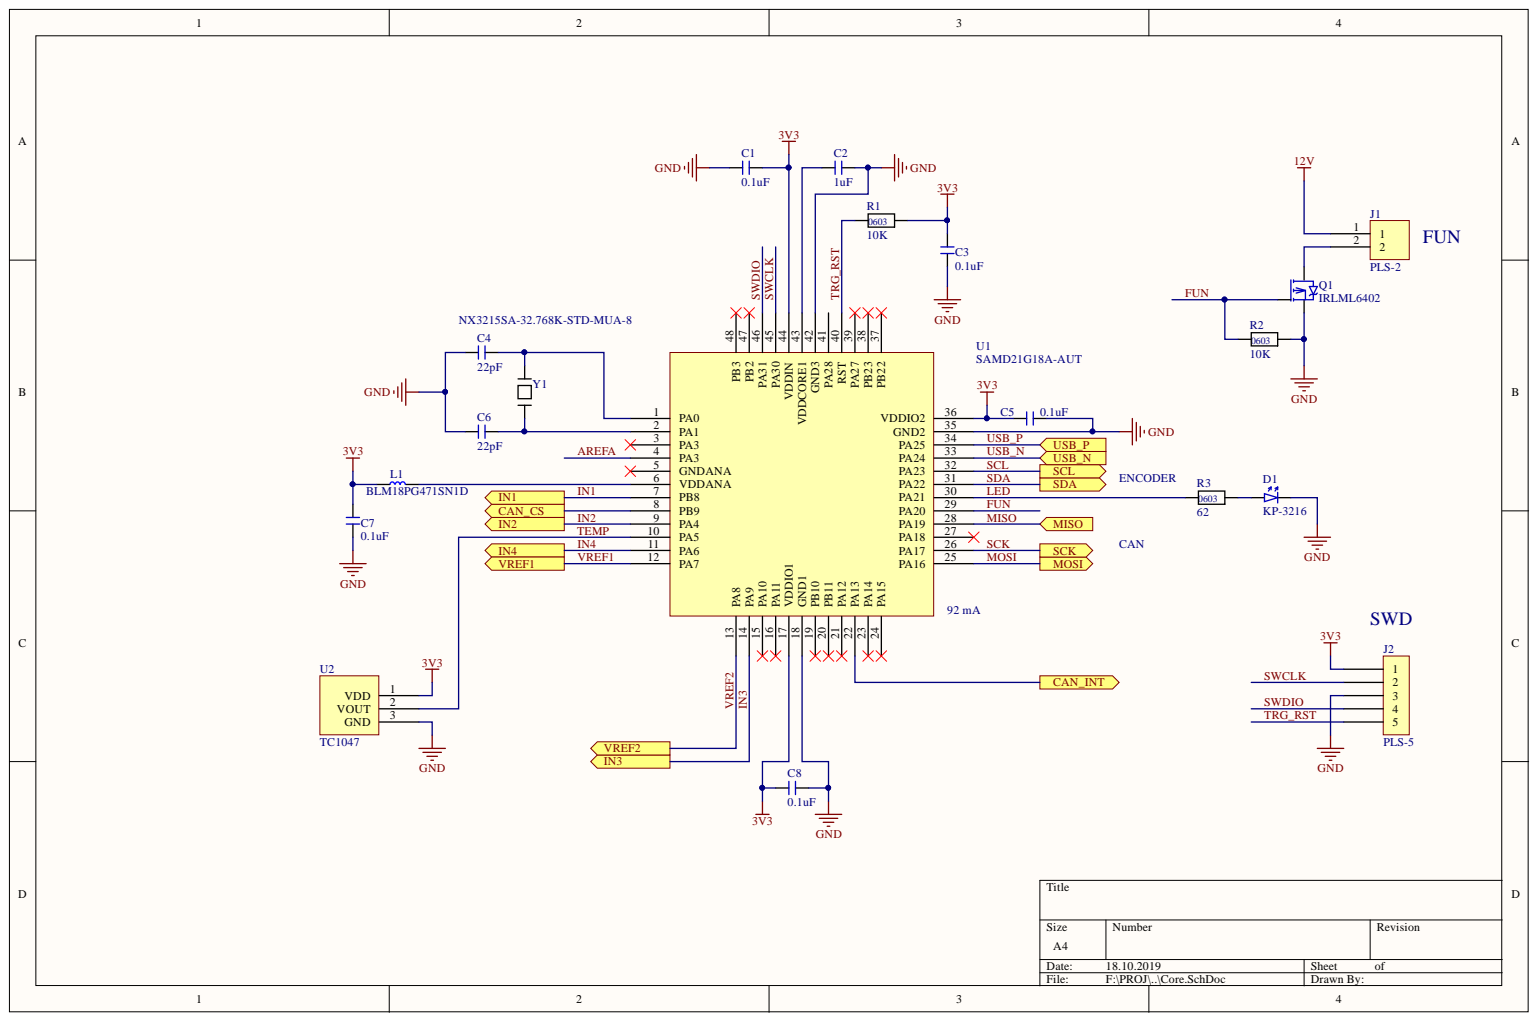
[picture p80: page 2]

IN4 IN4 VREF1 VREF1 3V3 | PA6 11 PA7 12

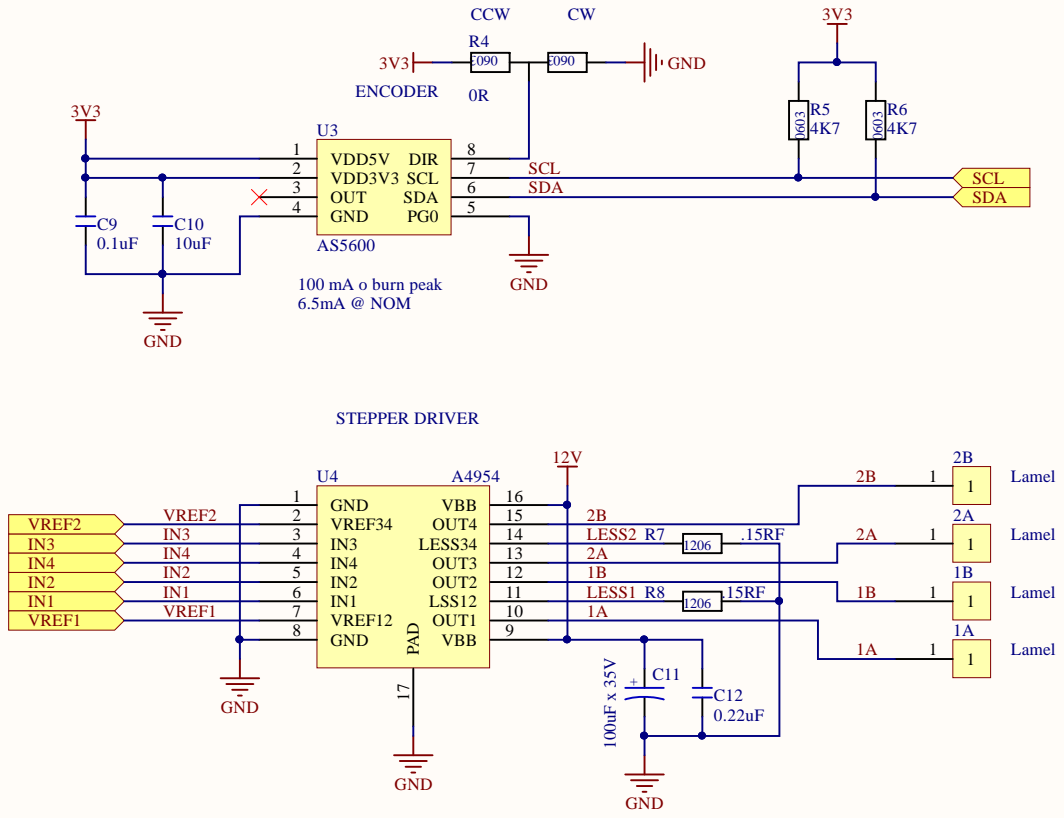
[picture p81: page 3]

VDD3V3 2 | | SCL
OUT 3 | | SDA
