marcostrullato/open_niryo_one/(list of files, drawings)

Other design files:
Electronics/Panel/PCB/niryoPanel/Interface.SchDoc
Electronics/Panel/PCB/niryoPanel/niryoPanel.PrjPcb
Electronics/Panel/PCB/niryoPanel/panel.PcbDoc
Electronics/RPi_adapter/PCB/CAN.SchDoc
Electronics/RPi_adapter/PCB/Dynamixel.SchDoc
Electronics/RPi_adapter/PCB/Interface.SchDoc
Electronics/RPi_adapter/PCB/niryoRpiAdapter.PrjPCB
Electronics/RPi_adapter/PCB/Power.SchDoc
Electronics/Stepper/PCB/CAN.SchDoc
Electronics/Stepper/PCB/Core.SchDoc
Electronics/Stepper/PCB/niryoStepperController.PrjPcb
Electronics/Stepper/PCB/Stepper.SchDoc
