marcostrullato/open_niryo_one/(commit log)

2019-07-23 First sch commit
    [CAN.SchDoc, Core.SchDoc, PCBmaket.stp, Stepper.SchDoc, niryoStepperController.PrjPcb, stepperPCB.PcbDoc]
2019-07-25 USB schem start.
    [CAN.SchDoc, Core.SchDoc, Stepper.SchDoc, niryoStepperController.PrjPcb, stepperPCB.PcbDoc]
2019-07-25 Power management
    [CAN.SchDoc, Core.SchDoc, Stepper.SchDoc, niryoStepperController.PrjPcb]
2019-07-26 Stepper driver and power changing
    [BOM_niryoStepperController.xls, CAN.SchDoc, Core.CSV, Core.SchDoc, Stepper.SchDoc, niryoStepperController.PrjPcb]
2019-07-29 Take smaller components.
    [CAN.SchDoc, Core.SchDoc, PCBmaket.stp, Stepper.SchDoc, niryoStepperController.PrjPcb, stepperPCB.PcbDoc]
2019-07-31 Placed power components on PCB. PLS-5 (SWD) go to PLS2-5
    [Core.SchDoc, stepperPCB.PcbDoc]
2019-08-01 In progress
    [CAN.SchDoc, Core.SchDoc, Stepper.SchDoc, stepperPCB.PcbDoc]
2019-08-02 Start summary BOM (no engines and electric)
    [Summary BOM.xlsx]
2019-08-02 3d model and blueprint of Aluminium tube
    [Aluminium Tube.stp]
2019-08-02 PCB design
    [CAN.SchDoc, Core.SchDoc, Stepper.SchDoc, stepperPCB.PcbDoc]
2019-08-07 Stepper PCB tracing ready
    [CAN.SchDoc, Core.SchDoc, Stepper.SchDoc]
2019-08-16 Sink edit + add test points for power
    [CAN.SchDoc, Core.SchDoc, Stepper.SchDoc, niryoStepperController.PrjPcb]
2019-08-19 Add extra gnd via
    [stepperPCB.PcbDoc]
2019-08-19 Add GBR and CAM output files
    [stepperPCB.PcbDoc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]
2019-08-19 Gerber archive for order
    [stepperPCB.DRL]
2019-08-21 New 3D files
    [30mm Fan.step, NEMA17 - Motor de passo.stp, PCBmaket.stp, niryoStepperController.PrjPcb, stepperPCB.PcbDoc]
2019-08-26 Added an updated BOM
    [Arm BOM.ods]
2019-08-26 Merged with the BOM for the stepper shield
    [Arm BOM.ods]
2019-08-26 Added the stl file for the tube
    [BOM_niryoStepperController.xls, Niryo_One_Aluminum_Tube.stl, Summary BOM.xlsx]
2019-08-29 New 3d model and blueprint for the tubes
    [Aluminium Tube.stp]
2019-08-29 PCB readme
2019-09-13 prime cost calculation (~16$)
    [Arm BOM.ods]
2019-09-16 Stepper PCB BOM update.
    [Arm BOM.ods, CAN.SchDoc, Core.SchDoc, Stepper.SchDoc, niryoStepperController.PrjPcb, stepperPCB.PcbDoc]
2019-09-16 added info about dynamixel engines
    [XL-320.dwg, XL-320.igs, XL-320.stp]
2019-09-18 New GBR of Stepper PCB - change hols sizes
    [Stepper.SchDoc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]
2019-10-02 Stepper PCB ready for order at jlcpcb.com
    [niryoStepperController.PrjPcb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]
2019-10-09 Change some names of components in BOM (Stepper PCB)
    [Arm BOM.ods]
2019-10-10 Add stepper names and some another position to BOM
    [Arm BOM.ods]
2019-10-10 Stepper PCB assembly drawing
    [niryoStepperController.PrjPcb]
2019-10-13 Raspberry pi adapter schematic start
    [CAN.SchDoc, Dynamixel.SchDoc, Interface.SchDoc, Power.SchDoc, niryoRpiAdapter.PrjPCB]
2019-10-14 level matching (3V3 on RPi and 5V on extern board)
    [Interface.SchDoc]
2019-10-16 Power managment 11.1 & 7.2 V
    [Dynamixel.SchDoc, Power.SchDoc]
2019-10-18 Power management, wiring draw
    [CAN.SchDoc, CHU2.step, CHU3.step, CHU4.step, Dynamixel.SchDoc, Interface.SchDoc, PCB_shape.stp, Power.SchDoc]
2019-10-24 First PCB sketch
    [CAN.SchDoc, Dynamixel.SchDoc, Interface.SchDoc, Power.SchDoc, RpiAdapterPCB.PcbDoc, niryoStepperController.PrjPcb]
2019-11-07 Error List for Stepper PCB.
2019-11-08 Wiring harness demo
2019-12-04 Spring draw & model
    [Spring for Open Niryo One.stp]
2019-12-05 Steal fo Gripper1 draw & model
    [Steal for Gripper1.stp]
2019-12-06 bootloader description
    [rpi3.cfg]
2019-12-06 Start of Stepper PCB second revision
    [CAN.SchDoc, Core.SchDoc, PCBmaket.stp, Stepper.SchDoc, niryoStepperController.PrjPcb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]
2019-12-10 Most traces ready
    [CAN.SchDoc, Core.SchDoc, RpiAdapterPCB.PcbDoc, Stepper.SchDoc]
2019-12-11 New USB footprint
    [CAN.SchDoc, stepperPCB.PcbDoc]
2019-12-13 5V from USB + GND poligons + theadrops
    [CAN.SchDoc, Core.SchDoc, Stepper.SchDoc]
2019-12-13 Stepper PCB R2
    [CAN.SchDoc, Core.SchDoc, niryoStepperController.PrjPcb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]
2019-12-14 Add rendor of Stepper PCB
2019-12-18 Panel PCB
    [Dynamixel.SchDoc, Interface.SchDoc, PCB_shape.stp, Power.SchDoc, niryoPanel.PrjPcb, niryoStepperController.PrjPcb, panel.PcbDoc]
2019-12-18 Pri Adapter in work
    [CAN.SchDoc, Dynamixel.SchDoc, Interface.SchDoc, Power.SchDoc, RpiAdapterPCB.PcbDoc]
2019-12-30 New panel pcb shape.
    [Interface.SchDoc, PCB_shape.stp, panel.PcbDoc]
2020-01-10 Update stepper PCB output files
    [CAN.SchDoc, Core.SchDoc, niryoStepperController.PrjPcb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]
2020-01-14 No passive filter for analog input of stepper driver (A4954)
    [Stepper.SchDoc, niryoStepperController.PrjPcb]
2020-01-16 Stepper PCB output files update
    [Assembly Testpoint Report for stepperPCB.csv, BOM.xlsx, CAN.SchDoc, Core.SchDoc, Stepper.SchDoc, niryoStepperController.PrjPcb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]
2020-01-17 update Steal for Gripper1
2020-01-22 Add pick&place for steppe PCB
    [Pick Place for stepperPCB.csv, stepperPCB.CSV]
2020-01-23 production requirements for PCB
2020-01-29 Verify CAN Interface.
    [CAN.SchDoc, Interface.SchDoc, niryoStepperController.PrjPcb]
2020-02-04 BOM issuses
    [BOM.xlsx]
2020-02-05 New USB and CWF-4 part numbers
    [BOM.xlsx]
2020-02-05 RPI hat PCB update
    [BOM.xlsx, CAN.SchDoc, Interface.SchDoc, RpiAdapterPCB.PcbDoc]
2020-02-06 End of tracing of Raspberry hat.
    [Interface.SchDoc, Power.SchDoc, RpiAdapterPCB.PcbDoc]
2020-02-11 Raspberry pi PCB for review.
    [Power.SchDoc]
2020-02-16 Gerber for raspberry hat + BOM
    [Dynamixel.SchDoc, Power.SchDoc, RPI_Hat_BOM.xlsx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]
2020-02-16 Schematic pdf for raspberry pi hat
2020-02-16 Gerber and schematic pdf of panel
    [Interface.SchDoc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]
2020-02-18 Stepper BOM final update
    [BOM.xlsx]
2020-03-16 Stepper PCB spacer
    [Stepper spacer.stl]
2020-03-17 Coupling shafts
    [Coupling Shaft Blue Motor.stl, Coupling Shaft Green Motor.stl, Coupling Shaft Green Motor.stp, Coupling Shaft Red Motor.stl, Coupling Shaft Red Motor.stp]
2020-03-30 Coupling shaft issues
    [Coupling Shaft Blue Motor.stl, Coupling Shaft Blue Motor.stp, Coupling Shaft Green Motor.stl, Coupling Shaft Green Motor.stp]
2020-06-30 Stepper case STL + STEP + source 3D models
    [Stepper cover.stl, Stepper cover.stp, Stepper fan cover.stp]
2020-06-30 Error list for RPi adaptor Rev.1
    [Interface.SchDoc]
2020-06-30 RPi adapter revision 2
    [BOM.xlsx, Power.SchDoc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]
